rbakx/MyExoMy/Pictures/MyExoMy2.jpg

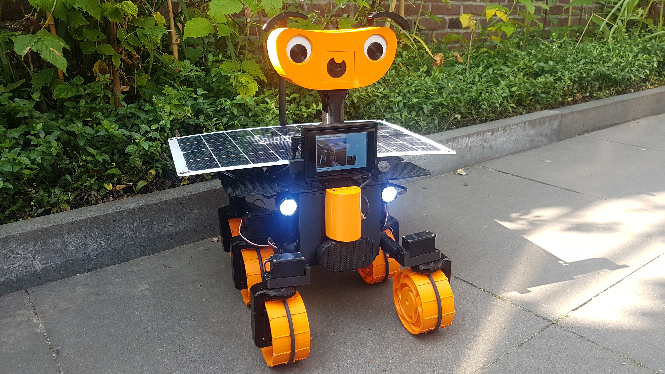
Pictures/MyExoMy2.jpg
