rbakx/MyExoMy/Pictures/MyExoMy3.jpg

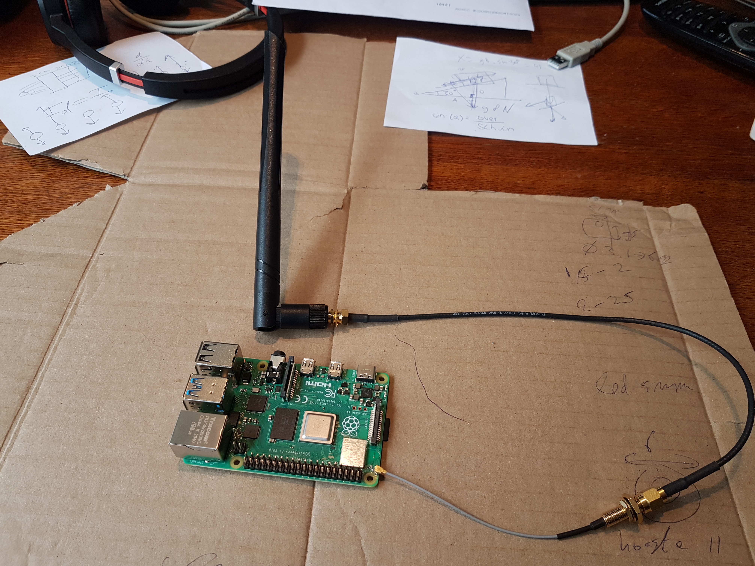
Pictures/MyExoMy3.jpg
