rbakx/MyExoMy/Original_ExoMy Release v1.0.2/README.md

# Release Description

## Bill of Material (BoM)
Contains the purchasing list and a list with recommended print settings of all printed parts.

## Electrical_Drawings
Contains PDF, SVG and JPG of the breadboard as well as the electrical schematic.

## Parts
Contains STL-files for 3D printing, step files for modifications and pictures of all parts and assemblies for visualization.

The naming convention is:

`FILENAME+CONFIGURATION`

and for multi color prints:

`FILENAME+CONFIGURATION+COLOR_NR`

## Technical_Drawings
Contains the technical drawings as PDF and JPEG. And a CSV-file of the bill of material, that is present on the drawing.

## Optional Parts
Contains serval addons that can be used to pimp ExoMy
