rbakx/MyExoMy/Original_ExoMy Release v1.0.2/Parts/PNG/A01_ExoMy_AI_Chassis.png

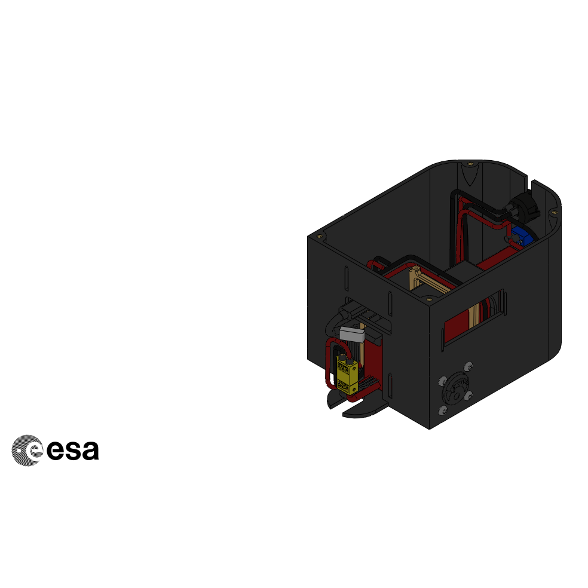
Original_ExoMy Release v1.0.2/Parts/PNG/A01_ExoMy_AI_Chassis.png
