rbakx/MyExoMy/Original_ExoMy Release v1.0.2/Parts/PNG/P01_Chassis_Default.png

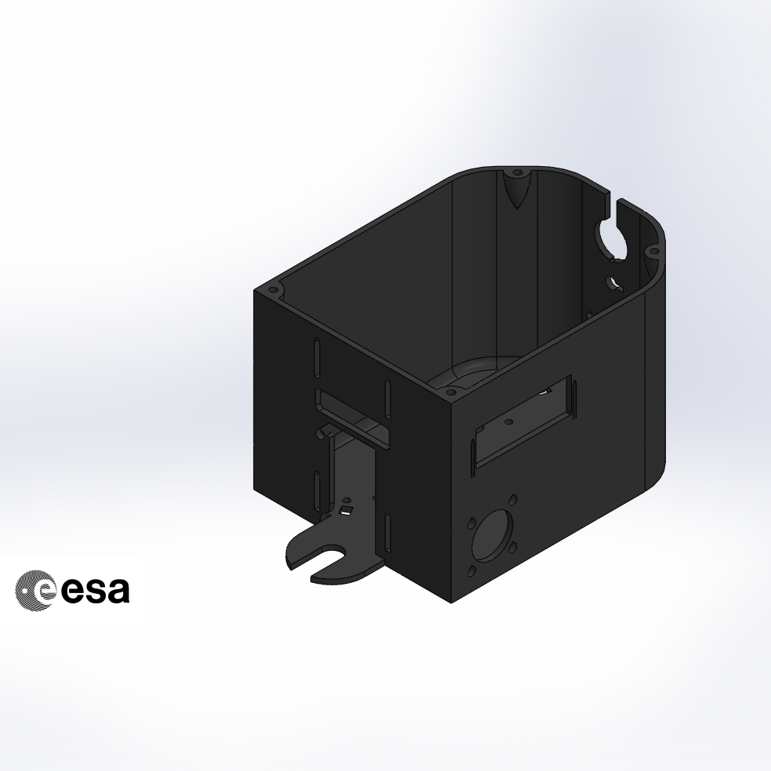
Original_ExoMy Release v1.0.2/Parts/PNG/P01_Chassis_Default.png
