rbakx/MyExoMy/Original_ExoMy Release v1.0.2/Parts/PNG/P06_Spacing_Concept_Default.png

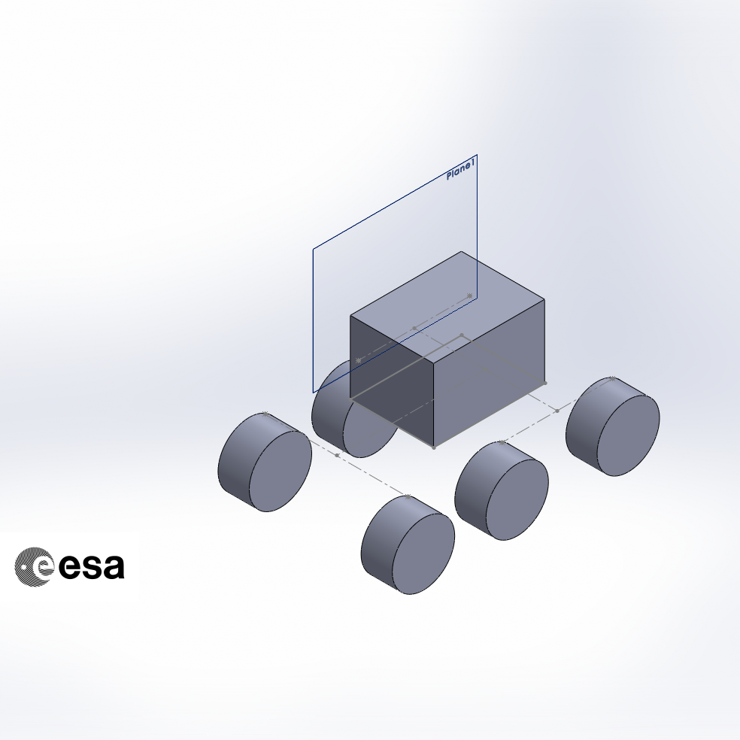
Original_ExoMy Release v1.0.2/Parts/PNG/P06_Spacing_Concept_Default.png
