rbakx/MyExoMy/Original_ExoMy Release v1.0.2/Technical_Drawings/JPEG/AI_Chassis_BoM.jpg

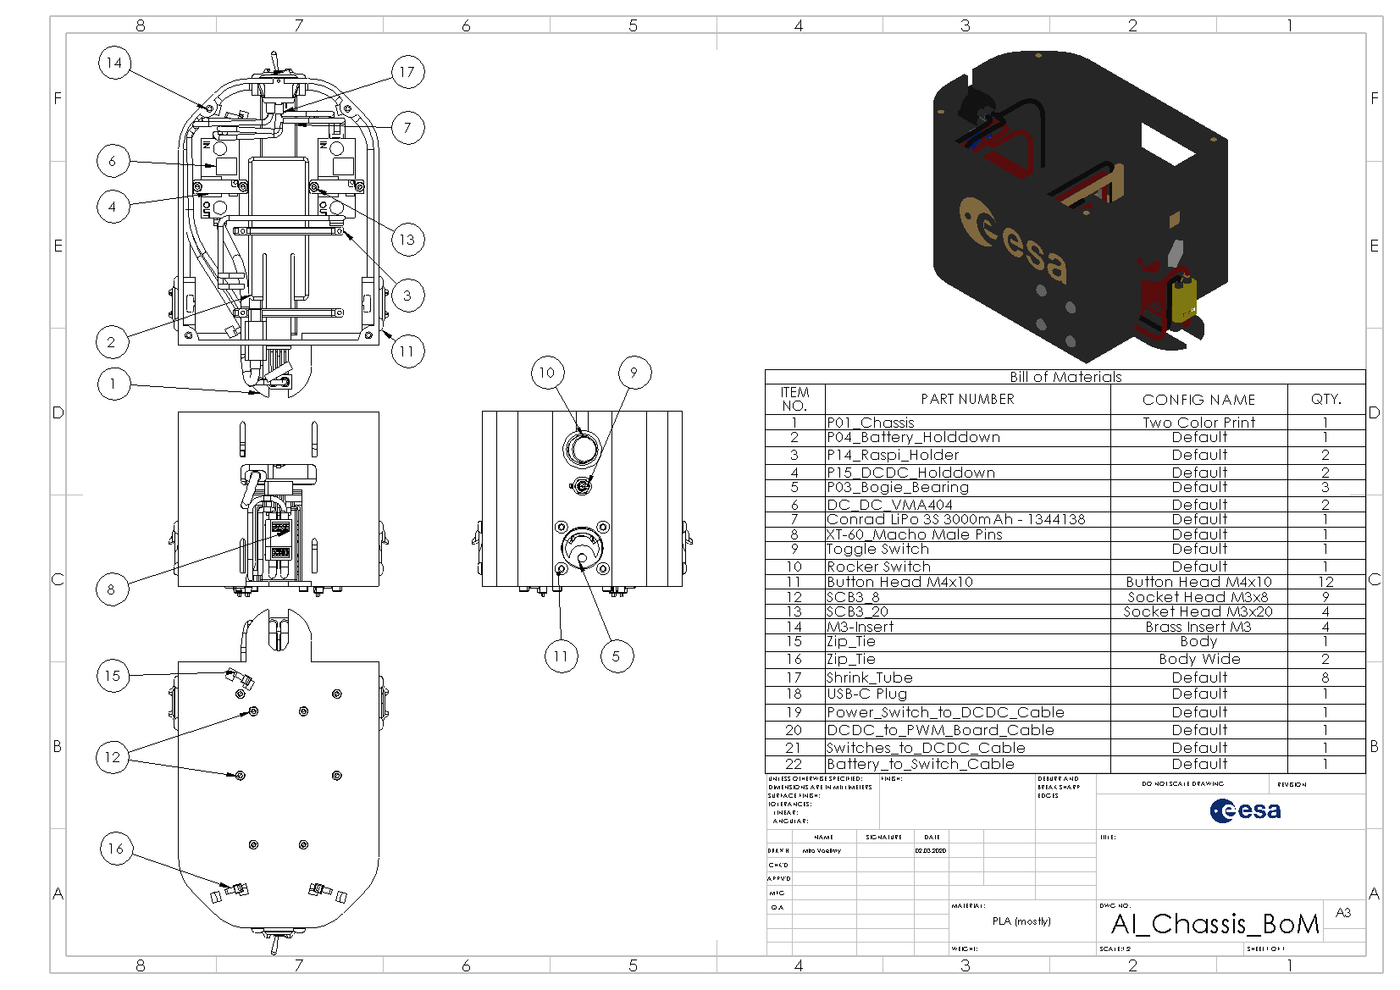
Original_ExoMy Release v1.0.2/Technical_Drawings/JPEG/AI_Chassis_BoM.jpg
