rbakx/MyExoMy/Original_ExoMy Release v1.0.2/Technical_Drawings/JPEG/MI_Wire_Harness_BoM.jpg

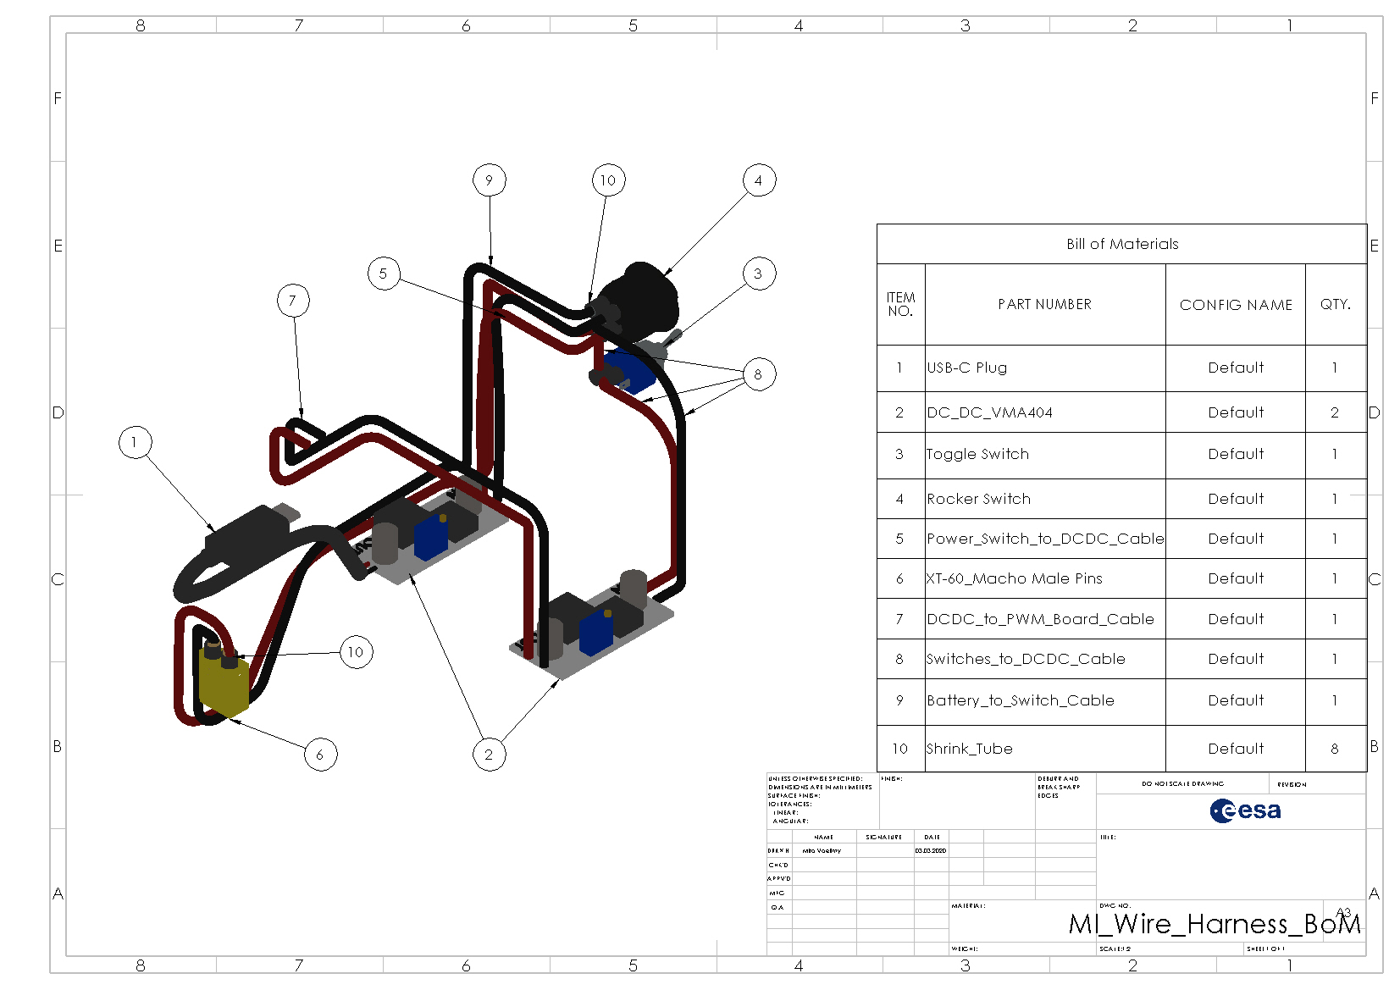
Original_ExoMy Release v1.0.2/Technical_Drawings/JPEG/MI_Wire_Harness_BoM.jpg
