rbakx/MyExoMy/Pictures/MyExoMy4.jpg

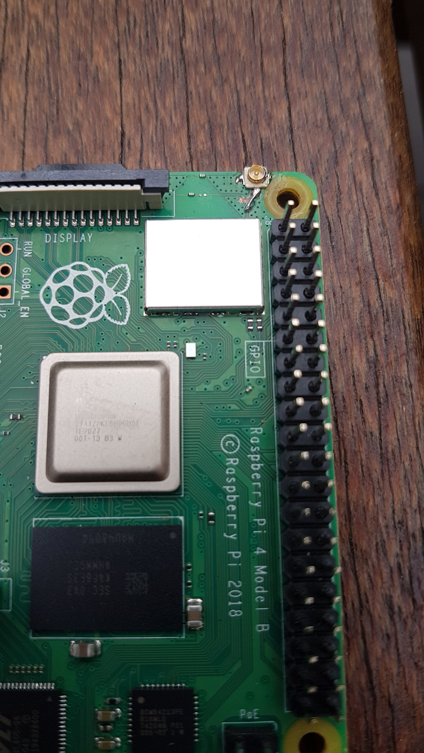
Pictures/MyExoMy4.jpg
