rbakx/MyExoMy/Original_ExoMy Release v1.0.2/Optional_Parts/PNG/A07_Neck_Decoration_Default.png

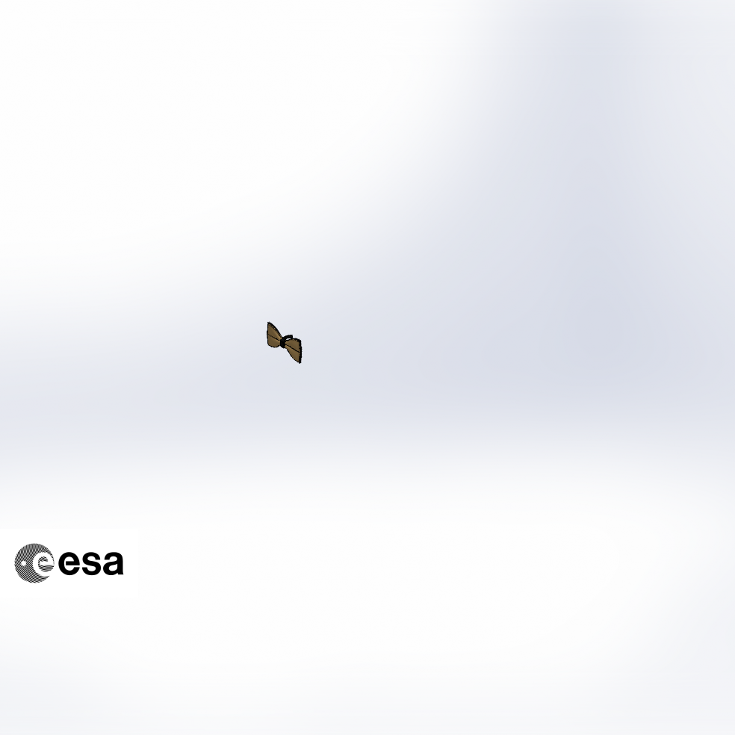
Original_ExoMy Release v1.0.2/Optional_Parts/PNG/A07_Neck_Decoration_Default.png
