rbakx/MyExoMy/Original_ExoMy Release v1.0.2/Optional_Parts/PNG/P34_Hat_Rack_Default.png

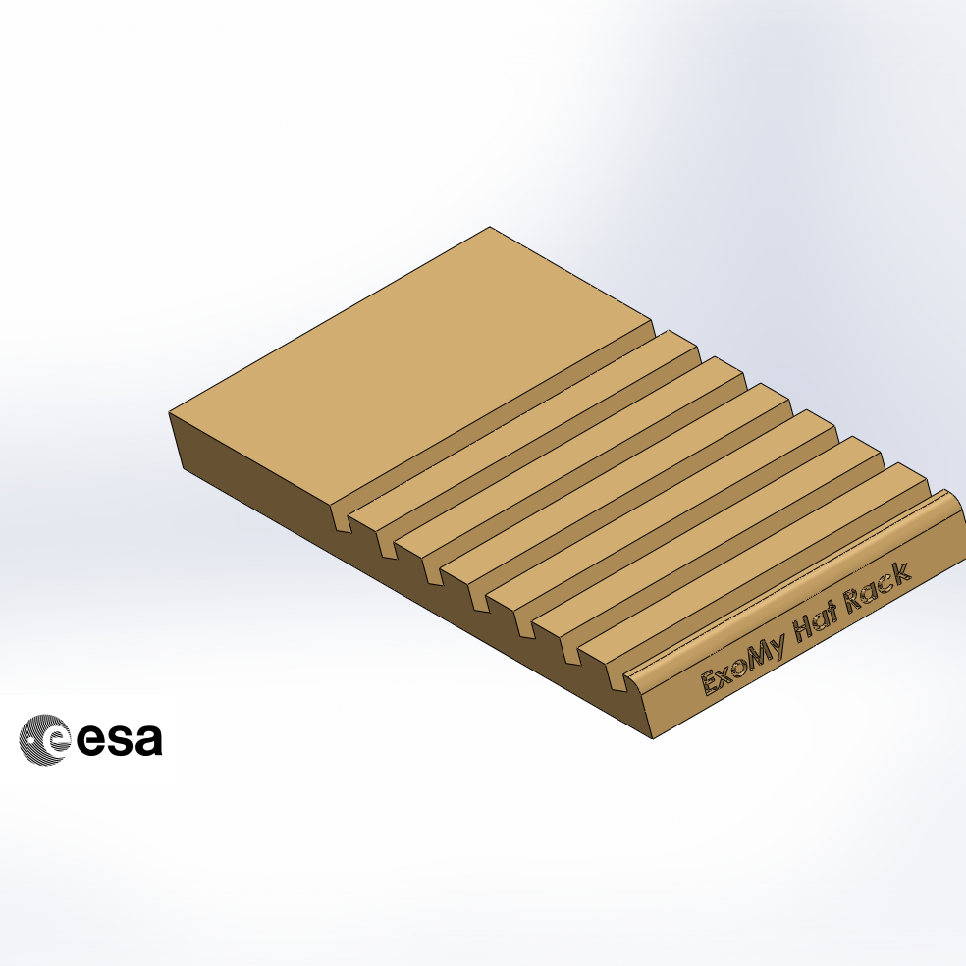
Original_ExoMy Release v1.0.2/Optional_Parts/PNG/P34_Hat_Rack_Default.png
