rbakx/MyExoMy/Original_ExoMy Release v1.0.2/Optional_Parts/PNG/P35_Neck_Clip_Default.png

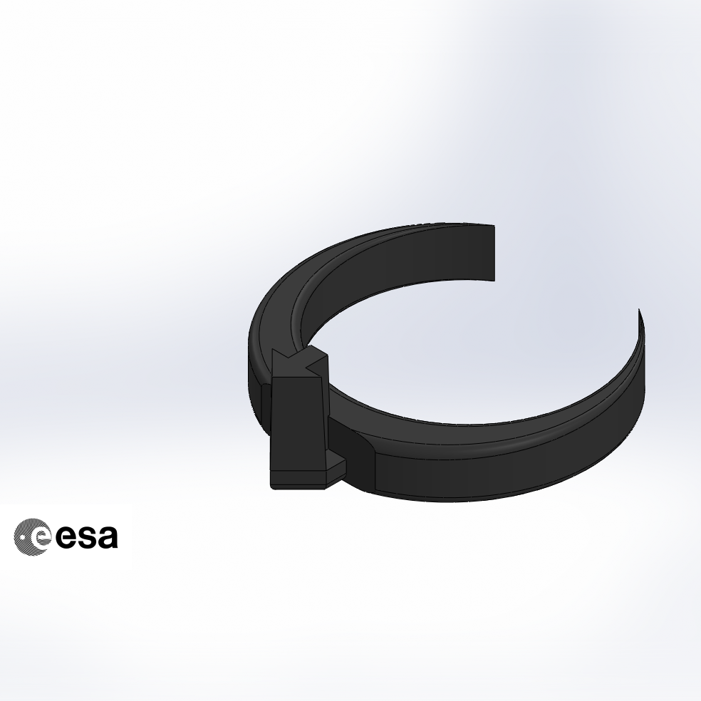
Original_ExoMy Release v1.0.2/Optional_Parts/PNG/P35_Neck_Clip_Default.png
