rbakx/MyExoMy/Original_ExoMy Release v1.0.2/Optional_Parts/PNG/P37_Wheel_Sleeve_Full_Sleeve_Left.PNG

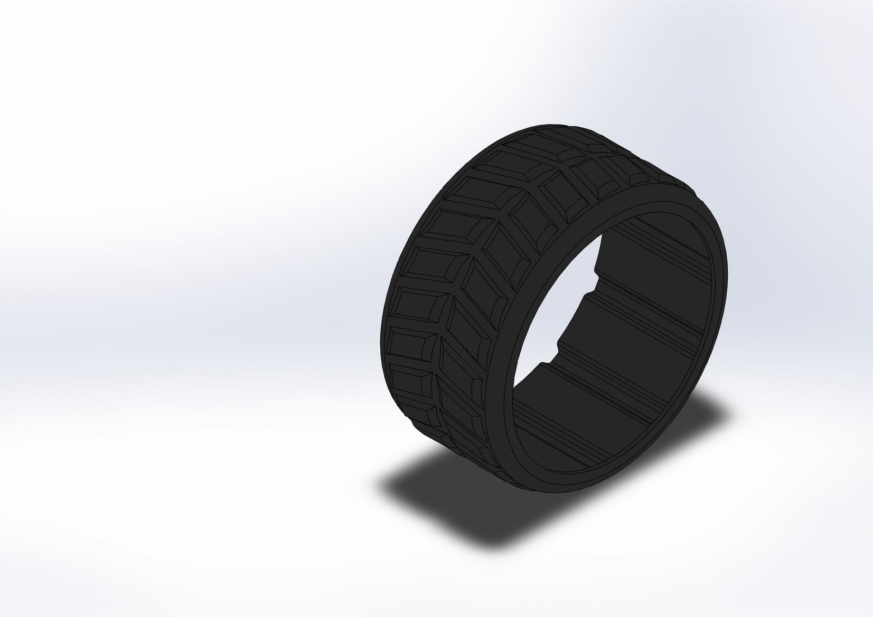
Original_ExoMy Release v1.0.2/Optional_Parts/PNG/P37_Wheel_Sleeve_Full_Sleeve_Left.PNG
