rbakx/MyExoMy/Original_ExoMy Release v1.0.2/Parts/PNG/A05_Bogie_AI_Rear_Bogie.png

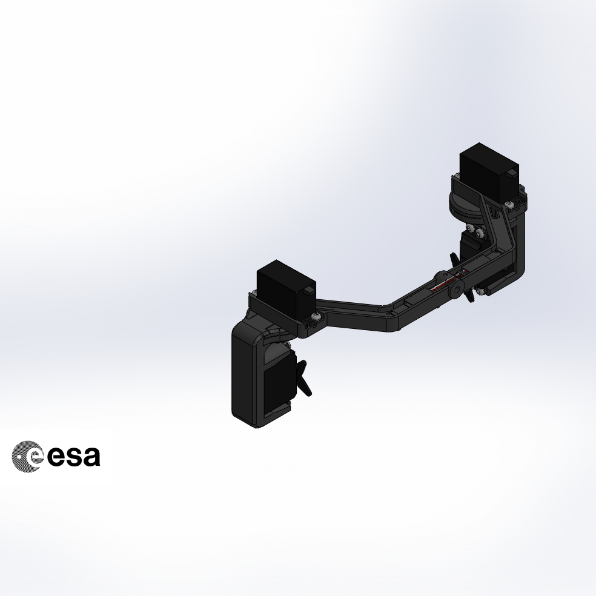
Original_ExoMy Release v1.0.2/Parts/PNG/A05_Bogie_AI_Rear_Bogie.png
