rbakx/MyExoMy/Original_ExoMy Release v1.0.2/Parts/PNG/A06_Head_Default.png

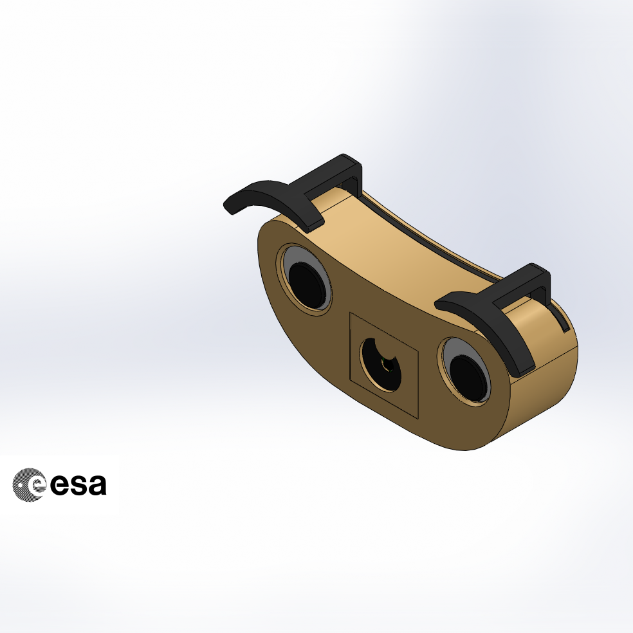
Original_ExoMy Release v1.0.2/Parts/PNG/A06_Head_Default.png
