rbakx/MyExoMy/Original_ExoMy Release v1.0.2/Parts/PNG/A08_Top_Assembly_MI_Printed_Parts.png

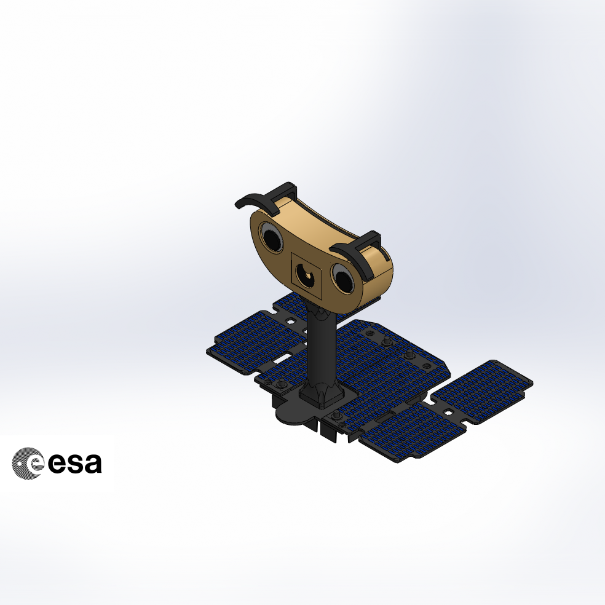
Original_ExoMy Release v1.0.2/Parts/PNG/A08_Top_Assembly_MI_Printed_Parts.png
