rbakx/MyExoMy/Original_ExoMy Release v1.0.2/Parts/PNG/Adafruit PWM Servo HAT_Default.png

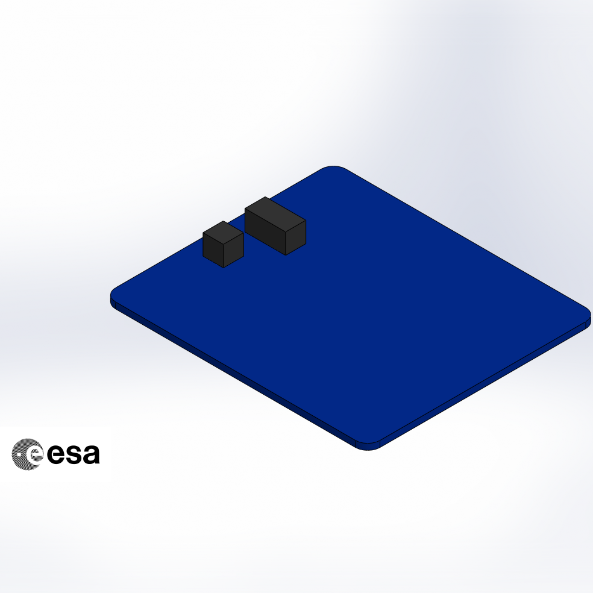
Original_ExoMy Release v1.0.2/Parts/PNG/Adafruit PWM Servo HAT_Default.png
