rbakx/MyExoMy/Original_ExoMy Release v1.0.2/Parts/PNG/Battery Alarm_Default.png

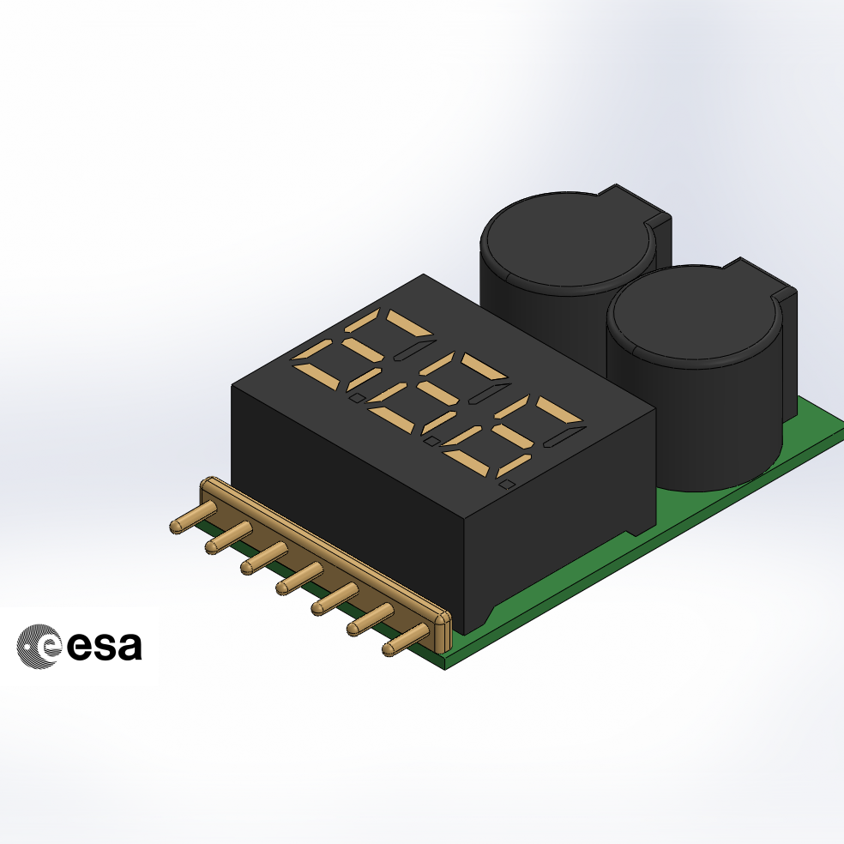
Original_ExoMy Release v1.0.2/Parts/PNG/Battery Alarm_Default.png
