rbakx/MyExoMy/Original_ExoMy Release v1.0.2/Parts/PNG/Battery_to_Switch_Cable_Default.png

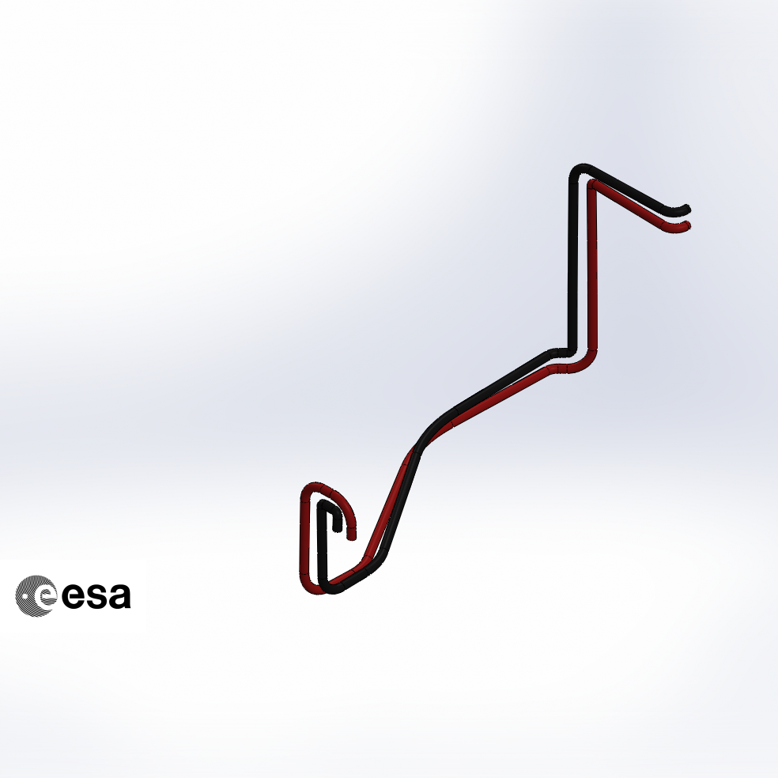
Original_ExoMy Release v1.0.2/Parts/PNG/Battery_to_Switch_Cable_Default.png
