rbakx/MyExoMy/Original_ExoMy Release v1.0.2/Parts/PNG/Conrad LiPo 3S 3000mAh - 1344138_Default.png

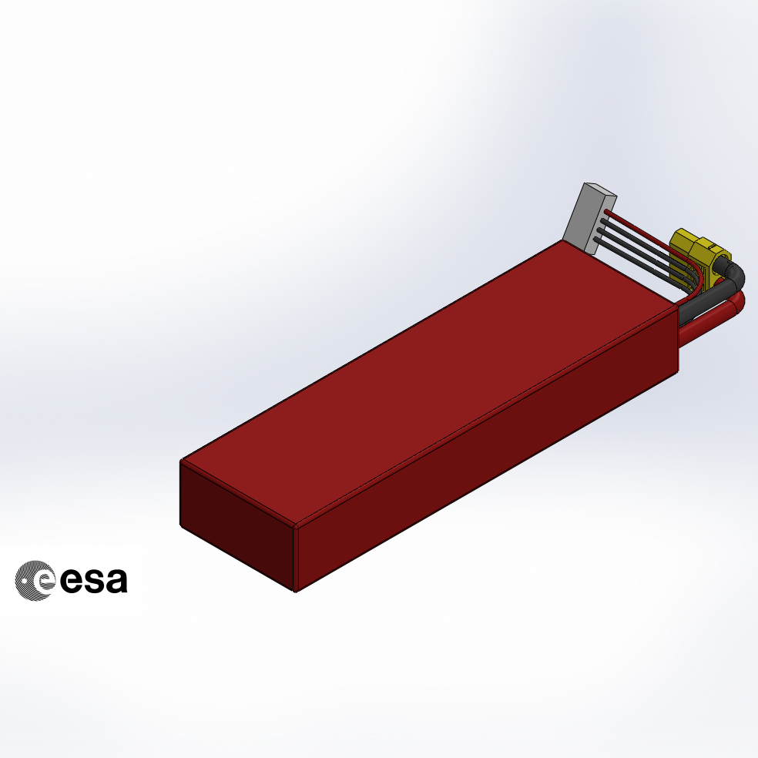
Original_ExoMy Release v1.0.2/Parts/PNG/Conrad LiPo 3S 3000mAh - 1344138_Default.png
