rbakx/MyExoMy/Original_ExoMy Release v1.0.2/Parts/PNG/CSHBTS-SUS-M3-10_CSHBTS-SUS-M3-10.png

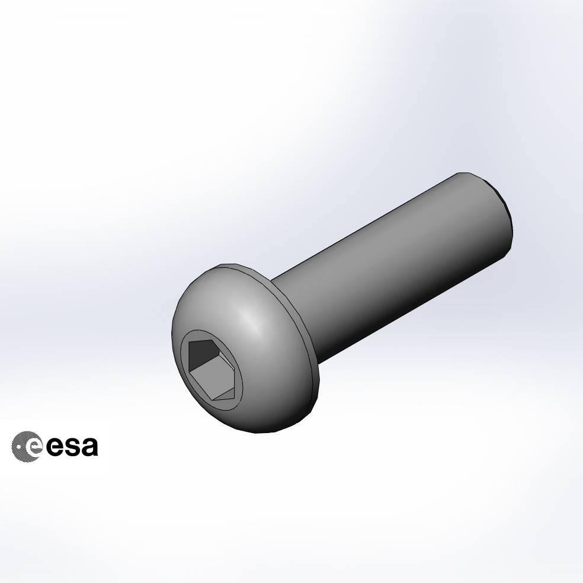
Original_ExoMy Release v1.0.2/Parts/PNG/CSHBTS-SUS-M3-10_CSHBTS-SUS-M3-10.png
