rbakx/MyExoMy/Original_ExoMy Release v1.0.2/Parts/PNG/CSHBTS-SUS-M4-10_Button Head M4x10.png

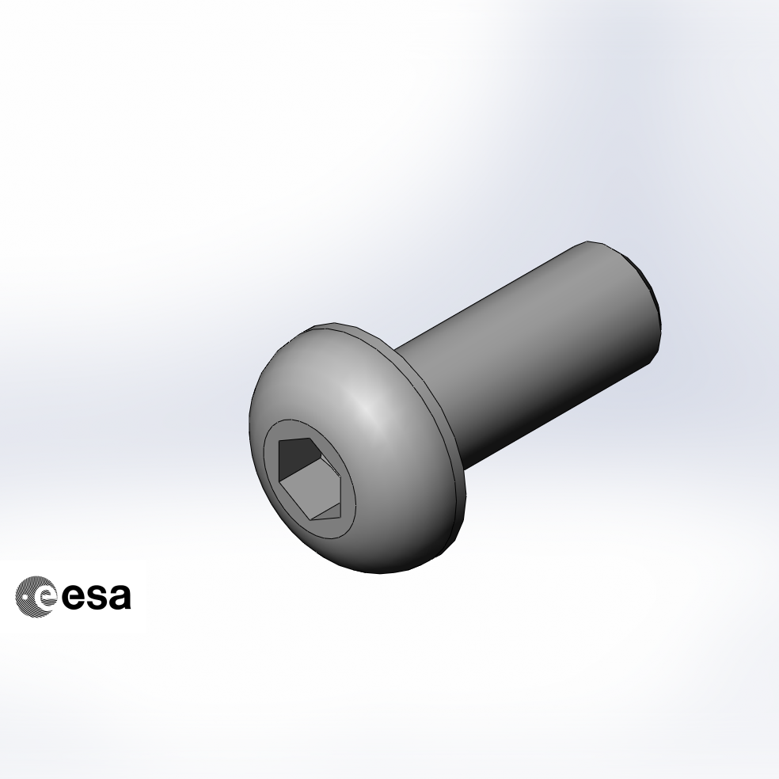
Original_ExoMy Release v1.0.2/Parts/PNG/CSHBTS-SUS-M4-10_Button Head M4x10.png
