rbakx/MyExoMy/Original_ExoMy Release v1.0.2/Parts/PNG/DC_DC_VMA404_Default.png

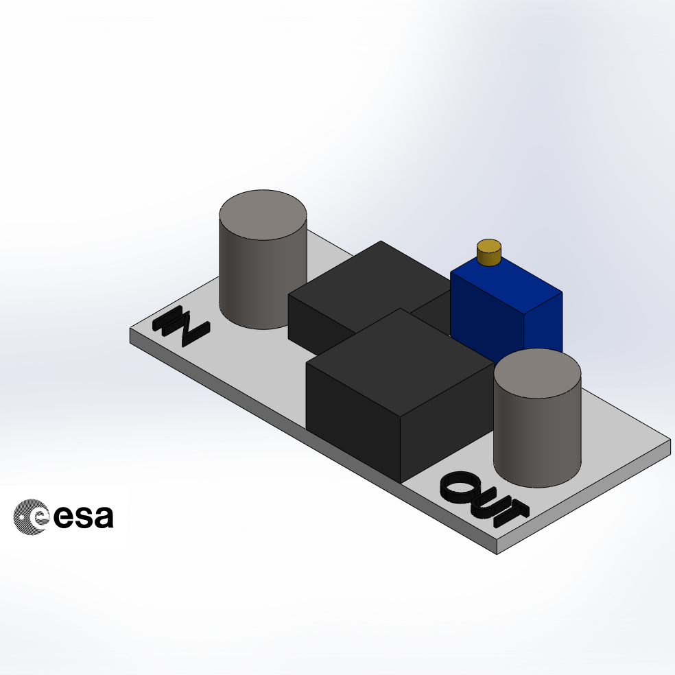
Original_ExoMy Release v1.0.2/Parts/PNG/DC_DC_VMA404_Default.png
