rbakx/MyExoMy/Original_ExoMy Release v1.0.2/Parts/PNG/DCDC_to_PWM_Board_Cable_Default.png

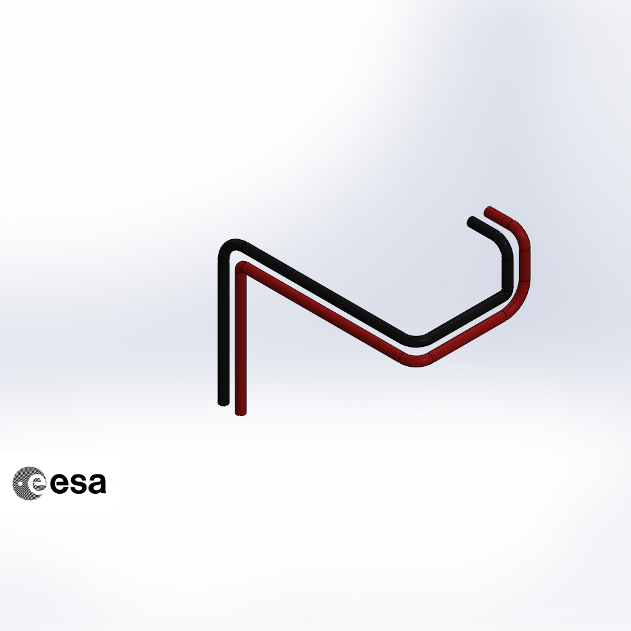
Original_ExoMy Release v1.0.2/Parts/PNG/DCDC_to_PWM_Board_Cable_Default.png
