rbakx/MyExoMy/Original_ExoMy Release v1.0.2/Parts/PNG/Long_Camera_Cabel_Default.png

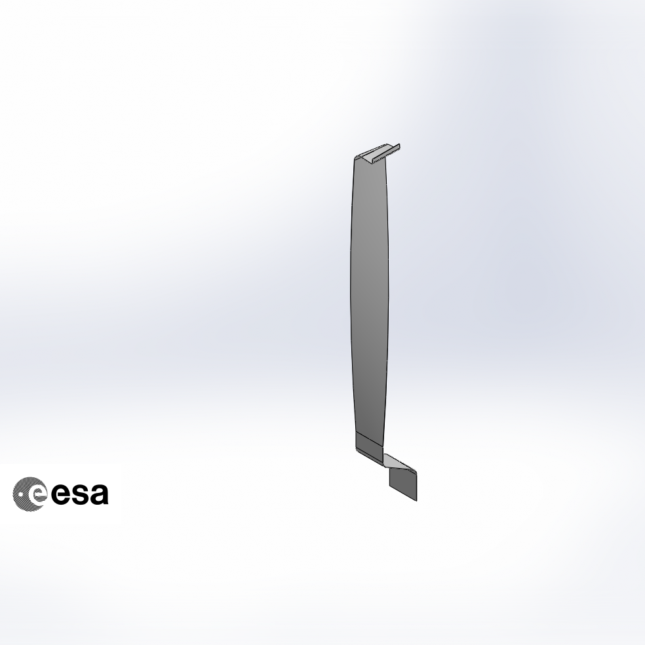
Original_ExoMy Release v1.0.2/Parts/PNG/Long_Camera_Cabel_Default.png
