rbakx/MyExoMy/Original_ExoMy Release v1.0.2/Parts/PNG/M2_5x11_Standoff M2.5x11.png

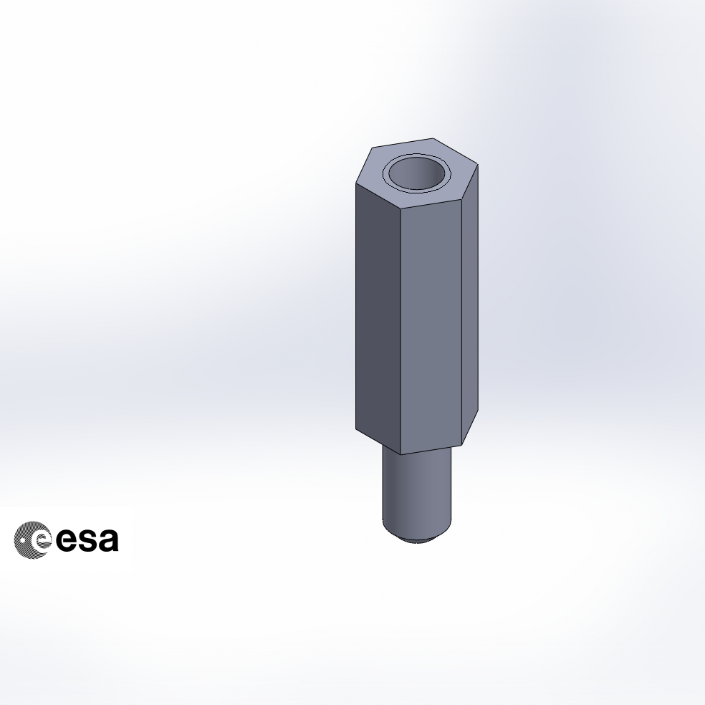
Original_ExoMy Release v1.0.2/Parts/PNG/M2_5x11_Standoff M2.5x11.png
