rbakx/MyExoMy/Original_ExoMy Release v1.0.2/Parts/PNG/M3-Insert_Brass Insert M3.png

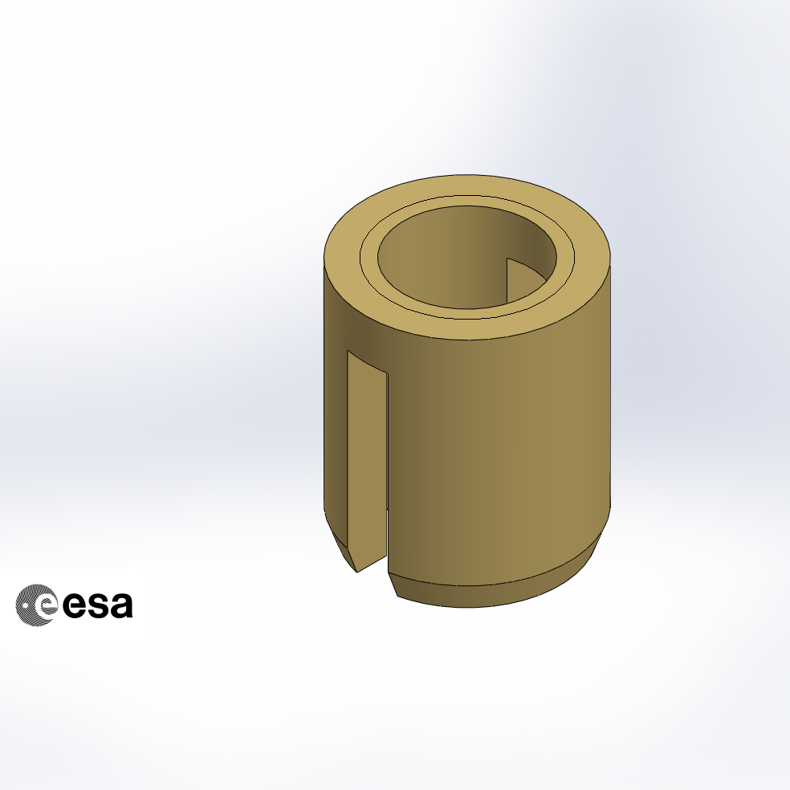
Original_ExoMy Release v1.0.2/Parts/PNG/M3-Insert_Brass Insert M3.png
