rbakx/MyExoMy/Original_ExoMy Release v1.0.2/Parts/PNG/Mini-HDMI Plug_Default.png

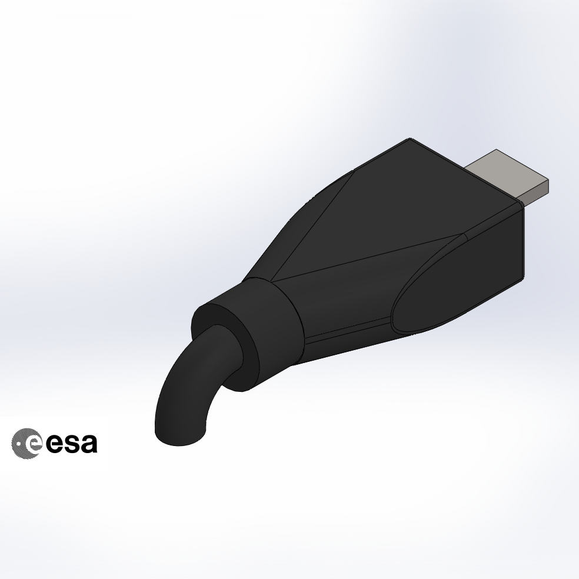
Original_ExoMy Release v1.0.2/Parts/PNG/Mini-HDMI Plug_Default.png
