rbakx/MyExoMy/Original_ExoMy Release v1.0.2/Parts/PNG/P03_Bogie_Bearing_Default.png

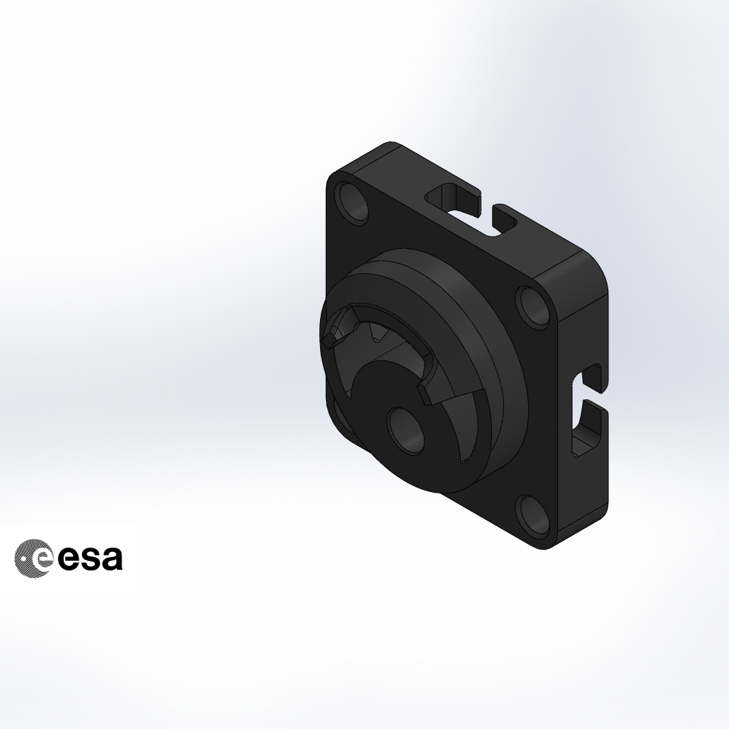
Original_ExoMy Release v1.0.2/Parts/PNG/P03_Bogie_Bearing_Default.png
