rbakx/MyExoMy/Original_ExoMy Release v1.0.2/Parts/PNG/P04_Battery_Holddown_Default.png

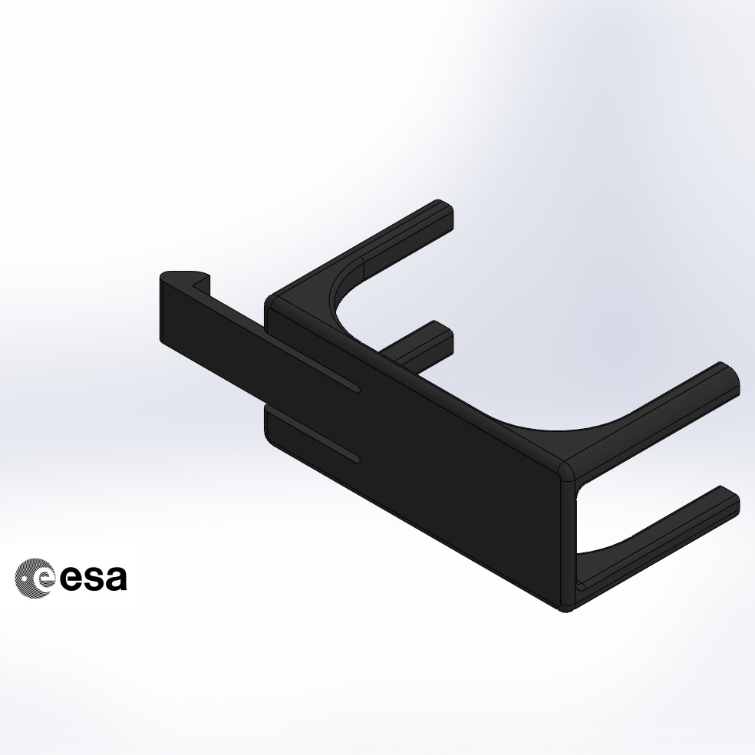
Original_ExoMy Release v1.0.2/Parts/PNG/P04_Battery_Holddown_Default.png
