rbakx/MyExoMy/Original_ExoMy Release v1.0.2/Parts/PNG/P11_Top_Default.png

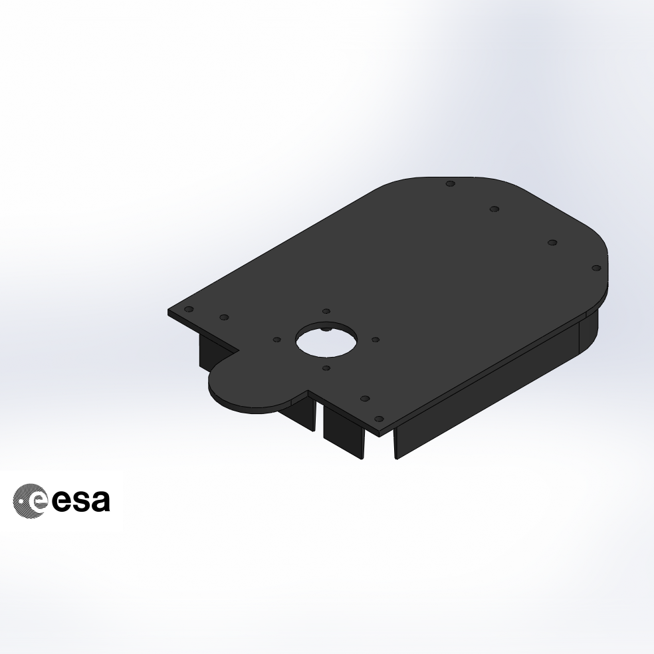
Original_ExoMy Release v1.0.2/Parts/PNG/P11_Top_Default.png
