rbakx/MyExoMy/Original_ExoMy Release v1.0.2/Parts/PNG/P12_Solar_Panel_Left.png

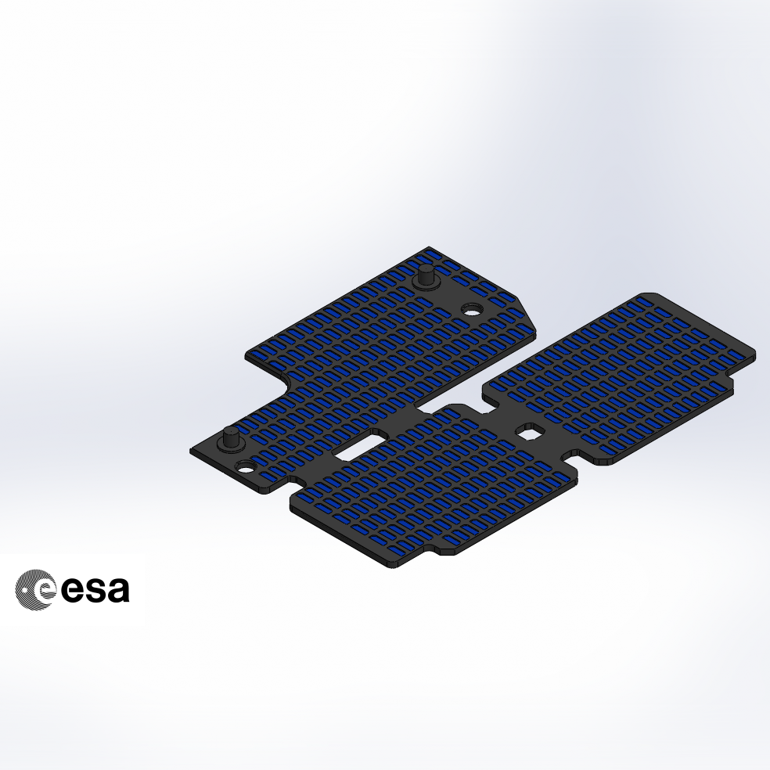
Original_ExoMy Release v1.0.2/Parts/PNG/P12_Solar_Panel_Left.png
