rbakx/MyExoMy/Original_ExoMy Release v1.0.2/Parts/PNG/P13_Port_Cover_Default.png

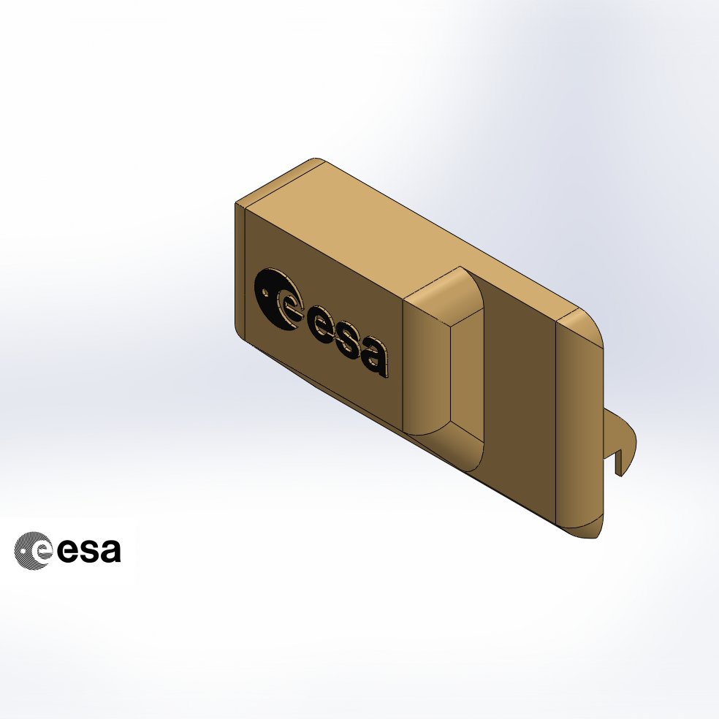
Original_ExoMy Release v1.0.2/Parts/PNG/P13_Port_Cover_Default.png
