rbakx/MyExoMy/Original_ExoMy Release v1.0.2/Parts/PNG/P14_Raspi_Holder_Default.png

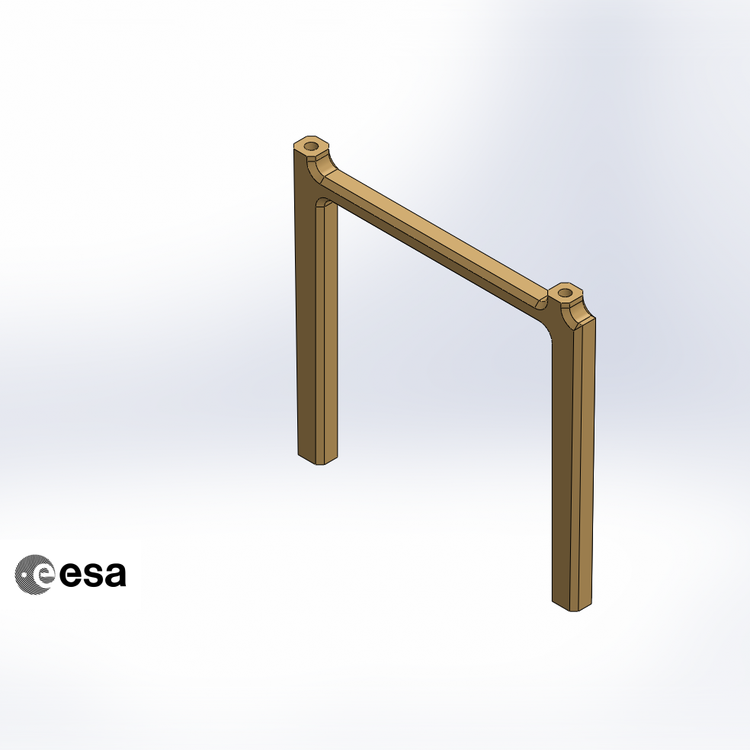
Original_ExoMy Release v1.0.2/Parts/PNG/P14_Raspi_Holder_Default.png
