rbakx/MyExoMy/Original_ExoMy Release v1.0.2/Parts/PNG/P15_DCDC_Holddown_Default.png

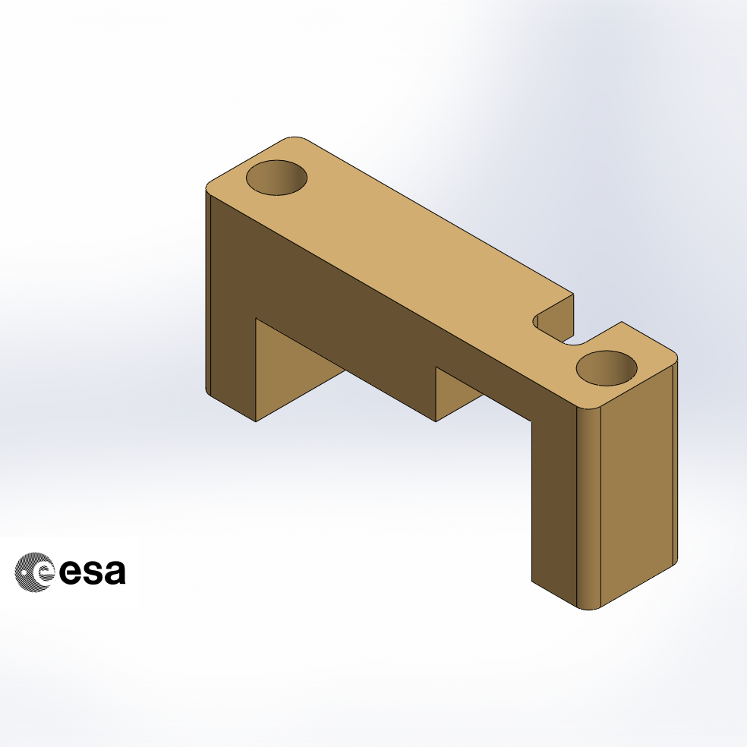
Original_ExoMy Release v1.0.2/Parts/PNG/P15_DCDC_Holddown_Default.png
