rbakx/MyExoMy/Original_ExoMy Release v1.0.2/Parts/PNG/P17_Bogie_Cable_Cover_Rear Cover.png

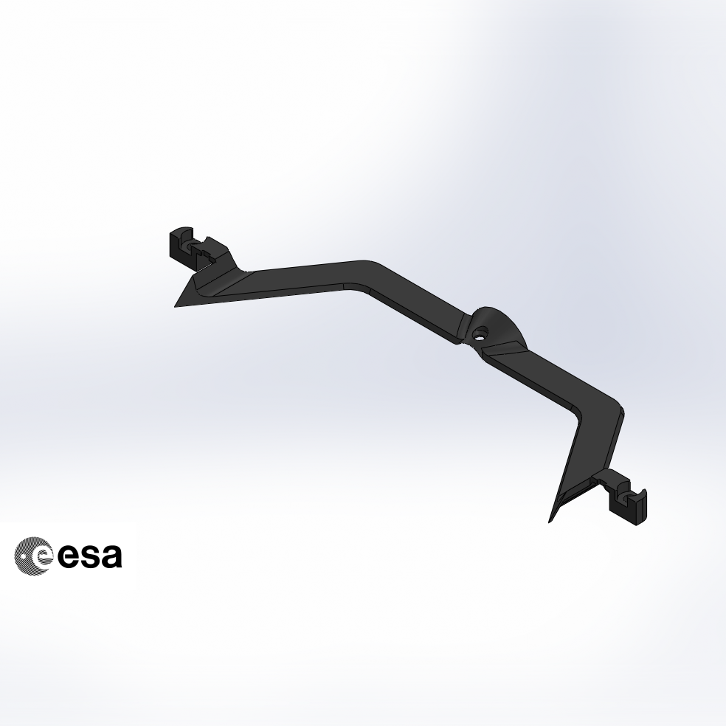
Original_ExoMy Release v1.0.2/Parts/PNG/P17_Bogie_Cable_Cover_Rear Cover.png
