rbakx/MyExoMy/Original_ExoMy Release v1.0.2/Parts/PNG/P19_Bogie_Rear Bogie.png

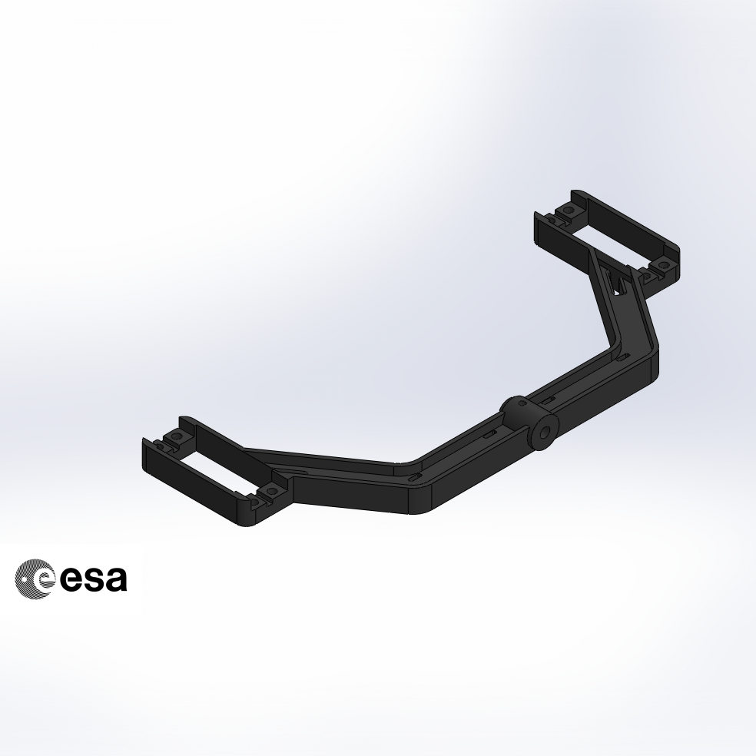
Original_ExoMy Release v1.0.2/Parts/PNG/P19_Bogie_Rear Bogie.png
