rbakx/MyExoMy/Original_ExoMy Release v1.0.2/Parts/PNG/P24_Mouth_Latch_Default.png

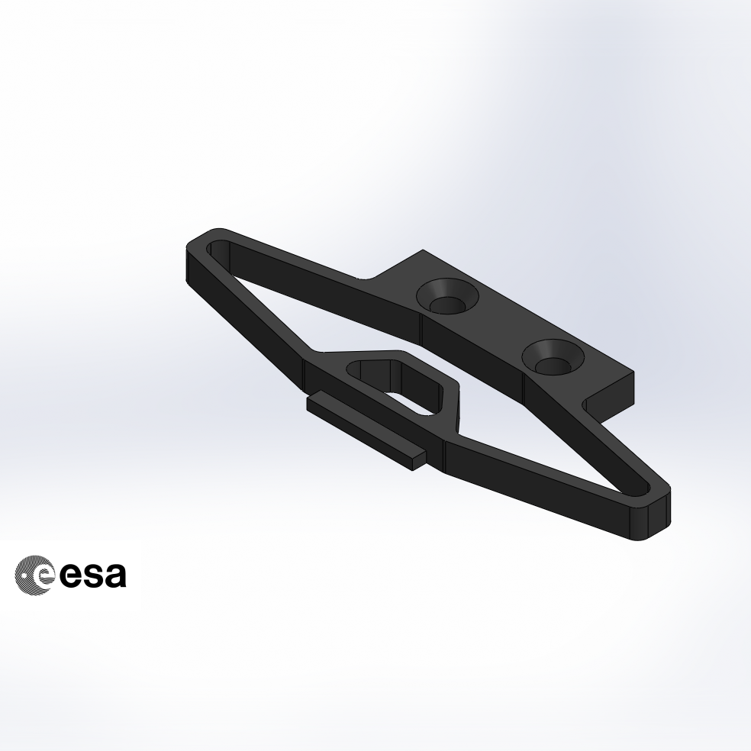
Original_ExoMy Release v1.0.2/Parts/PNG/P24_Mouth_Latch_Default.png
