rbakx/MyExoMy/Original_ExoMy Release v1.0.2/Parts/PNG/P25_Mouth_Moustache.png

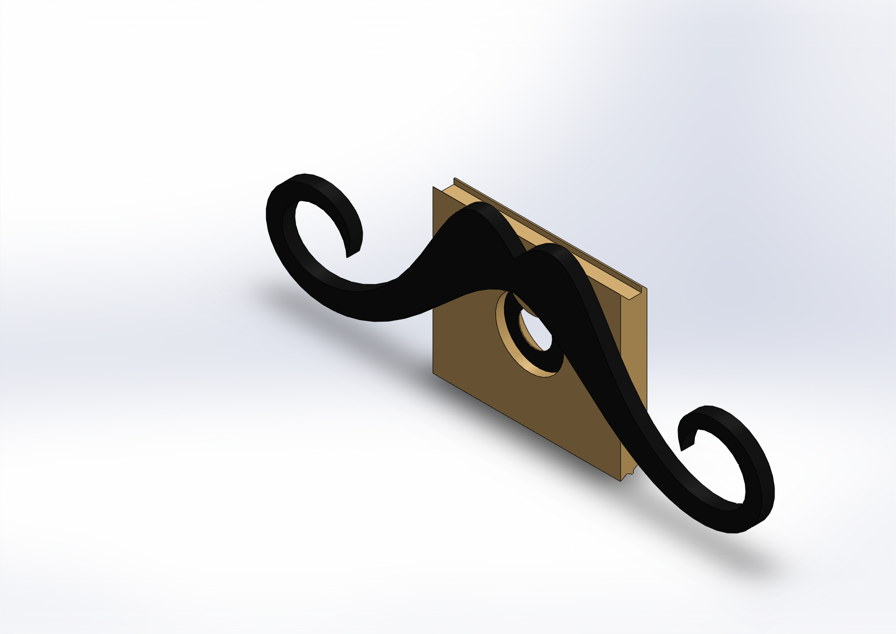
Original_ExoMy Release v1.0.2/Parts/PNG/P25_Mouth_Moustache.png
