rbakx/MyExoMy/Original_ExoMy Release v1.0.2/Parts/PNG/P26_Hat_Eyebrows.png

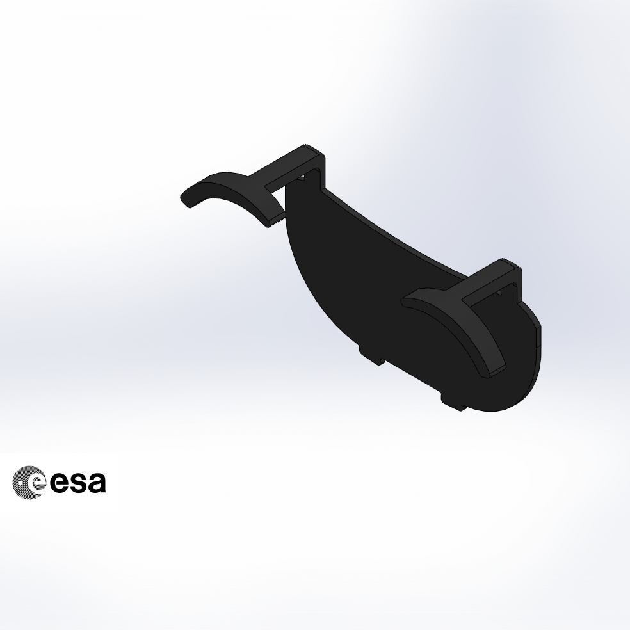
Original_ExoMy Release v1.0.2/Parts/PNG/P26_Hat_Eyebrows.png
