rbakx/MyExoMy/Original_ExoMy Release v1.0.2/Parts/PNG/P26_Hat_Wizard.png

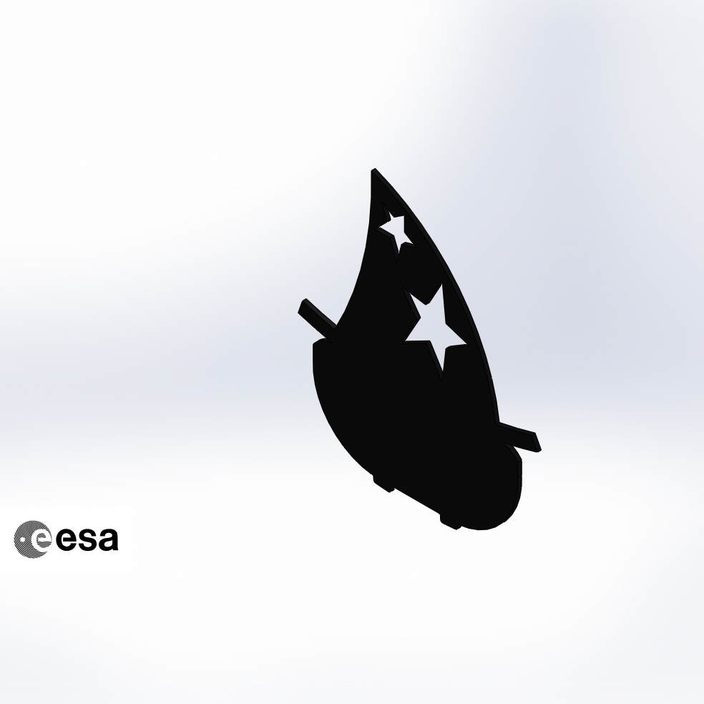
Original_ExoMy Release v1.0.2/Parts/PNG/P26_Hat_Wizard.png
