rbakx/MyExoMy/Original_ExoMy Release v1.0.2/Parts/PNG/P29_Wheel_Bracket_Fixing_Plate_Default.png

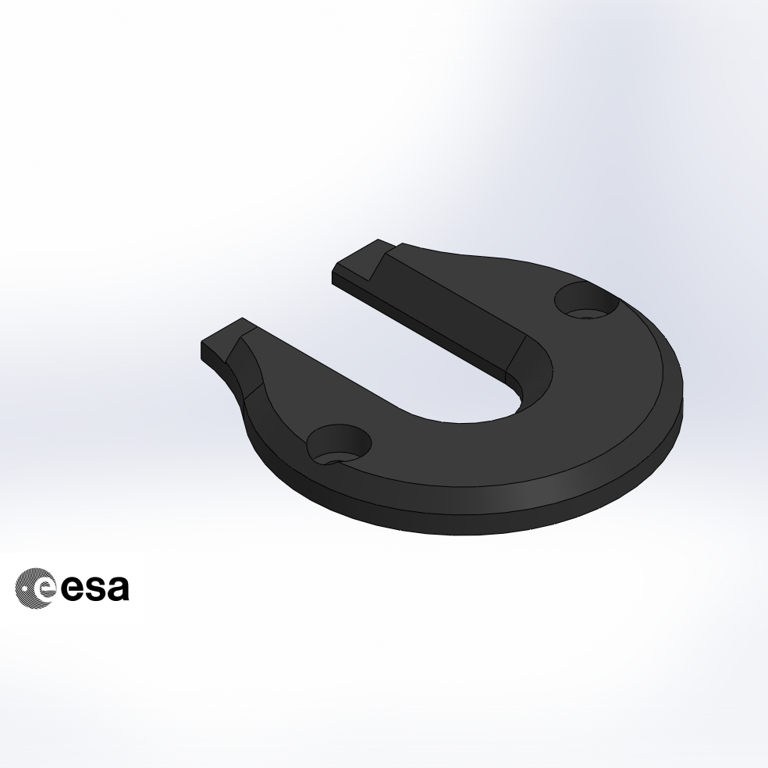
Original_ExoMy Release v1.0.2/Parts/PNG/P29_Wheel_Bracket_Fixing_Plate_Default.png
