rbakx/MyExoMy/Original_ExoMy Release v1.0.2/Parts/PNG/P30_Wheel_Default.png

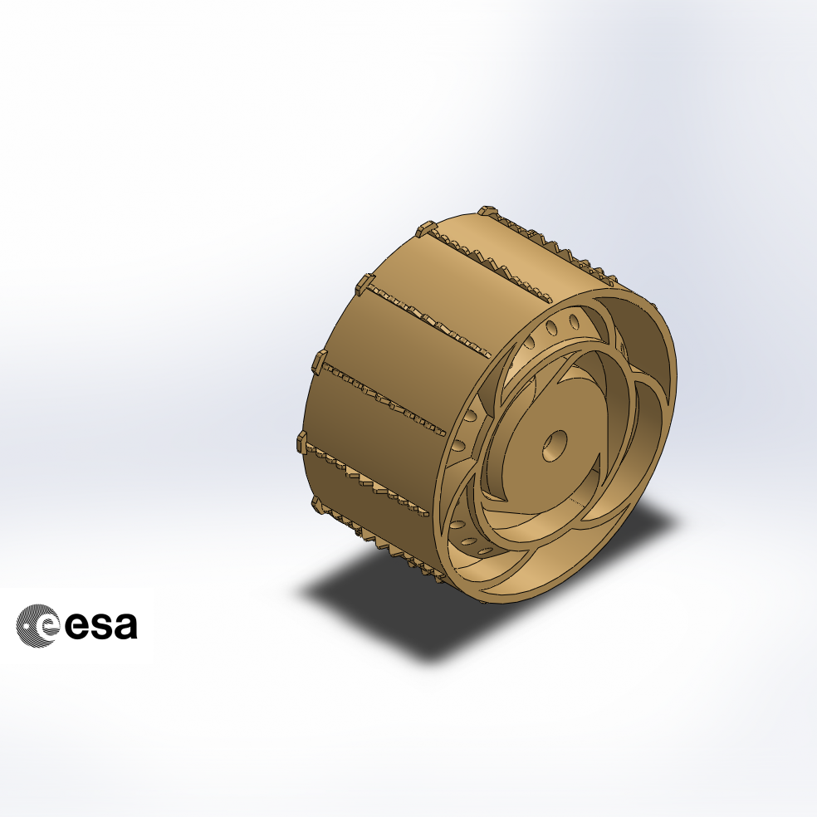
Original_ExoMy Release v1.0.2/Parts/PNG/P30_Wheel_Default.png
