rbakx/MyExoMy/Original_ExoMy Release v1.0.2/Parts/PNG/P32_Wheel_Fixing_Plate_U_Shape_Default.png

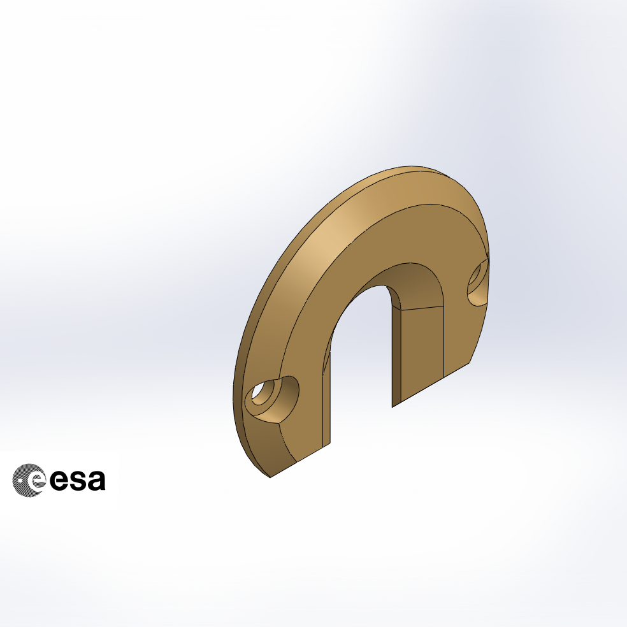
Original_ExoMy Release v1.0.2/Parts/PNG/P32_Wheel_Fixing_Plate_U_Shape_Default.png
