rbakx/MyExoMy/Original_ExoMy Release v1.0.2/Parts/PNG/P33_Cam_Holder_Flat_Default.png

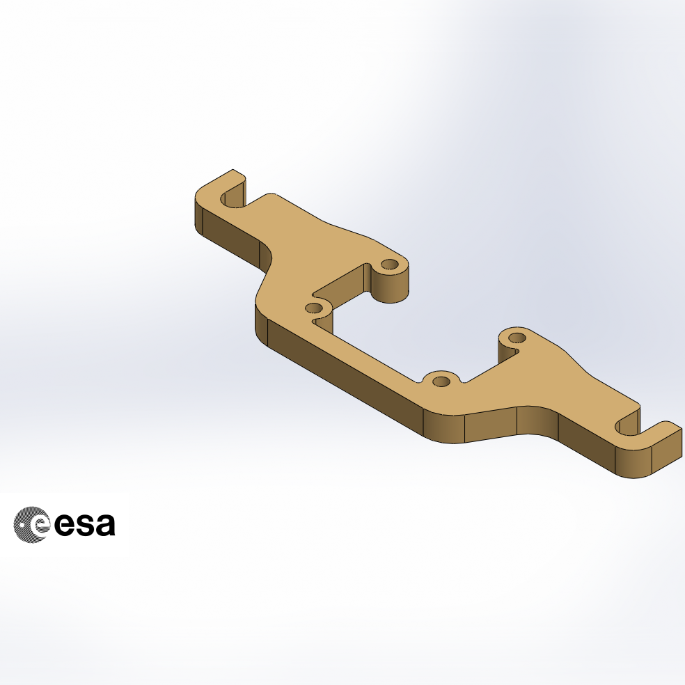
Original_ExoMy Release v1.0.2/Parts/PNG/P33_Cam_Holder_Flat_Default.png
