rbakx/MyExoMy/Original_ExoMy Release v1.0.2/Parts/PNG/Parallax-Servo-ASM_Continuous.png

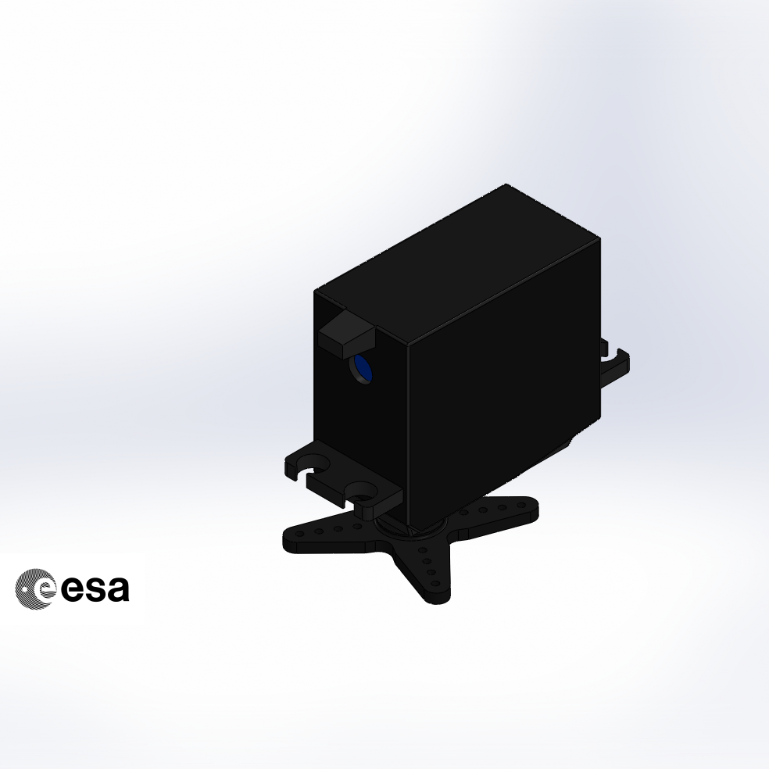
Original_ExoMy Release v1.0.2/Parts/PNG/Parallax-Servo-ASM_Continuous.png
