rbakx/MyExoMy/Original_ExoMy Release v1.0.2/Parts/PNG/Parallax-Servo-ASM_Steering Modded.png

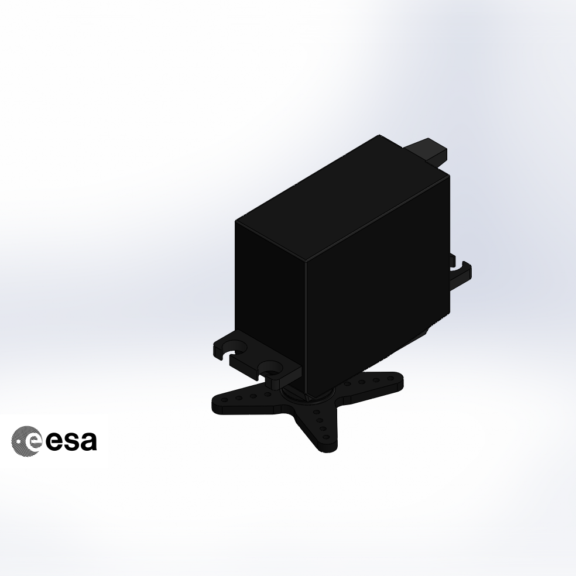
Original_ExoMy Release v1.0.2/Parts/PNG/Parallax-Servo-ASM_Steering Modded.png
