rbakx/MyExoMy/Original_ExoMy Release v1.0.2/Parts/PNG/PI_ExoMy_All_Parts_BoM_Sheet1.png

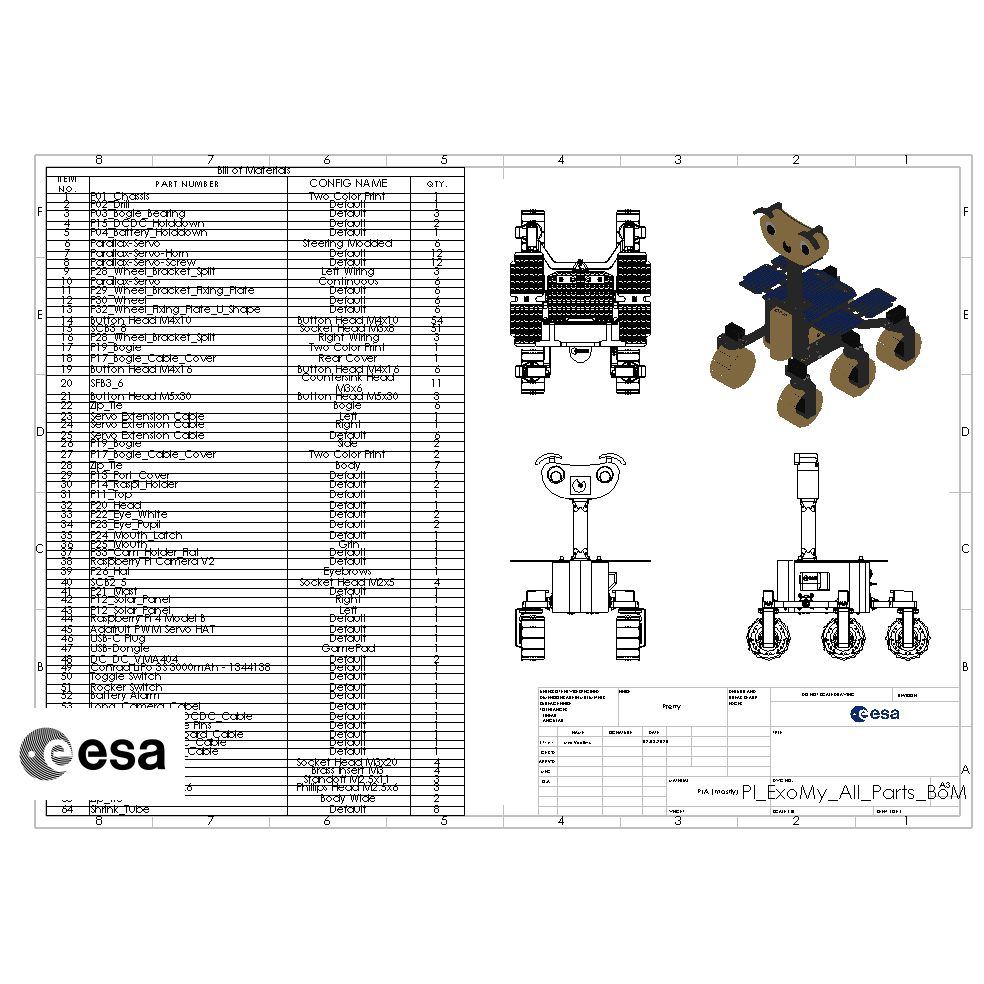
Original_ExoMy Release v1.0.2/Parts/PNG/PI_ExoMy_All_Parts_BoM_Sheet1.png
