rbakx/MyExoMy/Original_ExoMy Release v1.0.2/Parts/PNG/Power_Switch_to_DCDC_Cable_Default.png

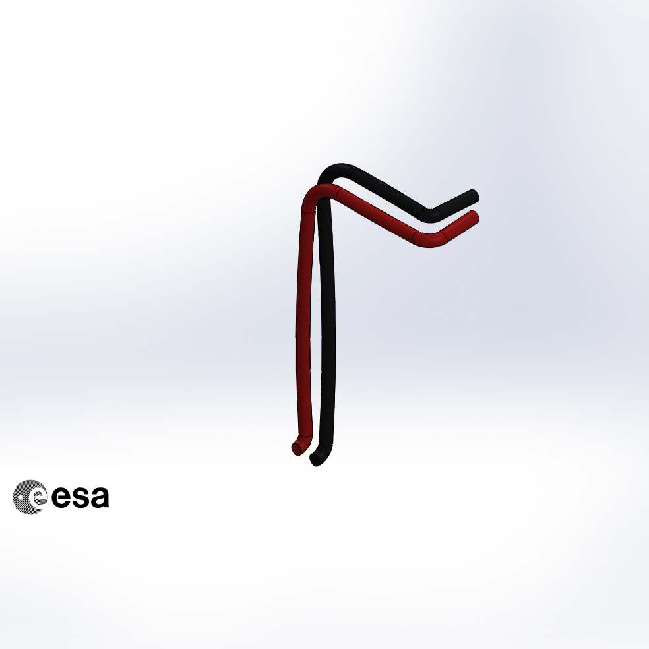
Original_ExoMy Release v1.0.2/Parts/PNG/Power_Switch_to_DCDC_Cable_Default.png
