rbakx/MyExoMy/Original_ExoMy Release v1.0.2/Parts/PNG/Raspberry Pi 3 Model B+_Default.png

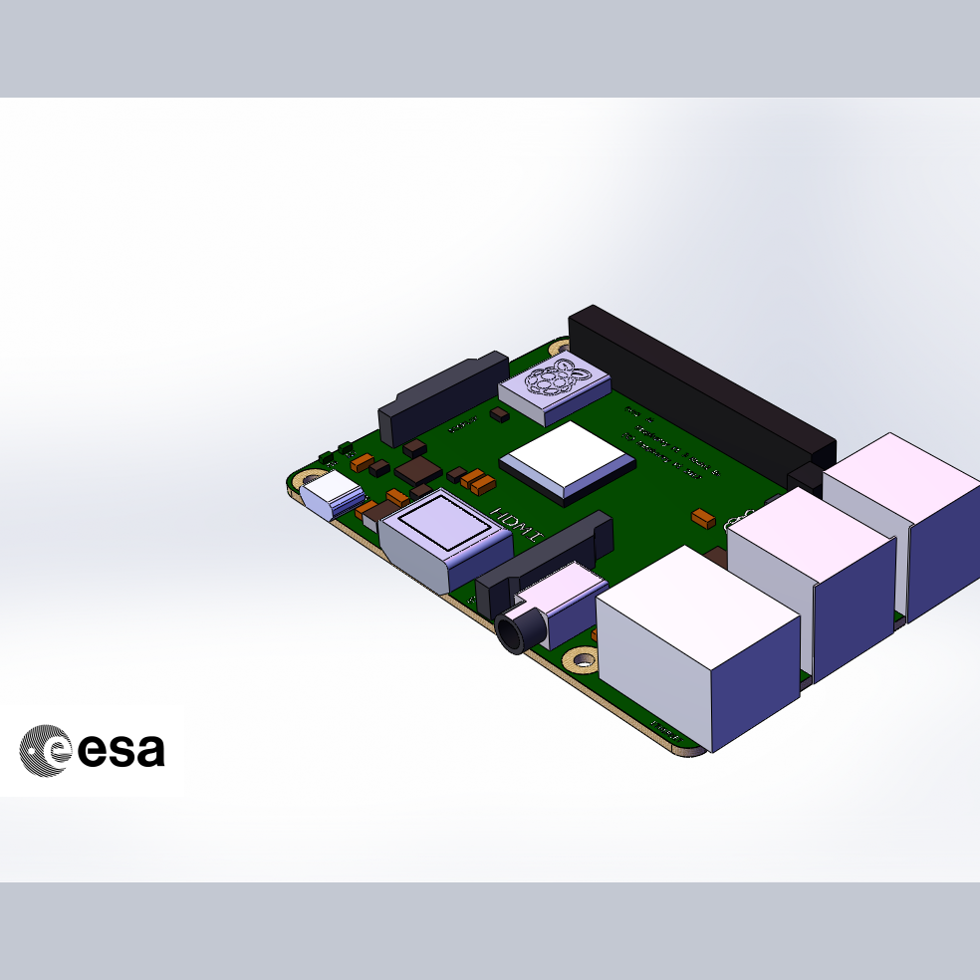
Original_ExoMy Release v1.0.2/Parts/PNG/Raspberry Pi 3 Model B+_Default.png
