rbakx/MyExoMy/Original_ExoMy Release v1.0.2/Parts/PNG/Raspberry Pi 4 Model B_Default.png

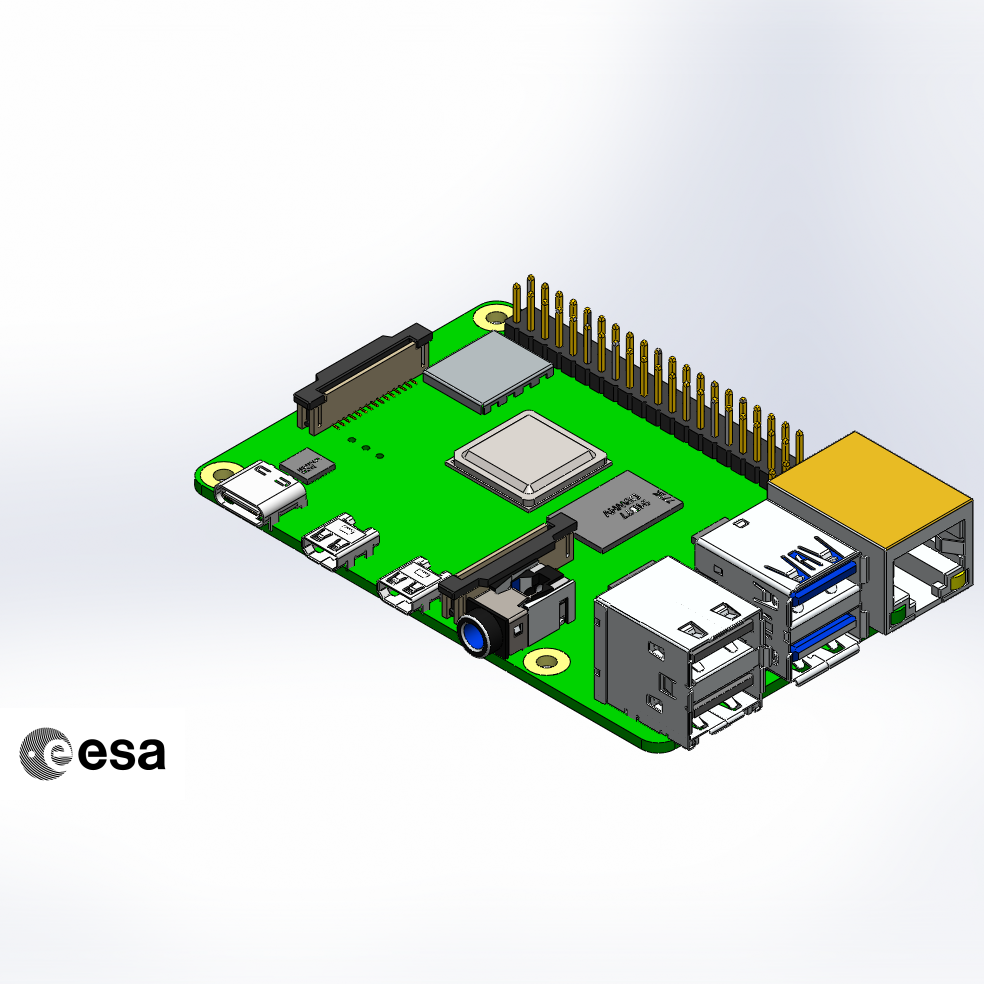
Original_ExoMy Release v1.0.2/Parts/PNG/Raspberry Pi 4 Model B_Default.png
