rbakx/MyExoMy/Original_ExoMy Release v1.0.2/Parts/PNG/Raspberry Pi Camera V2_Default.png

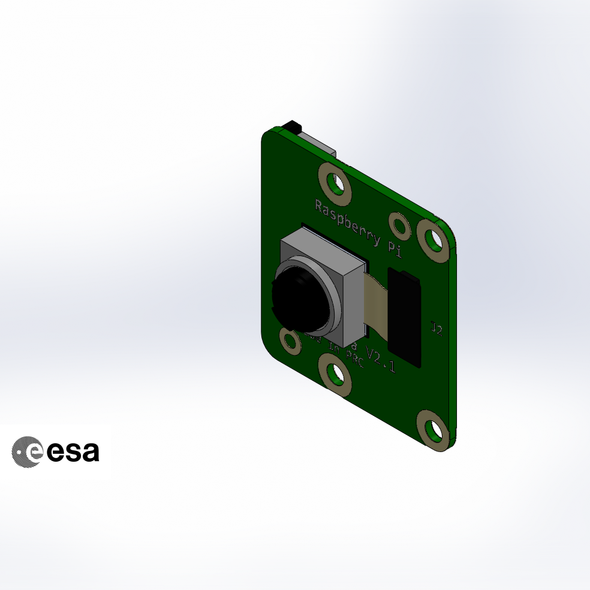
Original_ExoMy Release v1.0.2/Parts/PNG/Raspberry Pi Camera V2_Default.png
