rbakx/MyExoMy/Original_ExoMy Release v1.0.2/Parts/PNG/Servo Extension Cable_Right.png

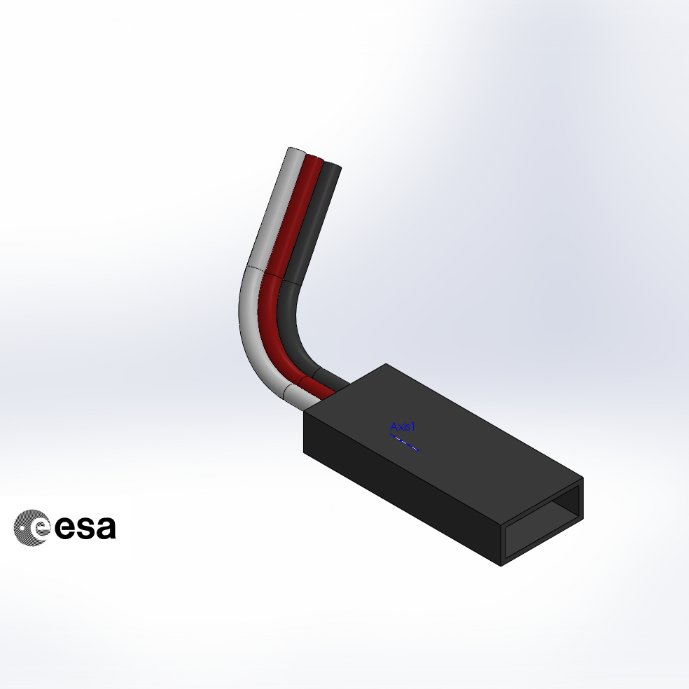
Original_ExoMy Release v1.0.2/Parts/PNG/Servo Extension Cable_Right.png
