rbakx/MyExoMy/Original_ExoMy Release v1.0.2/Parts/PNG/SFB3_6_Countersink Head M3x6.png

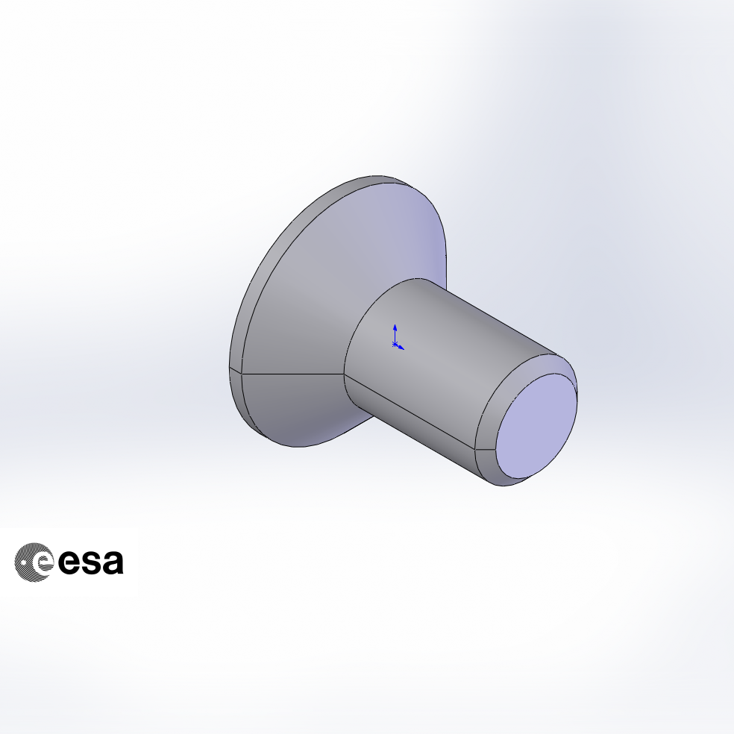
Original_ExoMy Release v1.0.2/Parts/PNG/SFB3_6_Countersink Head M3x6.png
