rbakx/MyExoMy/Original_ExoMy Release v1.0.2/Parts/PNG/Shrink_Tube_Default.png

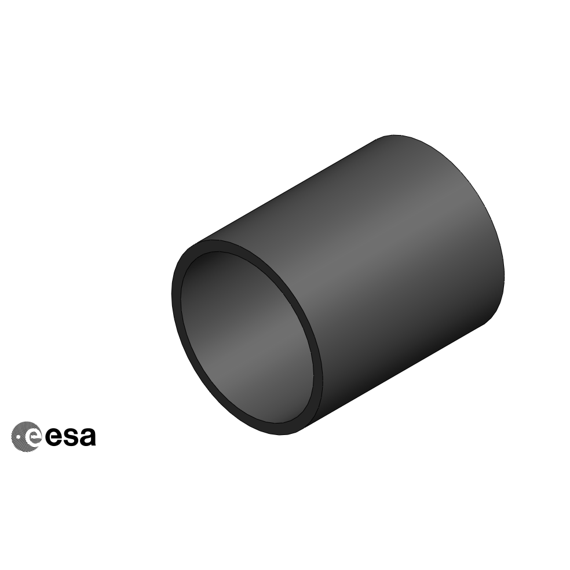
Original_ExoMy Release v1.0.2/Parts/PNG/Shrink_Tube_Default.png
