rbakx/MyExoMy/Original_ExoMy Release v1.0.2/Parts/PNG/USB-C Plug_Default.png

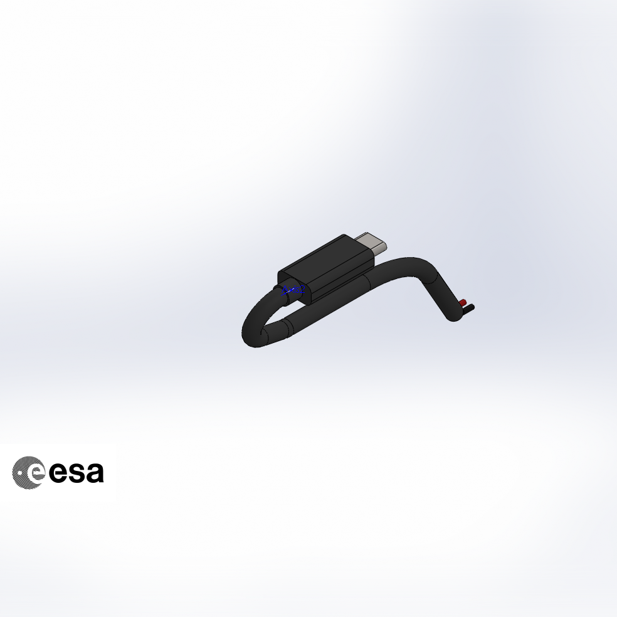
Original_ExoMy Release v1.0.2/Parts/PNG/USB-C Plug_Default.png
