rbakx/MyExoMy/Original_ExoMy Release v1.0.2/Parts/PNG/XT-60_Macho Male Pins_Default.png

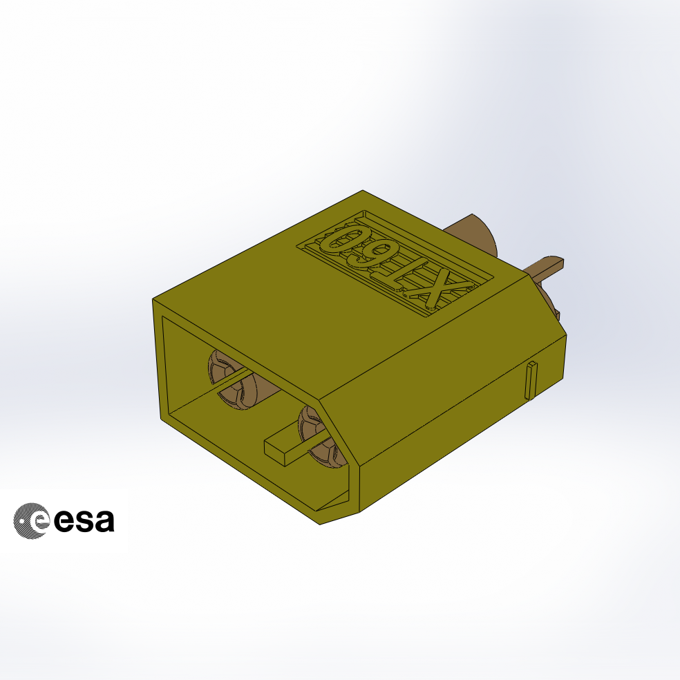
Original_ExoMy Release v1.0.2/Parts/PNG/XT-60_Macho Male Pins_Default.png
