rbakx/MyExoMy/Original_ExoMy Release v1.0.2/Parts/PNG/Zip_Tie_Bogie.png

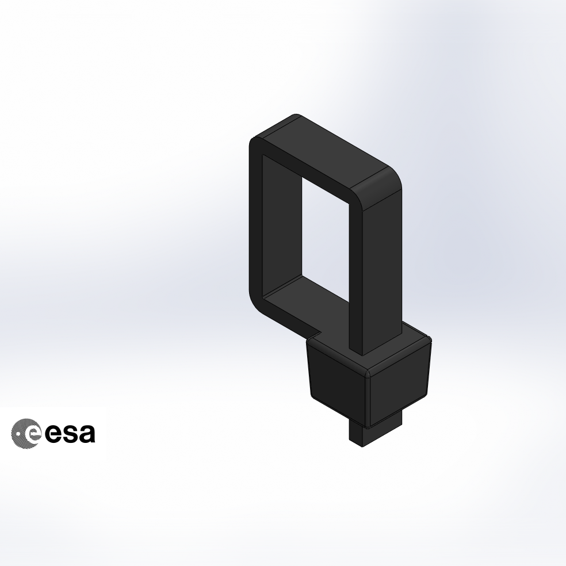
Original_ExoMy Release v1.0.2/Parts/PNG/Zip_Tie_Bogie.png
