rbakx/MyExoMy/Original_ExoMy Release v1.0.2/Technical_Drawings/JPEG/MI_Printed_Parts_BoM.jpg

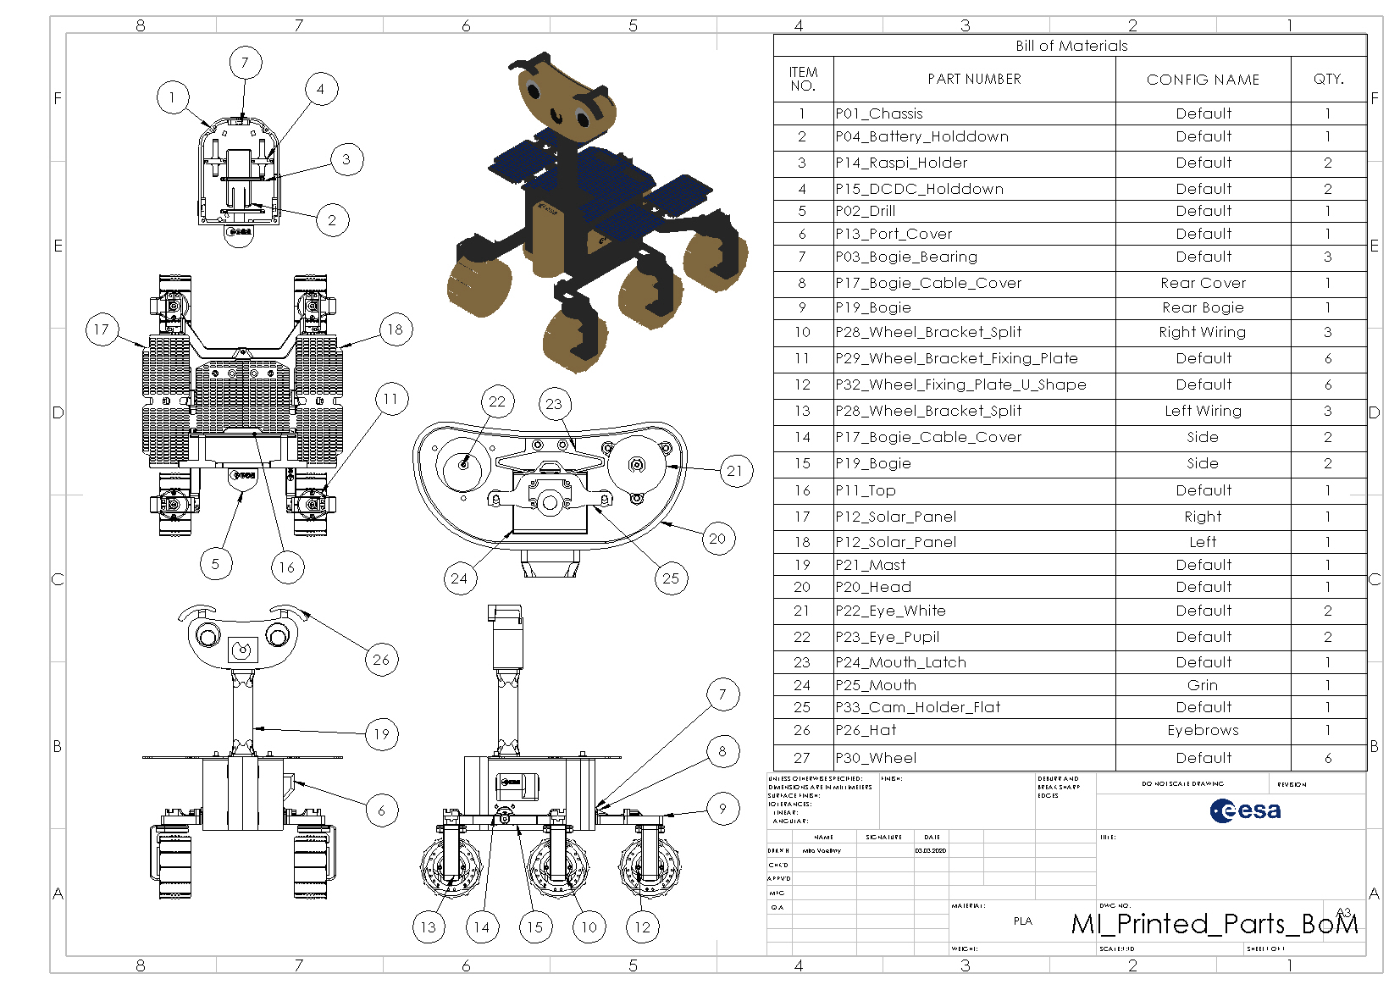
Original_ExoMy Release v1.0.2/Technical_Drawings/JPEG/MI_Printed_Parts_BoM.jpg
