rbakx/MyExoMy/Original_ExoMy Release v1.0.2/Optional_Parts/STEP/P37_Wheel_Sleeve_Full Sleeve Right.STEP

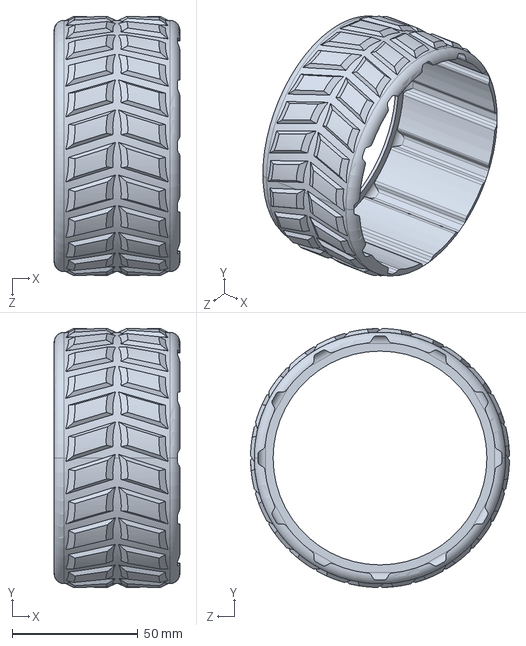
[picture p103: CAD file, 2021-07-20]
Original_ExoMy Release v1.0.2/Optional_Parts/STEP/P37_Wheel_Sleeve_Full Sleeve Right.STEP
50.0 x 103.0 x 103.0 mm
