rbakx/MyExoMy/Exomy_3D/FreeCAD/P37_Wheel_Sleeve_Full Sleeve Left.FCStd

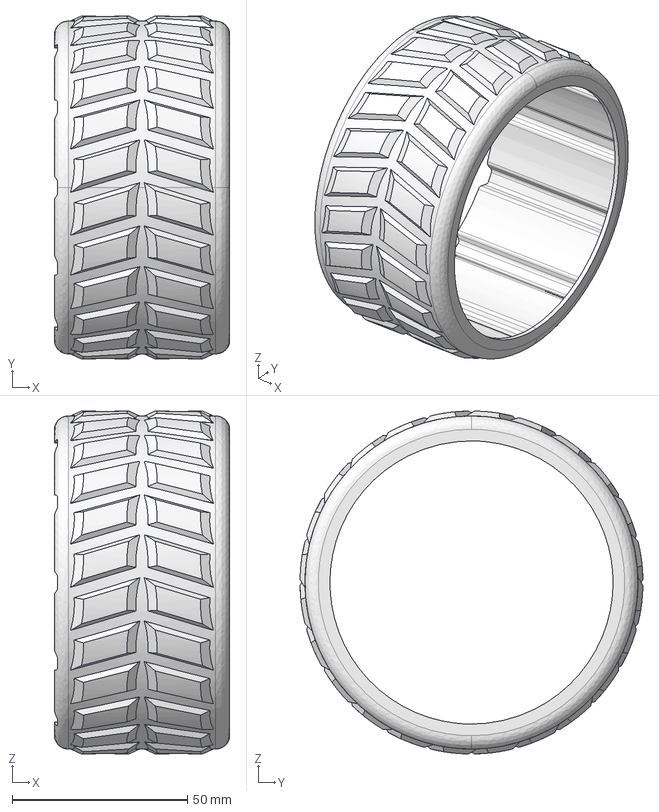
[picture p104: CAD file, 2021-07-20]
Exomy_3D/FreeCAD/P37_Wheel_Sleeve_Full Sleeve Left.FCStd
50.0 x 97.8 x 97.8 mm
