rbakx/MyExoMy/Exomy_3D/FreeCAD/Wakeup_Transmitter_Lid.FCStd

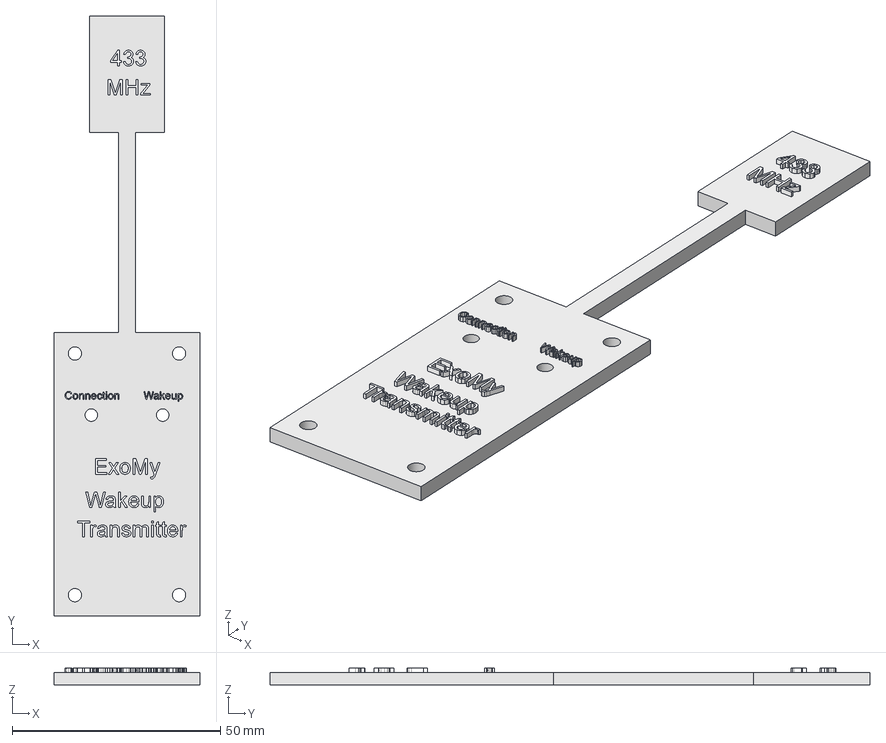
[picture p105: CAD file, 2021-10-10]
Exomy_3D/FreeCAD/Wakeup_Transmitter_Lid.FCStd
35.0 x 144.0 x 4.00 mm
