rbakx/MyExoMy/FreeCAD/P01_Chassis_ReneB.FCStd

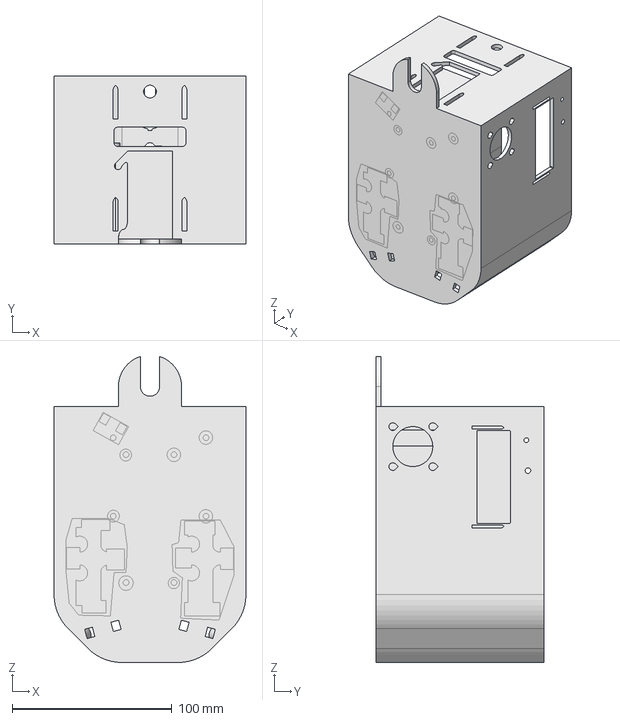
[picture p106: CAD file, 2021-04-25]
FreeCAD/P01_Chassis_ReneB.FCStd
120.0 x 105.0 x 191.3 mm
