rbakx/MyExoMy/Original_ExoMy Release v1.0.2/Optional_Parts/STEP/P35_Neck_Clip_Default.STEP

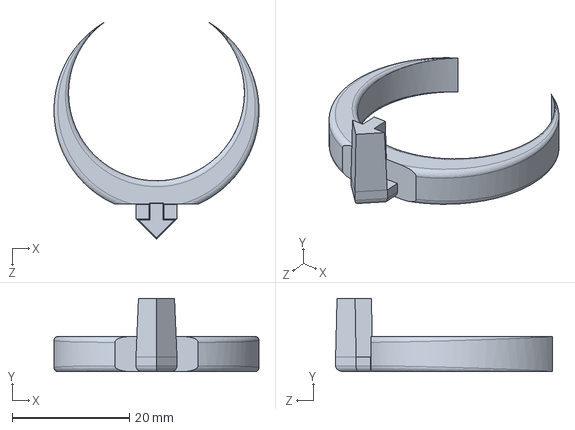
[picture p107: CAD file, 2021-07-20]
Original_ExoMy Release v1.0.2/Optional_Parts/STEP/P35_Neck_Clip_Default.STEP
35.0 x 12.5 x 37.0 mm
