rbakx/MyExoMy/Original_ExoMy Release v1.0.2/Optional_Parts/STL/P36_Bow_Tie_Default_1.STL

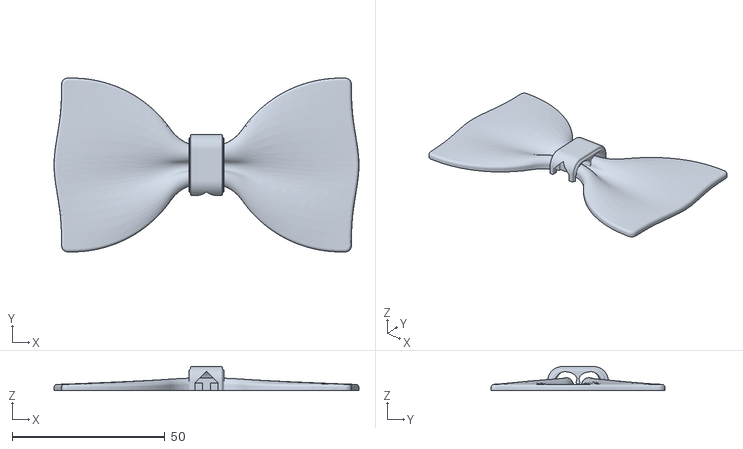
[picture p108: CAD file, 2021-07-20]
Original_ExoMy Release v1.0.2/Optional_Parts/STL/P36_Bow_Tie_Default_1.STL
100.0 x 57.0 x 7.87
