rbakx/MyExoMy/Original_ExoMy Release v1.0.2/Parts/STEP/P04_Battery_Holddown_Default.step

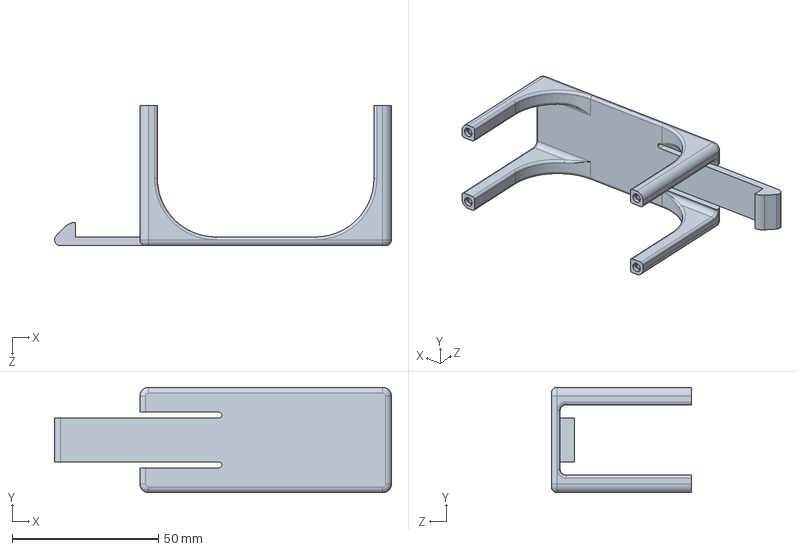
[picture p109: CAD file, 2021-07-20]
Original_ExoMy Release v1.0.2/Parts/STEP/P04_Battery_Holddown_Default.step
115.2 x 36.0 x 48.0 mm
