rbakx/MyExoMy/Original_ExoMy Release v1.0.2/Parts/STL/P12_Solar_Panel_Left_1.STL

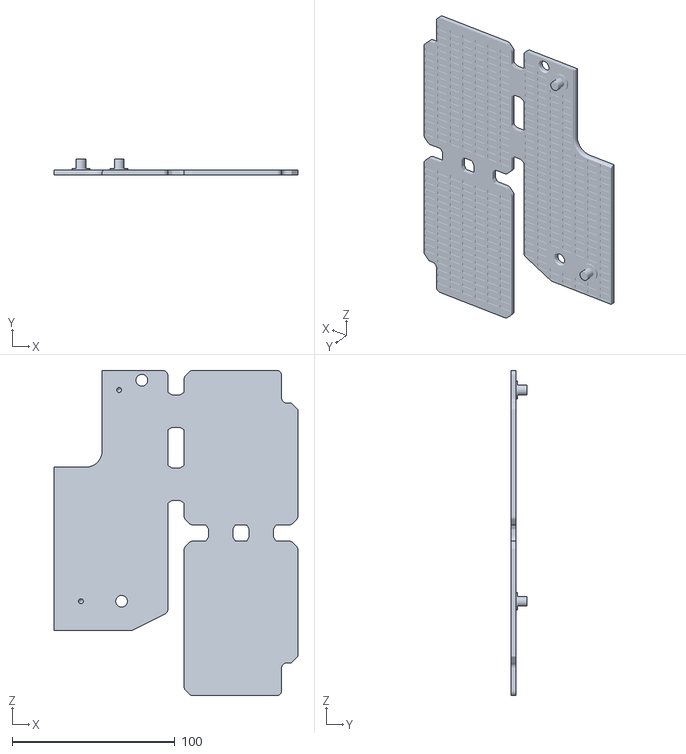
[picture p110: CAD file, 2021-07-20]
Original_ExoMy Release v1.0.2/Parts/STL/P12_Solar_Panel_Left_1.STL
150.0 x 10.0 x 200.0
