rbakx/MyExoMy/Exomy_3D/FreeCAD/Wakeup_Transmitter_Box.FCStd

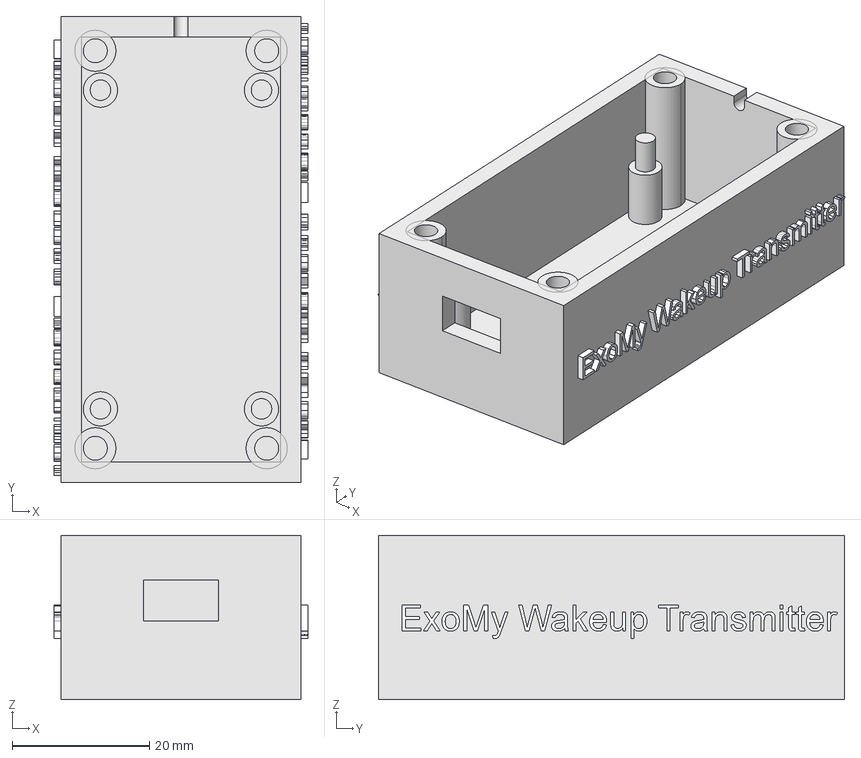
[picture p111: CAD file, 2021-10-05]
Exomy_3D/FreeCAD/Wakeup_Transmitter_Box.FCStd
37.0 x 68.0 x 24.0 mm
