rbakx/MyExoMy/Original_ExoMy Release v1.0.2/Optional_Parts/STL/P36_Bow_Tie_Default_2.STL

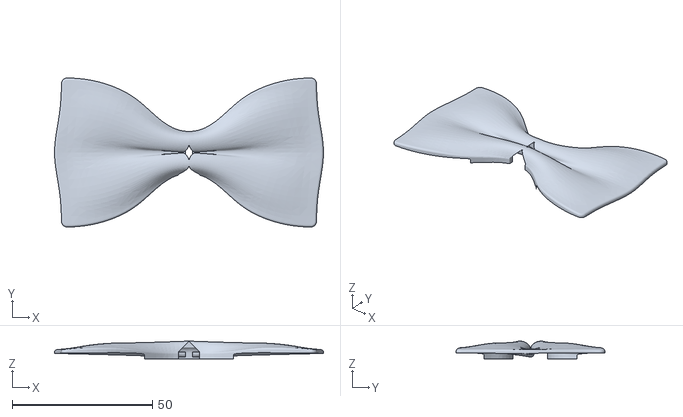
[picture p112: CAD file, 2021-07-20]
Original_ExoMy Release v1.0.2/Optional_Parts/STL/P36_Bow_Tie_Default_2.STL
96.0 x 53.1 x 6.37
