rbakx/MyExoMy/Original_ExoMy Release v1.0.2/Parts/STL/P12_Solar_Panel_Left_2.STL

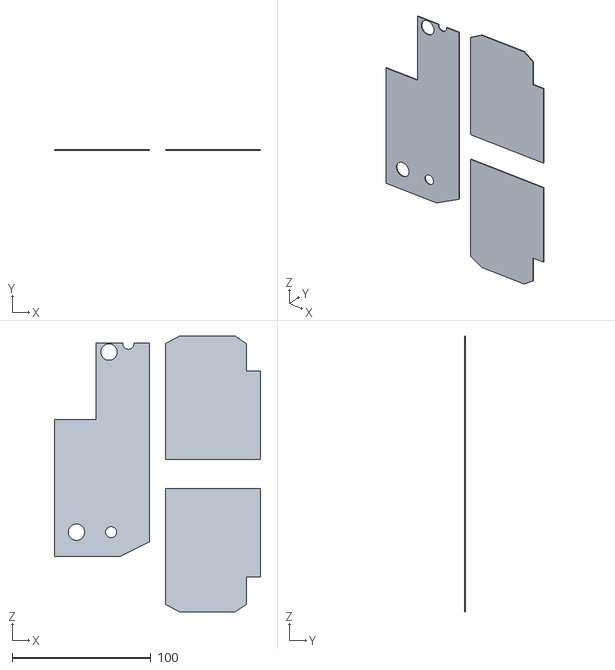
[picture p114: CAD file, 2021-07-20]
Original_ExoMy Release v1.0.2/Parts/STL/P12_Solar_Panel_Left_2.STL
148.8 x 0.6 x 199.2
