rbakx/MyExoMy/Exomy_3D/FreeCAD/LCD_Display_Support_ReneB.FCStd

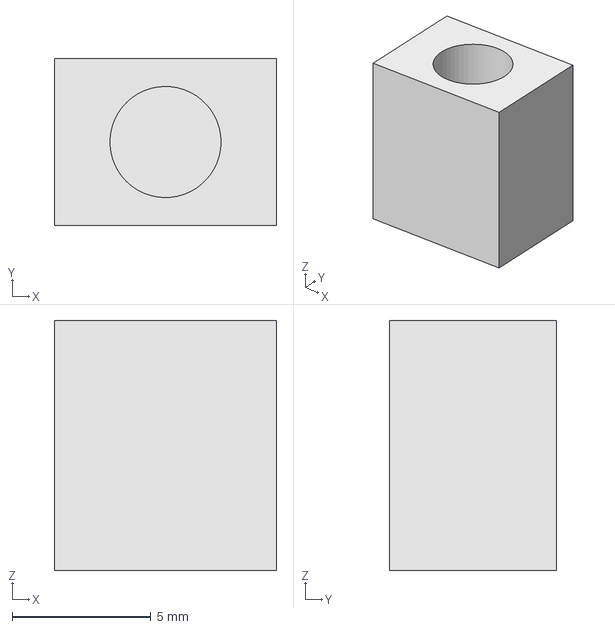
[picture p115: CAD file, 2021-07-20]
Exomy_3D/FreeCAD/LCD_Display_Support_ReneB.FCStd
8.00 x 6.00 x 9.00 mm
