rbakx/MyExoMy/Original_ExoMy Release v1.0.2/Parts/STEP/P15_DCDC_Holddown_Default.step

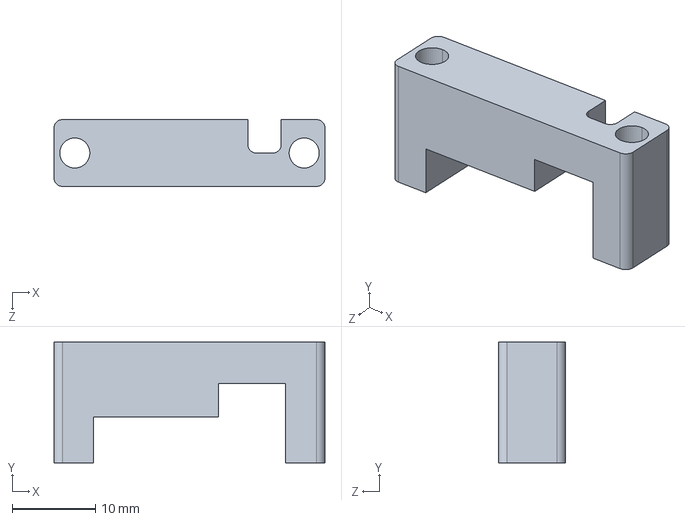
[picture p116: CAD file, 2021-07-20]
Original_ExoMy Release v1.0.2/Parts/STEP/P15_DCDC_Holddown_Default.step
32.5 x 14.5 x 8.00 mm
