rbakx/MyExoMy/Original_ExoMy Release v1.0.2/Parts/STL/P26_Hat_3D-Paxi_1.STL

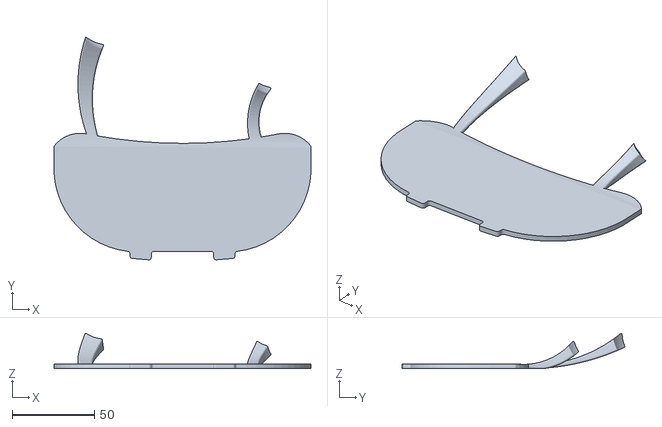
[picture p117: CAD file, 2021-07-20]
Original_ExoMy Release v1.0.2/Parts/STL/P26_Hat_3D-Paxi_1.STL
156.4 x 135.5 x 21.6
