rbakx/MyExoMy/Exomy_3D/FreeCAD/Wifi_Holder_SMA.FCStd

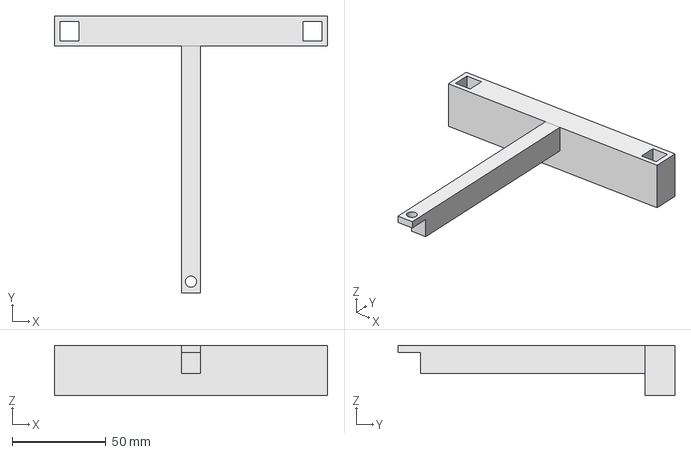
[picture p118: CAD file, 2021-07-20]
Exomy_3D/FreeCAD/Wifi_Holder_SMA.FCStd
146.0 x 148.0 x 27.0 mm
