rbakx/MyExoMy/Original_ExoMy Release v1.0.2/Optional_Parts/STEP/P36_Bow_Tie_Default.STEP

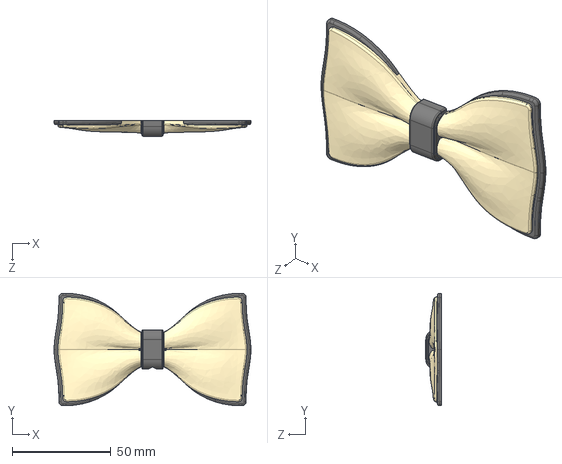
[picture p119: CAD file, 2021-07-20]
Original_ExoMy Release v1.0.2/Optional_Parts/STEP/P36_Bow_Tie_Default.STEP
100.0 x 57.0 x 7.87 mm
