rbakx/MyExoMy/Original_ExoMy Release v1.0.2/Parts/STL/P19_Bogie_Two Color Print_2.STL

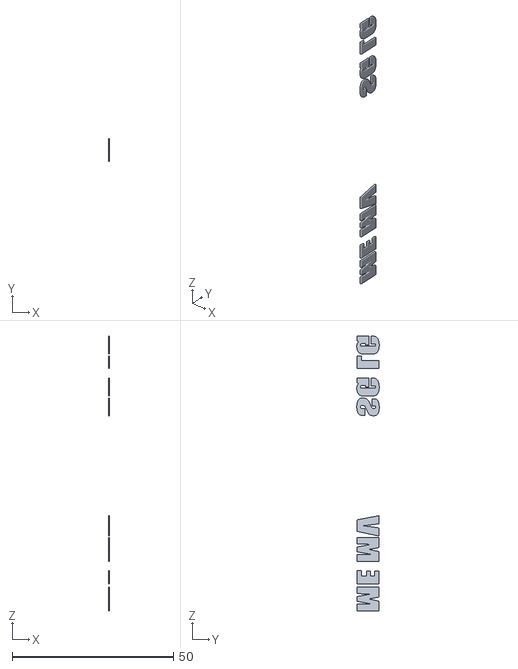
[picture p120: CAD file, 2021-07-20]
Original_ExoMy Release v1.0.2/Parts/STL/P19_Bogie_Two Color Print_2.STL
0.4 x 7.01 x 85.2
