rbakx/MyExoMy/Exomy_3D/FreeCAD/LCD_Display_Mount_ReneB.FCStd

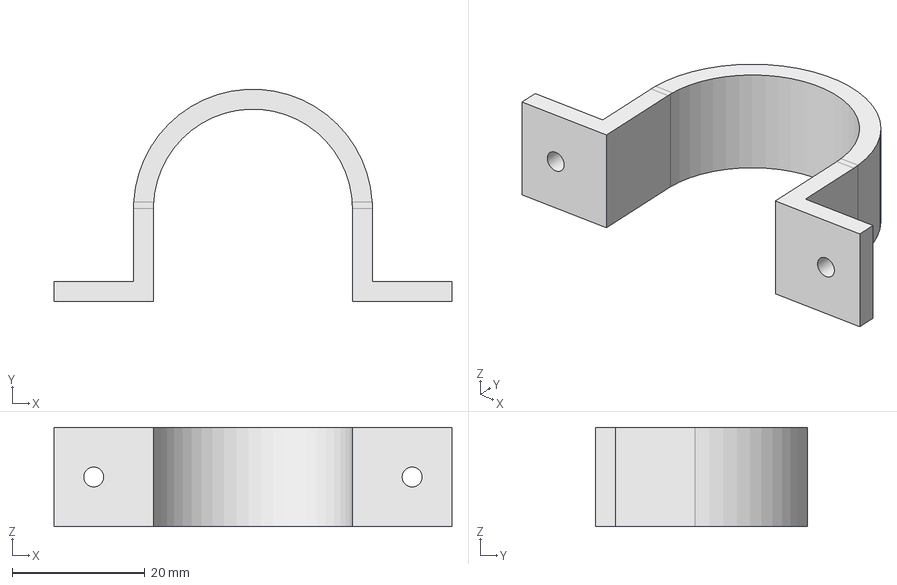
[picture p121: CAD file, 2021-07-20]
Exomy_3D/FreeCAD/LCD_Display_Mount_ReneB.FCStd
60.0 x 32.0 x 15.0 mm
