rbakx/MyExoMy/Original_ExoMy Release v1.0.2/Optional_Parts/STEP/P34_Hat_Rack_Default.step

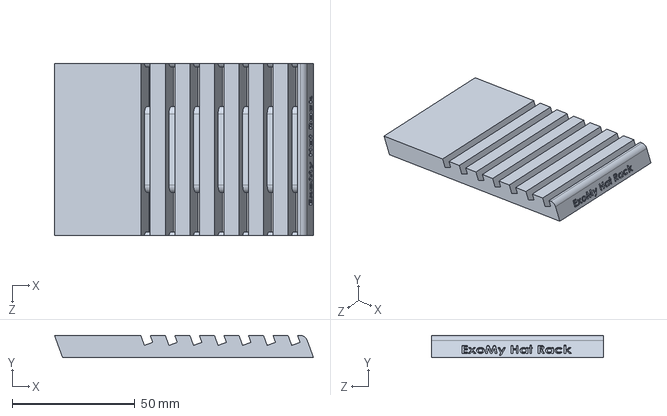
[picture p122: CAD file, 2021-07-20]
Original_ExoMy Release v1.0.2/Optional_Parts/STEP/P34_Hat_Rack_Default.step
105.5 x 9.00 x 70.0 mm
