rbakx/MyExoMy/Original_ExoMy Release v1.0.2/Parts/STEP/P11_Top_Default.step

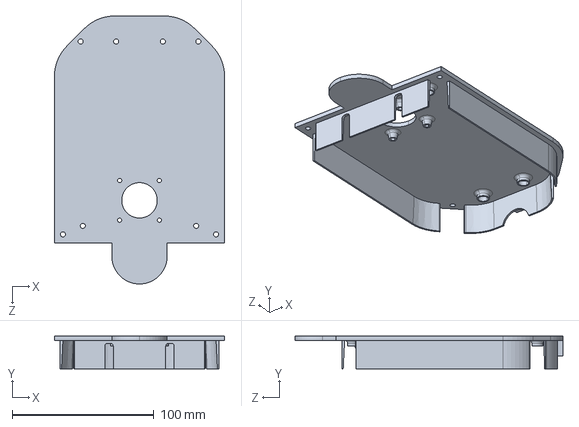
[picture p123: CAD file, 2021-07-20]
Original_ExoMy Release v1.0.2/Parts/STEP/P11_Top_Default.step
120.0 x 23.0 x 189.0 mm
