rbakx/MyExoMy/Original_ExoMy Release v1.0.2/Parts/STL/P01_Chassis_Two Color Print_1.STL

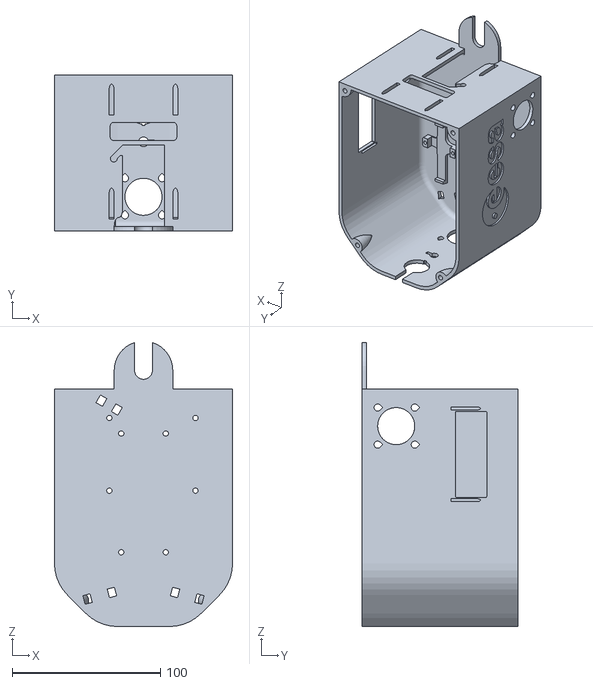
[picture p124: CAD file, 2021-07-20]
Original_ExoMy Release v1.0.2/Parts/STL/P01_Chassis_Two Color Print_1.STL
120.0 x 105.0 x 191.3
