rbakx/MyExoMy/Original_ExoMy Release v1.0.2/Optional_Parts/STEP/A07_Neck_Decoration_Default.STEP

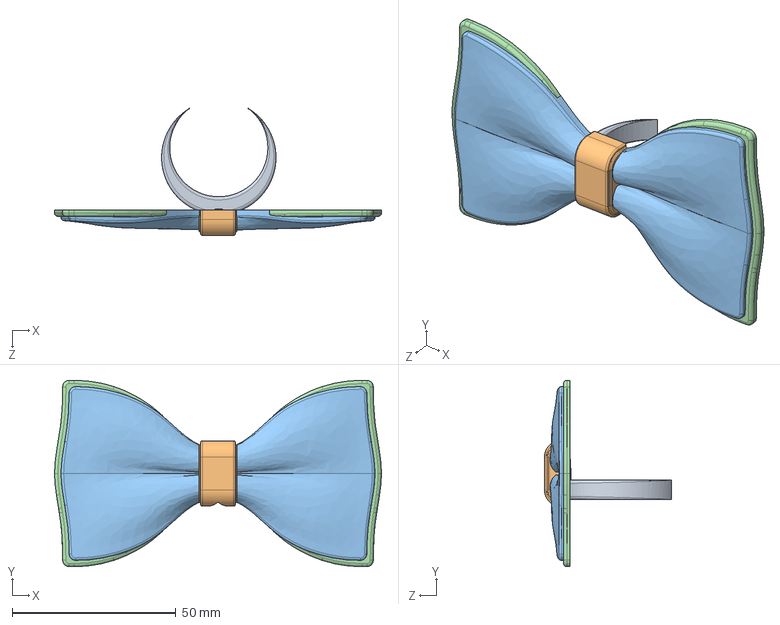
[picture p125: CAD file, 2021-07-20]
Original_ExoMy Release v1.0.2/Optional_Parts/STEP/A07_Neck_Decoration_Default.STEP
100.0 x 57.0 x 38.9 mm
P35_Neck_Clip
P36_Bow_Tie
