rbakx/MyExoMy/Original_ExoMy Release v1.0.2/Parts/STEP/P26_Hat_Pumpkin.step

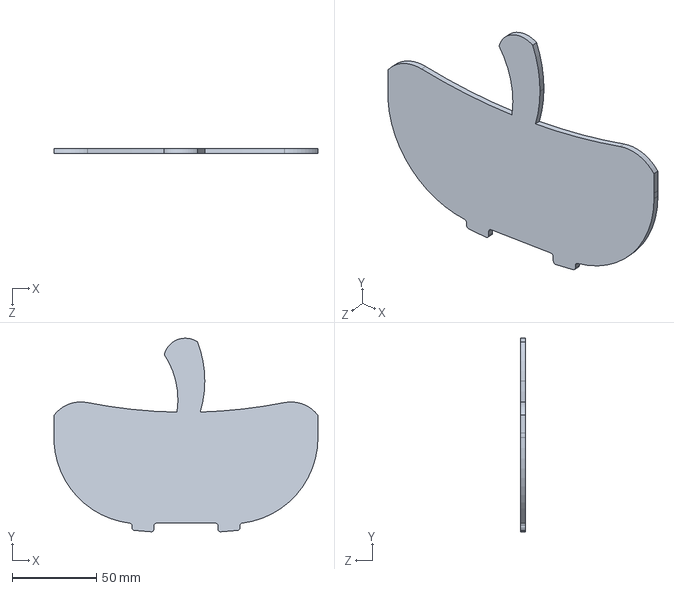
[picture p126: CAD file, 2021-07-20]
Original_ExoMy Release v1.0.2/Parts/STEP/P26_Hat_Pumpkin.step
156.5 x 114.8 x 3.00 mm
