rbakx/MyExoMy/Original_ExoMy Release v1.0.2/Parts/STEP/P19_Bogie_Two Color Print.step

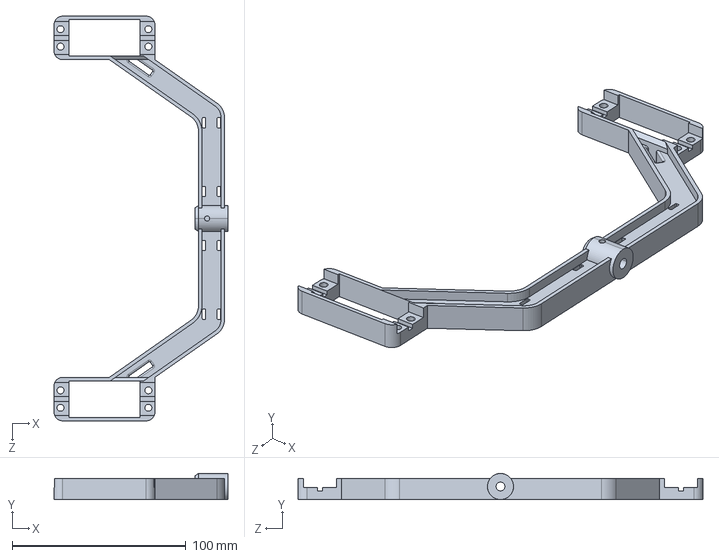
[picture p127: CAD file, 2021-07-20]
Original_ExoMy Release v1.0.2/Parts/STEP/P19_Bogie_Two Color Print.step
100.0 x 15.0 x 232.6 mm
