rbakx/MyExoMy/Original_ExoMy Release v1.0.2/Parts/STL/P17_Bogie_Cable_Cover_Two Color Print_1.STL

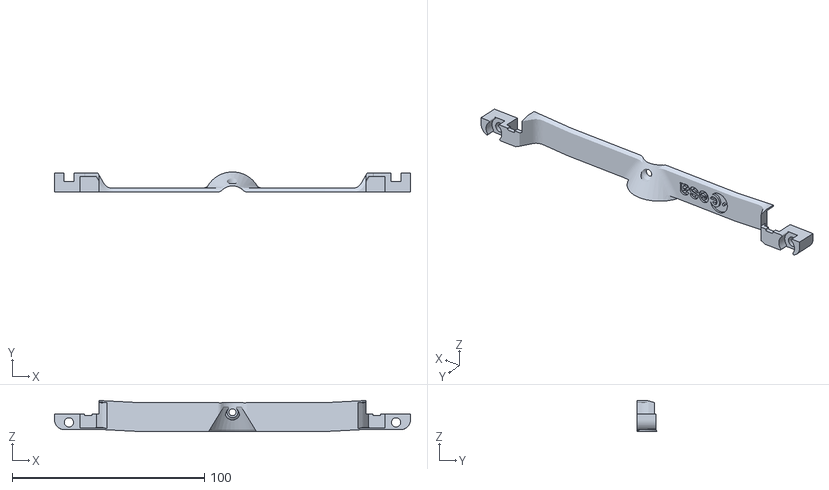
[picture p128: CAD file, 2021-07-20]
Original_ExoMy Release v1.0.2/Parts/STL/P17_Bogie_Cable_Cover_Two Color Print_1.STL
185.0 x 10.4 x 16.1
