rbakx/MyExoMy/Exomy_3D/FreeCAD/LCD_Display_Box_ReneB.FCStd

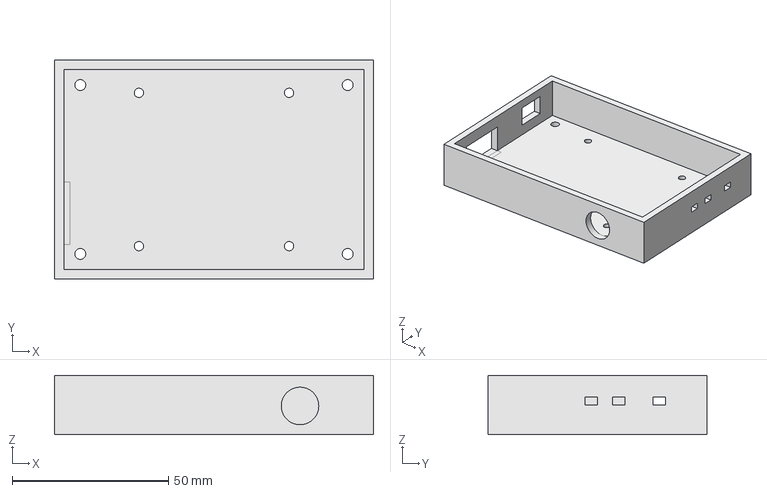
[picture p129: CAD file, 2021-07-20]
Exomy_3D/FreeCAD/LCD_Display_Box_ReneB.FCStd
102.0 x 70.0 x 19.0 mm
