rbakx/MyExoMy/Original_ExoMy Release v1.0.2/Parts/STEP/P25_Mouth_Monocle.step

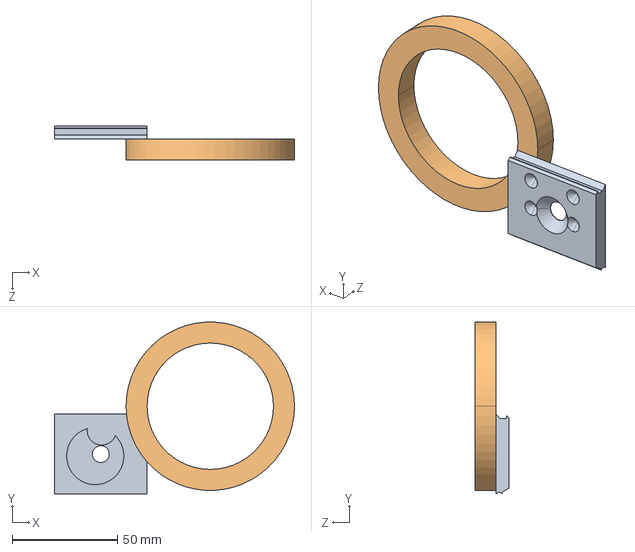
[picture p130: CAD file, 2021-07-20]
Original_ExoMy Release v1.0.2/Parts/STEP/P25_Mouth_Monocle.step
114.0 x 81.5 x 16.2 mm
