rbakx/MyExoMy/Original_ExoMy Release v1.0.2/Parts/STL/P26_Hat_3D-Paxi_2.STL

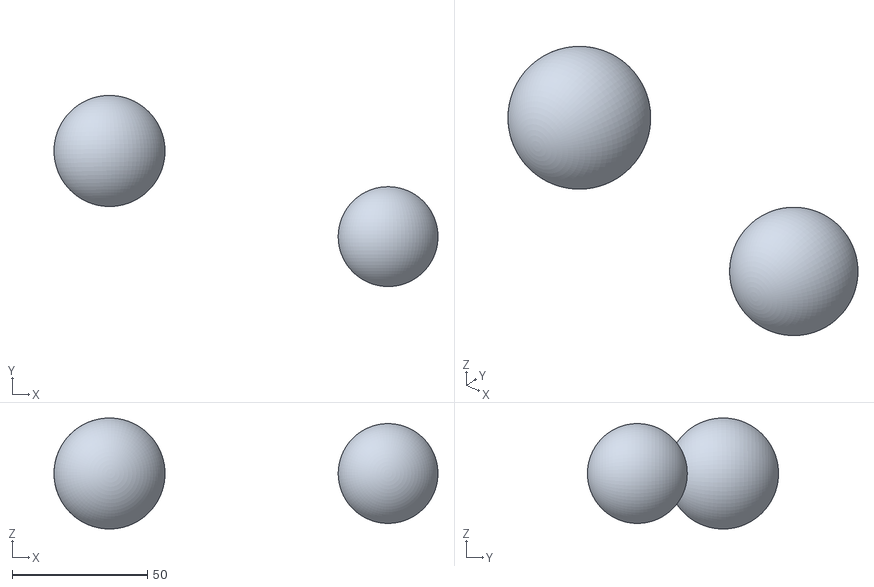
[picture p131: CAD file, 2021-07-20]
Original_ExoMy Release v1.0.2/Parts/STL/P26_Hat_3D-Paxi_2.STL
142.1 x 70.7 x 41.1
