rbakx/MyExoMy/Exomy_3D/FreeCAD/Drill_Short_ReneB.FCStd

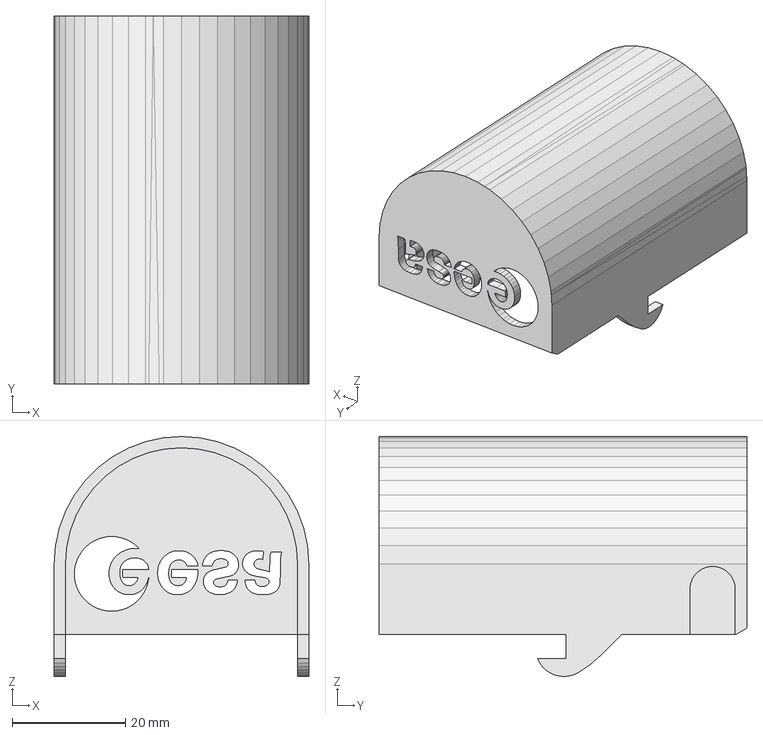
[picture p132: CAD file, 2021-07-20]
Exomy_3D/FreeCAD/Drill_Short_ReneB.FCStd
45.0 x 65.0 x 42.4 mm
