rbakx/MyExoMy/Original_ExoMy Release v1.0.2/Parts/STEP/P28_Wheel_Bracket_Split_Left Wiring.step

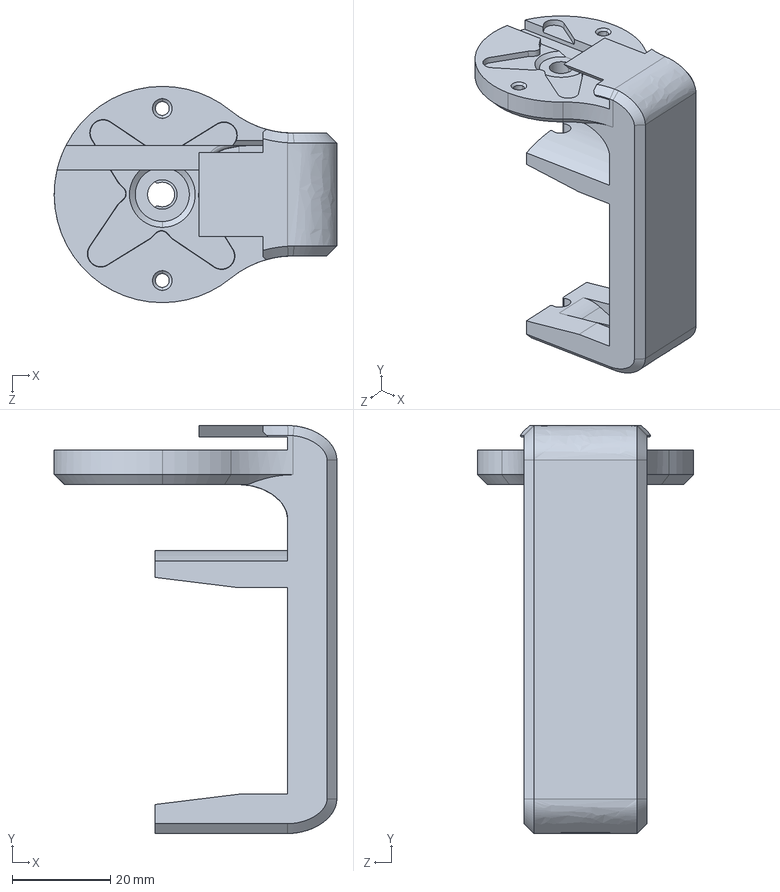
[picture p133: CAD file, 2021-07-20]
Original_ExoMy Release v1.0.2/Parts/STEP/P28_Wheel_Bracket_Split_Left Wiring.step
57.5 x 83.0 x 44.0 mm
