rbakx/MyExoMy/Original_ExoMy Release v1.0.2/Parts/STL/P17_Bogie_Cable_Cover_Two Color Print_2.STL

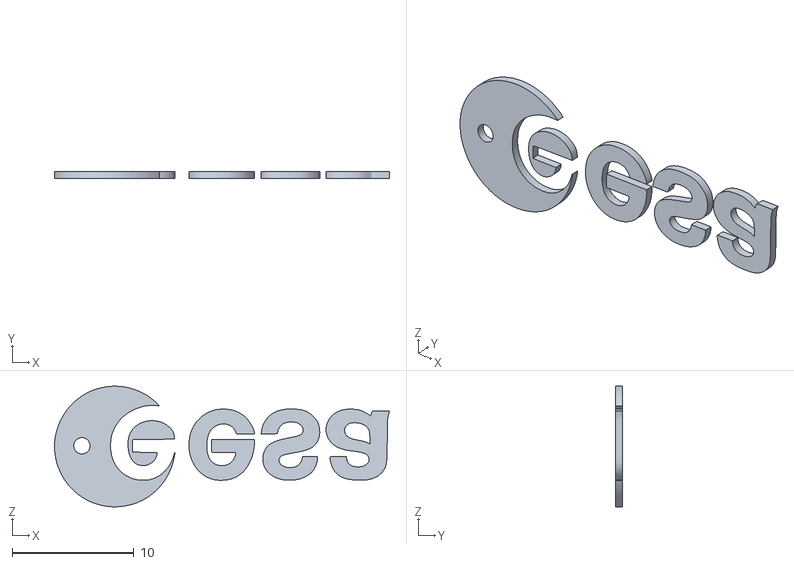
[picture p134: CAD file, 2021-07-20]
Original_ExoMy Release v1.0.2/Parts/STL/P17_Bogie_Cable_Cover_Two Color Print_2.STL
27.5 x 0.6 x 9.90
