rbakx/MyExoMy/Exomy_3D/FreeCAD/Wifi_Holder_USB.FCStd

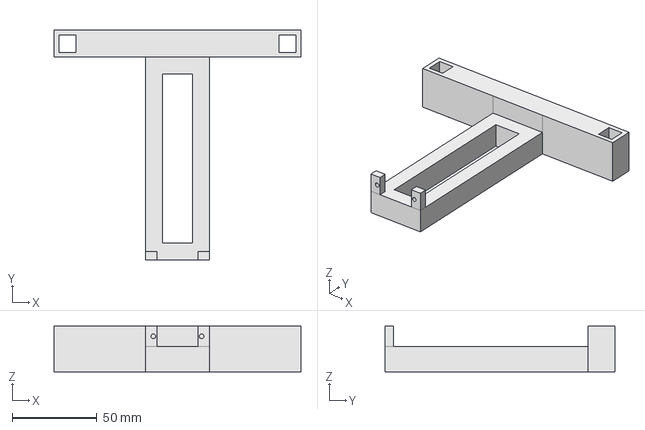
[picture p135: CAD file, 2021-05-16]
Exomy_3D/FreeCAD/Wifi_Holder_USB.FCStd
146.0 x 136.0 x 27.0 mm
