rbakx/MyExoMy/Original_ExoMy Release v1.0.2/Parts/STEP/P24_Mouth_Latch_Default.step

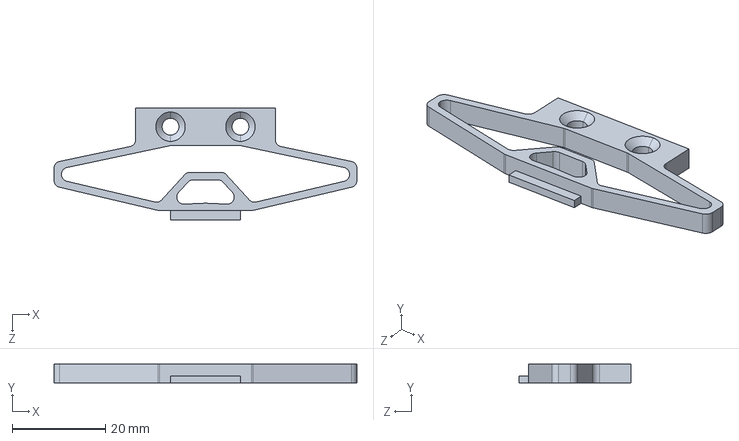
[picture p136: CAD file, 2021-07-20]
Original_ExoMy Release v1.0.2/Parts/STEP/P24_Mouth_Latch_Default.step
65.0 x 4.00 x 24.0 mm
