rbakx/MyExoMy/Original_ExoMy Release v1.0.2/Parts/STL/P01_Chassis_Two Color Print_2.STL

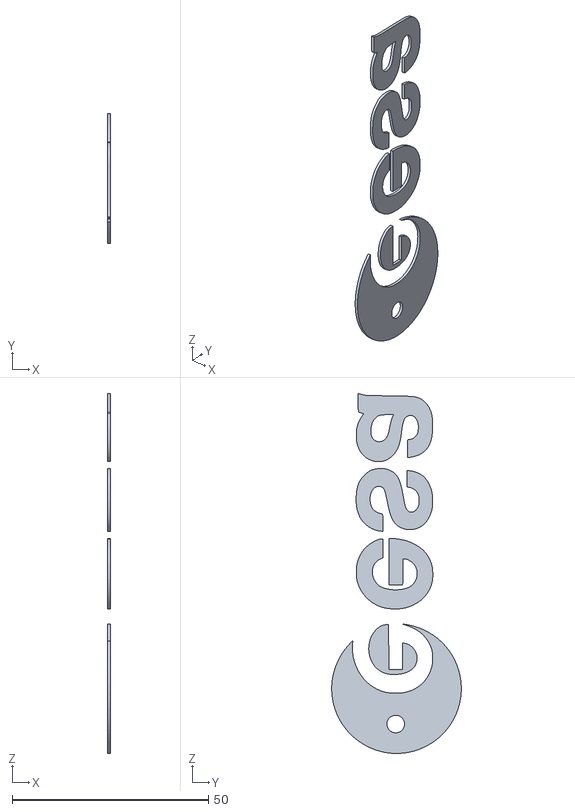
[picture p137: CAD file, 2021-07-20]
Original_ExoMy Release v1.0.2/Parts/STL/P01_Chassis_Two Color Print_2.STL
0.75 x 33.0 x 91.6
