rbakx/MyExoMy/Exomy_3D/FreeCAD/P21_Mast_Flat_ReneB.FCStd

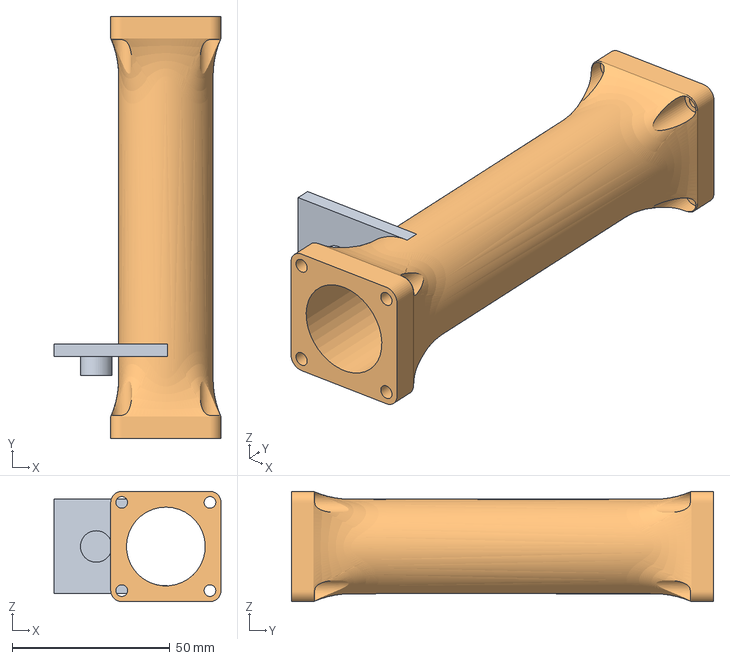
[picture p138: CAD file, 2021-05-05]
Exomy_3D/FreeCAD/P21_Mast_Flat_ReneB.FCStd
53.0 x 134.0 x 35.0 mm
P21_Mast_Default
