rbakx/MyExoMy/Original_ExoMy Release v1.0.2/Parts/STEP/P13_Port_Cover_Default.step

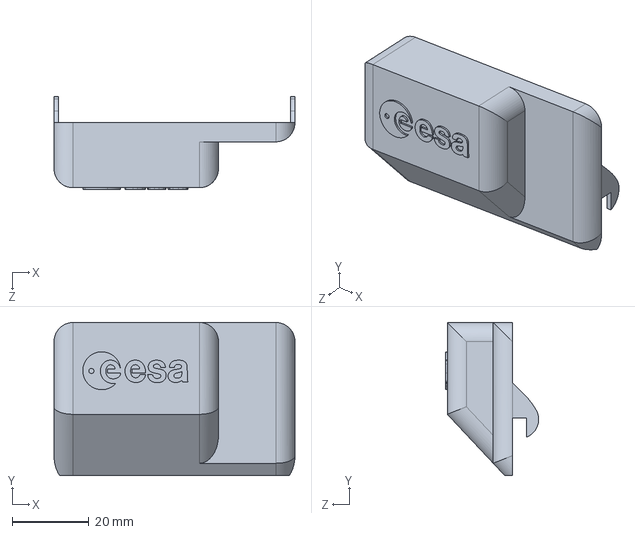
[picture p139: CAD file, 2021-07-20]
Original_ExoMy Release v1.0.2/Parts/STEP/P13_Port_Cover_Default.step
63.0 x 40.0 x 24.4 mm
