rbakx/MyExoMy/Exomy_3D/FreeCAD/P12_Solar_Panel_Right_Flat_ReneB.FCStd

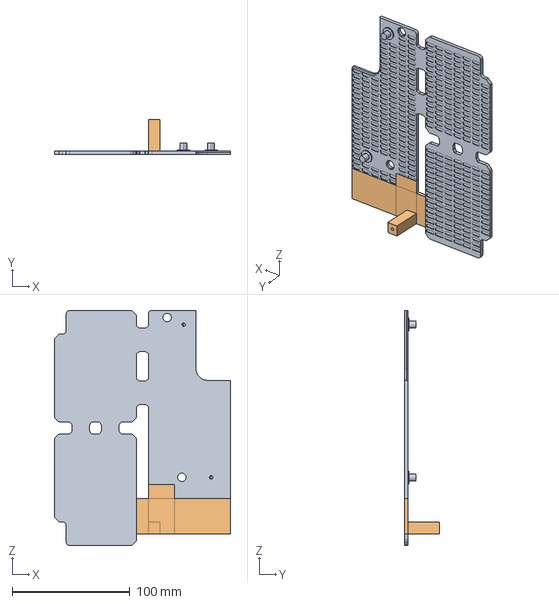
[picture p141: CAD file, 2021-05-05]
Exomy_3D/FreeCAD/P12_Solar_Panel_Right_Flat_ReneB.FCStd
150.0 x 30.0 x 200.0 mm
P12_Solar_Panel_Right
