rbakx/MyExoMy/Original_ExoMy Release v1.0.2/Parts/STEP/P25_Mouth_Default.step

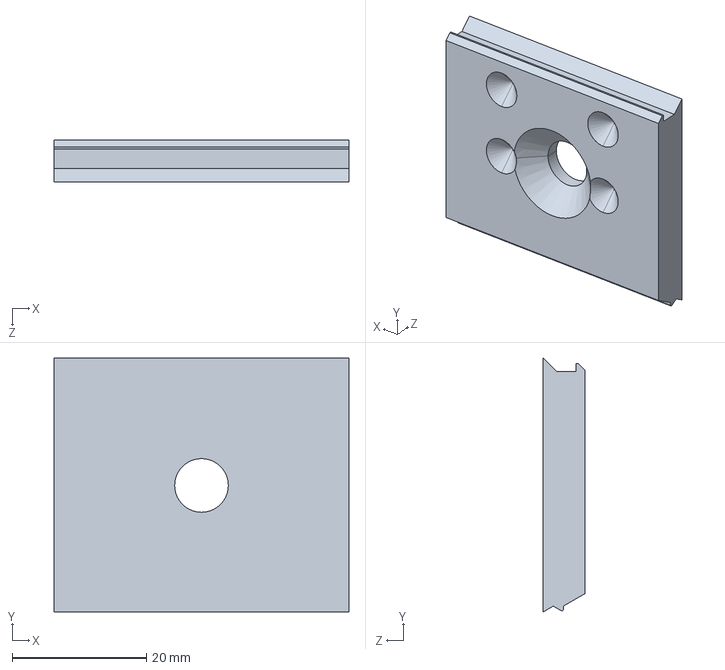
[picture p142: CAD file, 2021-07-20]
Original_ExoMy Release v1.0.2/Parts/STEP/P25_Mouth_Default.step
44.0 x 37.9 x 6.20 mm
