rbakx/MyExoMy/Original_ExoMy Release v1.0.2/Parts/STEP/P17_Bogie_Cable_Cover_Two Color Print.step

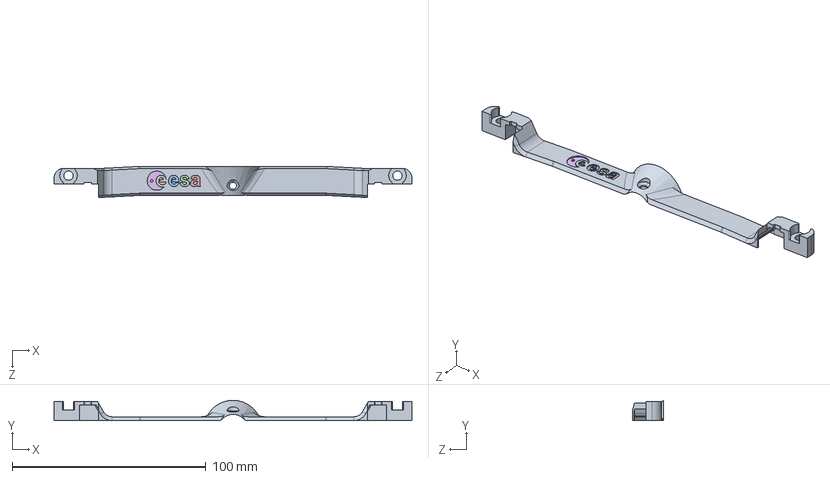
[picture p143: CAD file, 2021-07-20]
Original_ExoMy Release v1.0.2/Parts/STEP/P17_Bogie_Cable_Cover_Two Color Print.step
185.0 x 10.5 x 16.1 mm
