rbakx/MyExoMy/Original_ExoMy Release v1.0.2/Parts/STL/P19_Bogie_Two Color Print_1.STL

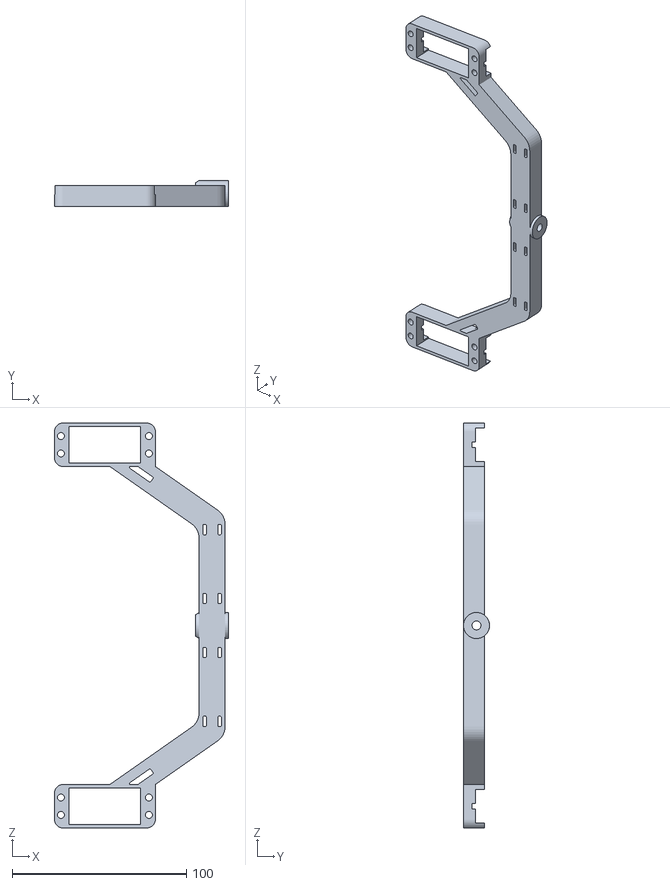
[picture p144: CAD file, 2021-07-20]
Original_ExoMy Release v1.0.2/Parts/STL/P19_Bogie_Two Color Print_1.STL
100.0 x 15.0 x 232.6
