rbakx/MyExoMy/Exomy_3D/FreeCAD/P30_Wheel_Right_Reneb.FCStd

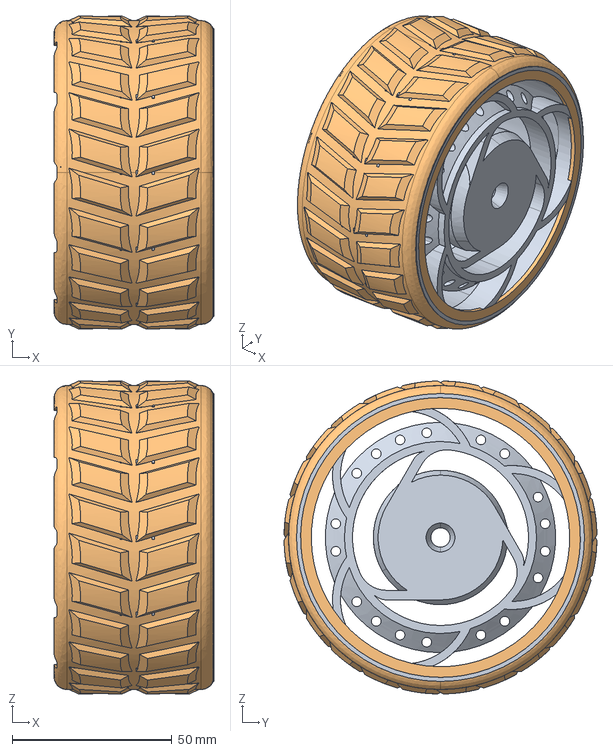
[picture p145: CAD file, 2021-05-04]
Exomy_3D/FreeCAD/P30_Wheel_Right_Reneb.FCStd
50.0 x 97.8 x 97.8 mm
P30_Wheel_Default
P37_Wheel_Sleeve_Full Sleeve Right001
