rbakx/MyExoMy/Original_ExoMy Release v1.0.2/Parts/STEP/P26_Hat_Alien.step

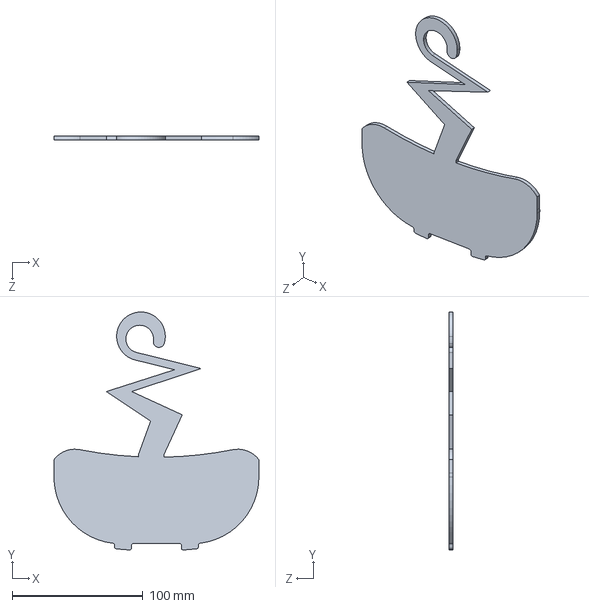
[picture p146: CAD file, 2021-07-20]
Original_ExoMy Release v1.0.2/Parts/STEP/P26_Hat_Alien.step
156.5 x 181.8 x 3.00 mm
