rbakx/MyExoMy/Exomy_3D/FreeCAD/P11_Top_ReneB.FCStd

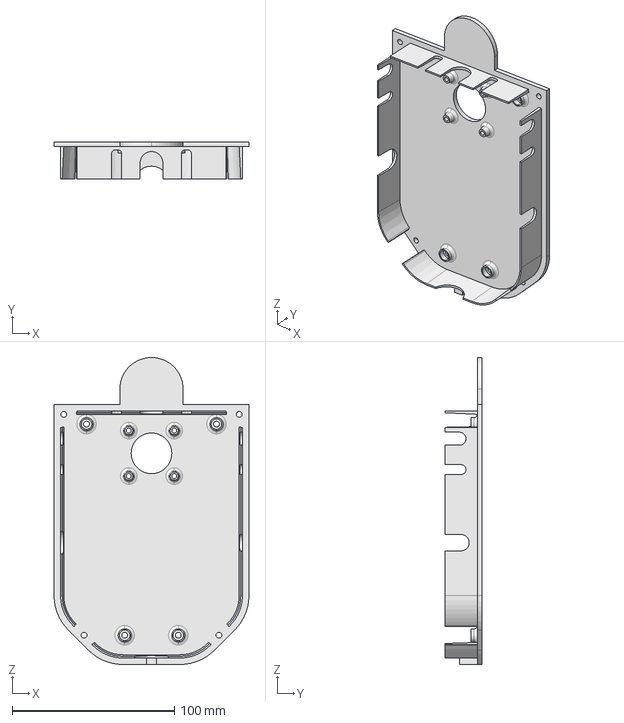
[picture p147: CAD file, 2021-05-04]
Exomy_3D/FreeCAD/P11_Top_ReneB.FCStd
120.0 x 23.0 x 189.0 mm
