rbakx/MyExoMy/Original_ExoMy Release v1.0.2/Parts/STEP/P19_Bogie_Side.step

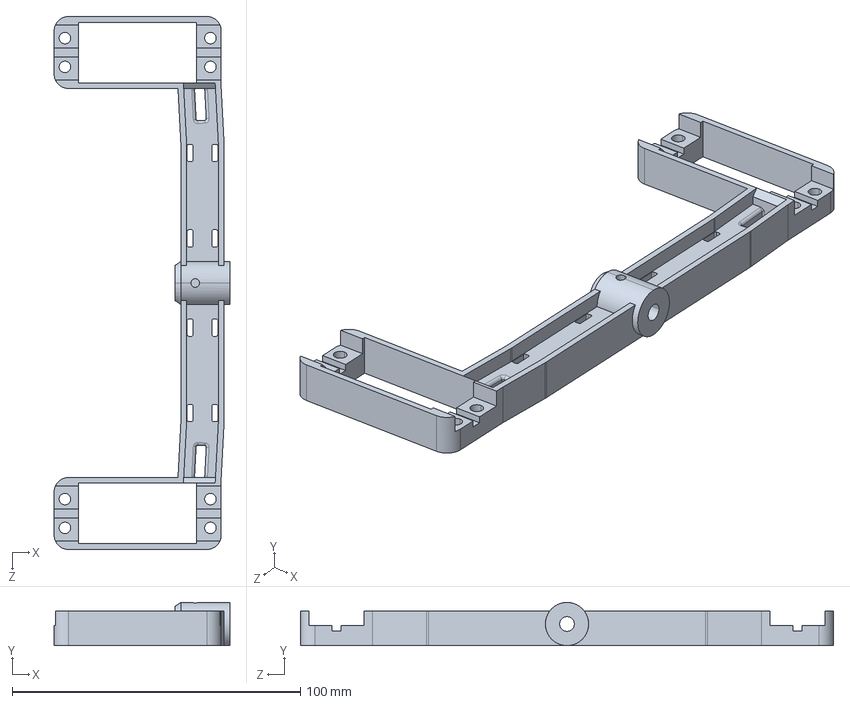
[picture p148: CAD file, 2021-07-20]
Original_ExoMy Release v1.0.2/Parts/STEP/P19_Bogie_Side.step
61.0 x 15.0 x 185.0 mm
