rbakx/MyExoMy/Exomy_3D/FreeCAD/RPI_Spacer.FCStd

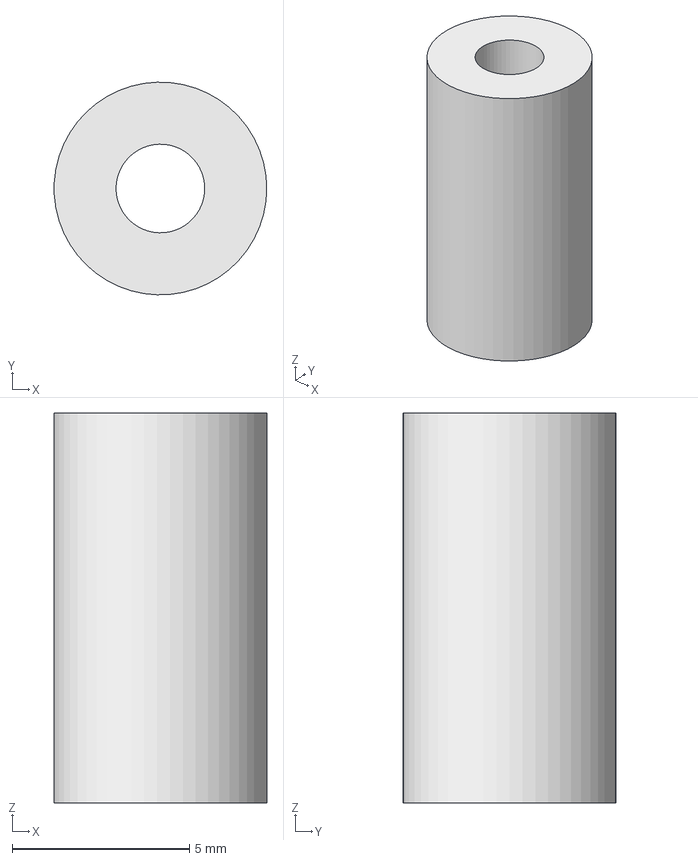
[picture p149: CAD file, 2021-05-04]
Exomy_3D/FreeCAD/RPI_Spacer.FCStd
5.99 x 6.00 x 11.0 mm
