rbakx/MyExoMy/Original_ExoMy Release v1.0.2/Parts/STEP/P26_Hat_Wizard.step

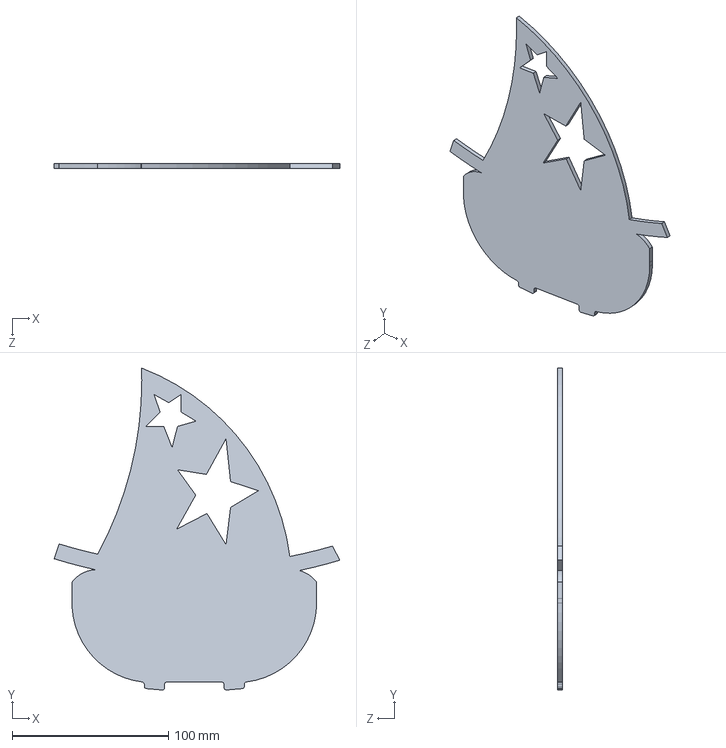
[picture p150: CAD file, 2021-07-20]
Original_ExoMy Release v1.0.2/Parts/STEP/P26_Hat_Wizard.step
182.8 x 206.0 x 3.00 mm
