rbakx/MyExoMy/Original_ExoMy Release v1.0.2/Parts/STL/P02_Drill_Default.STL

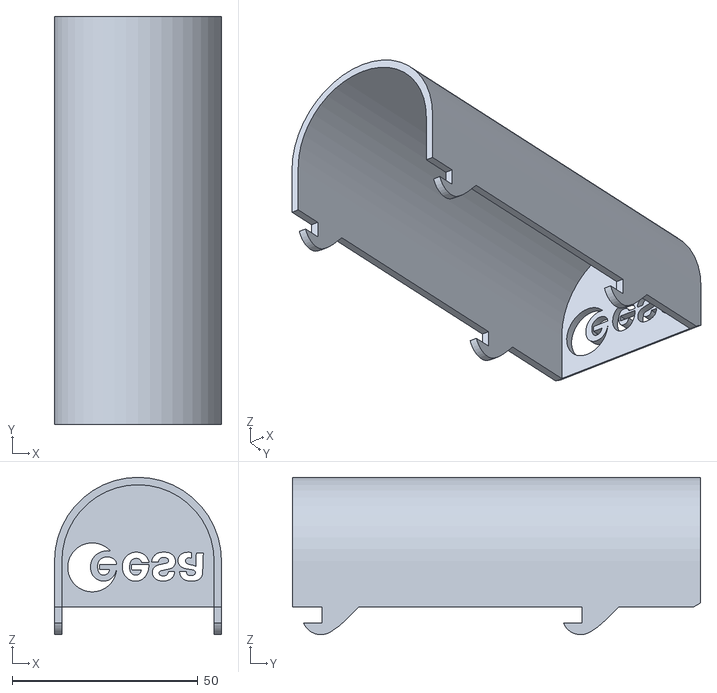
[picture p151: CAD file, 2021-07-20]
Original_ExoMy Release v1.0.2/Parts/STL/P02_Drill_Default.STL
45.0 x 110.0 x 42.4
