rbakx/MyExoMy/Original_ExoMy Release v1.0.2/Parts/STEP/P21_Mast_Default.step

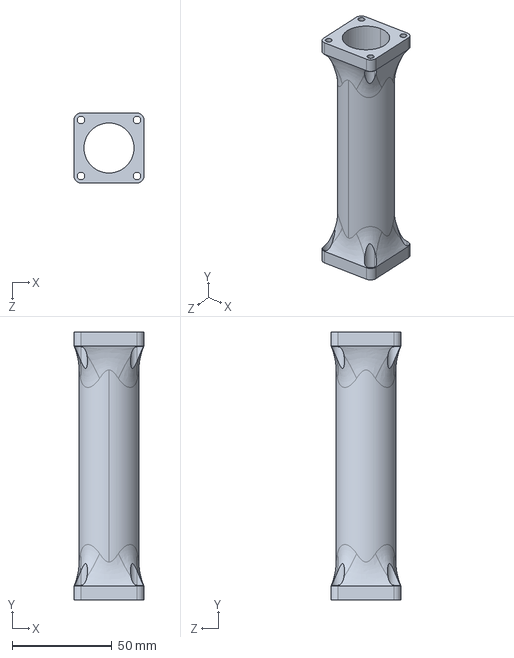
[picture p152: CAD file, 2021-07-20]
Original_ExoMy Release v1.0.2/Parts/STEP/P21_Mast_Default.step
35.0 x 134.0 x 35.0 mm
