rbakx/MyExoMy/Original_ExoMy Release v1.0.2/Parts/STL/P35_Neck_Clip_Default.STL

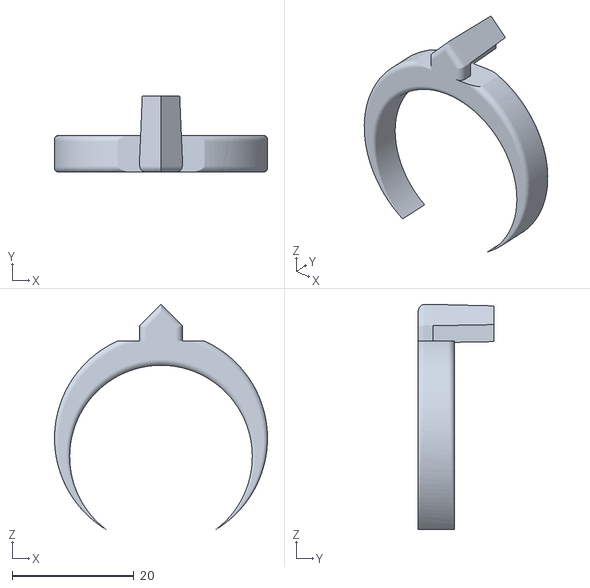
[picture p153: CAD file, 2021-07-20]
Original_ExoMy Release v1.0.2/Parts/STL/P35_Neck_Clip_Default.STL
35.0 x 12.5 x 37.0
