rbakx/MyExoMy/Exomy_3D/FreeCAD/Battery_Cover_ReneB.FCStd

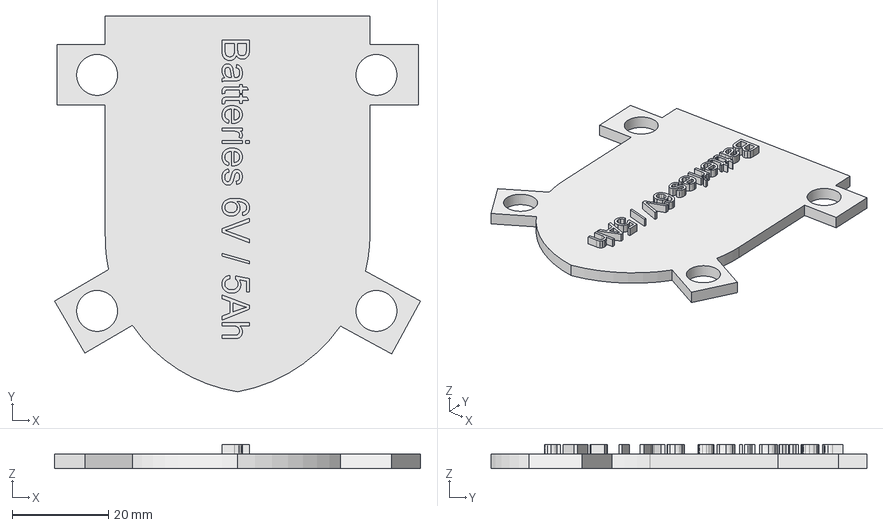
[picture p154: CAD file, 2021-04-27]
Exomy_3D/FreeCAD/Battery_Cover_ReneB.FCStd
76.0 x 78.0 x 5.00 mm
