rbakx/MyExoMy/Original_ExoMy Release v1.0.2/Parts/STEP/P26_Hat_Tophat.step

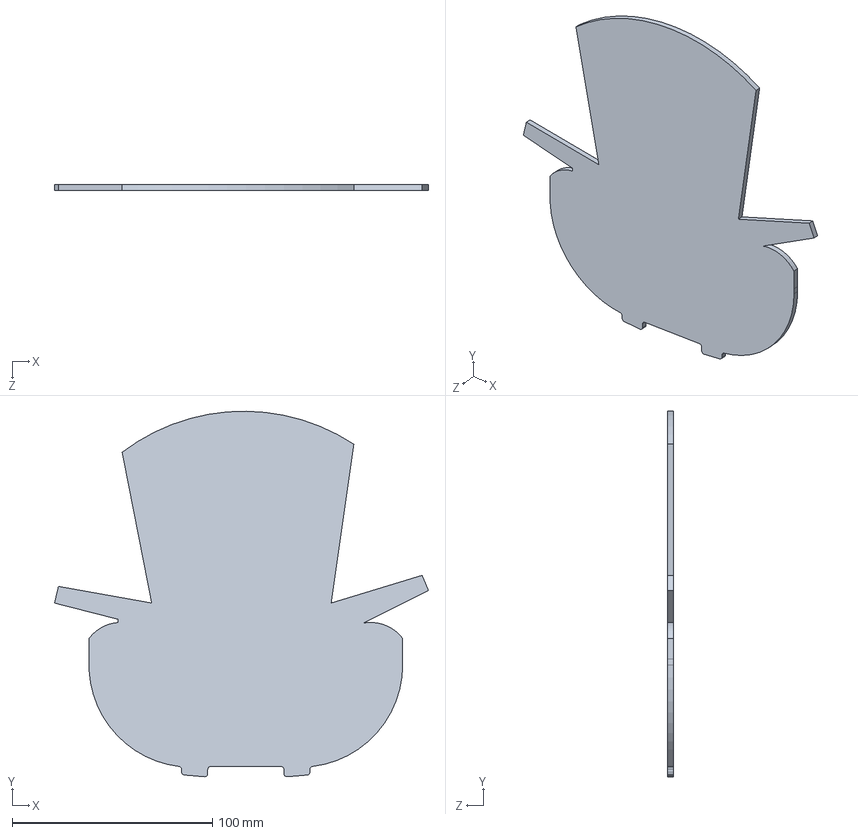
[picture p155: CAD file, 2021-07-20]
Original_ExoMy Release v1.0.2/Parts/STEP/P26_Hat_Tophat.step
186.6 x 182.4 x 3.00 mm
