rbakx/MyExoMy/Original_ExoMy Release v1.0.2/Parts/STL/P25_Mouth_Moustache_2.STL

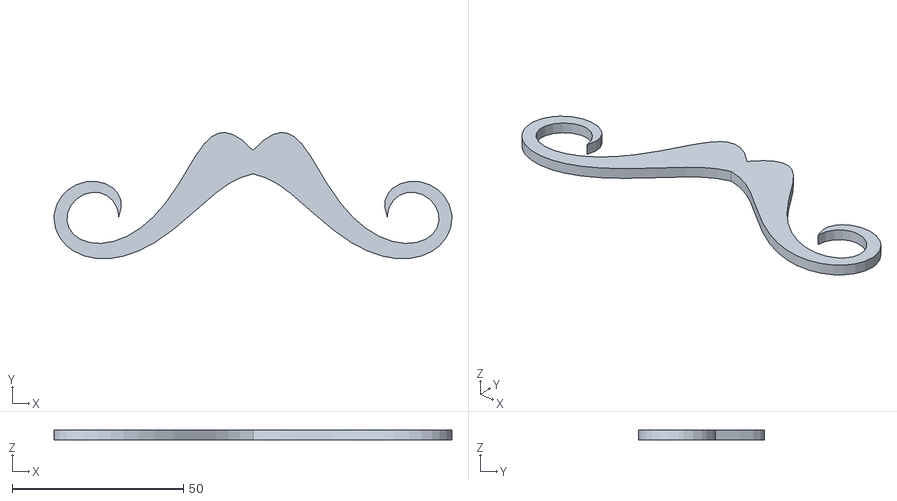
[picture p156: CAD file, 2021-07-20]
Original_ExoMy Release v1.0.2/Parts/STL/P25_Mouth_Moustache_2.STL
116.2 x 36.8 x 3.00
