rbakx/MyExoMy/Exomy_3D/FreeCAD/P03_Bogie_Bearing_ReneB.FCStd

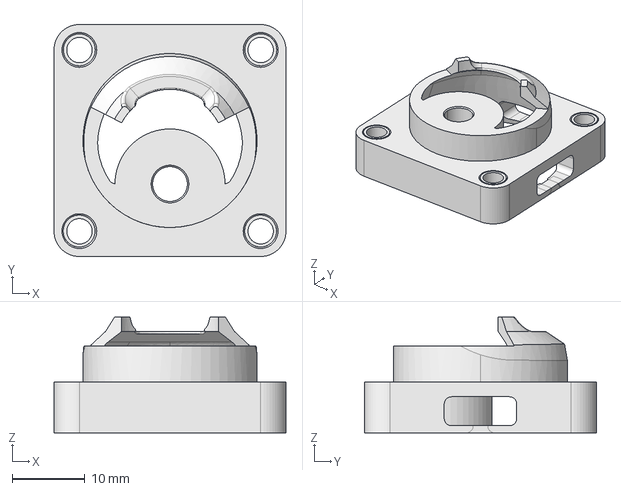
[picture p157: CAD file, 2021-04-27]
Exomy_3D/FreeCAD/P03_Bogie_Bearing_ReneB.FCStd
32.0 x 32.0 x 16.0 mm
