rbakx/MyExoMy/Exomy_3D/FreeCAD/P12_Solar_Panel_Left_Slope_ReneB.FCStd

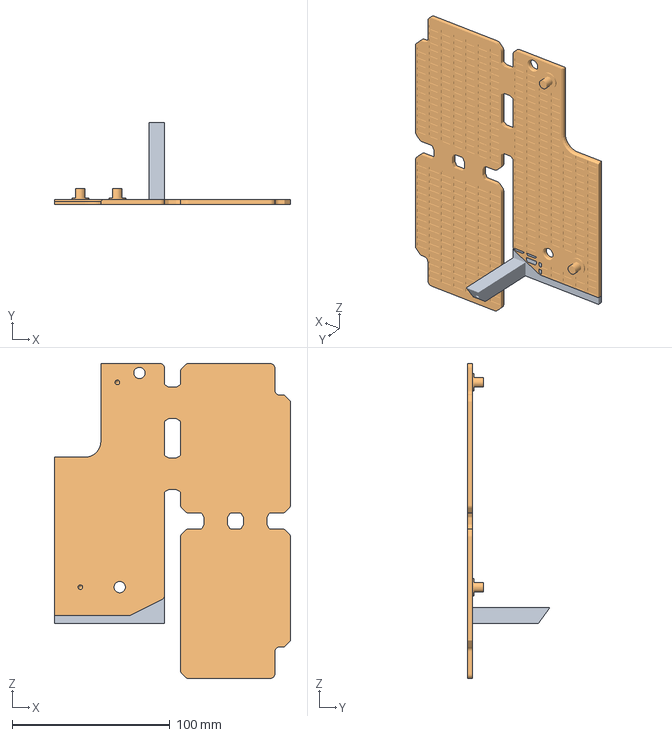
[picture p158: CAD file, 2021-04-20]
Exomy_3D/FreeCAD/P12_Solar_Panel_Left_Slope_ReneB.FCStd
150.0 x 52.0 x 200.0 mm
P12_Solar_Panel_Left
