rbakx/MyExoMy/Original_ExoMy Release v1.0.2/Parts/STEP/P26_Hat_Default.step

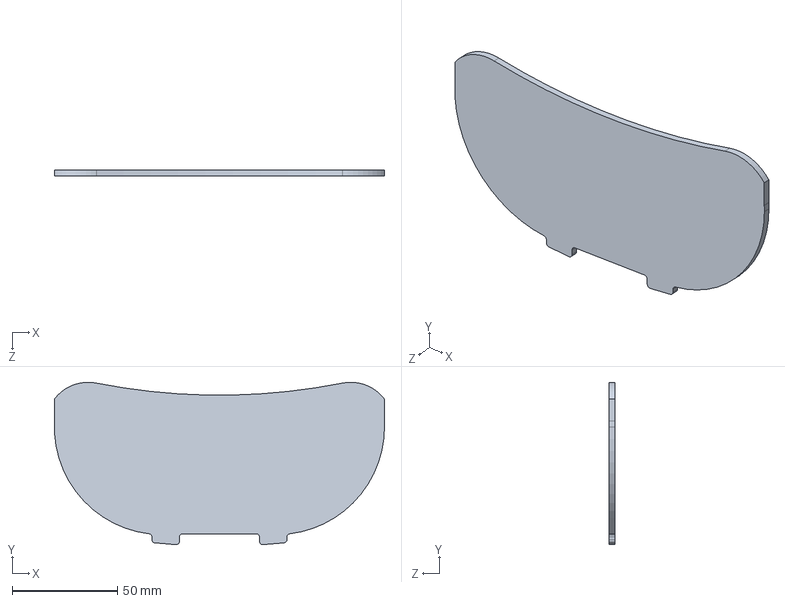
[picture p159: CAD file, 2021-07-20]
Original_ExoMy Release v1.0.2/Parts/STEP/P26_Hat_Default.step
156.5 x 77.0 x 3.00 mm
