rbakx/MyExoMy/Original_ExoMy Release v1.0.2/Parts/STEP/P32_Wheel_Fixing_Plate_U_Shape_Default.step

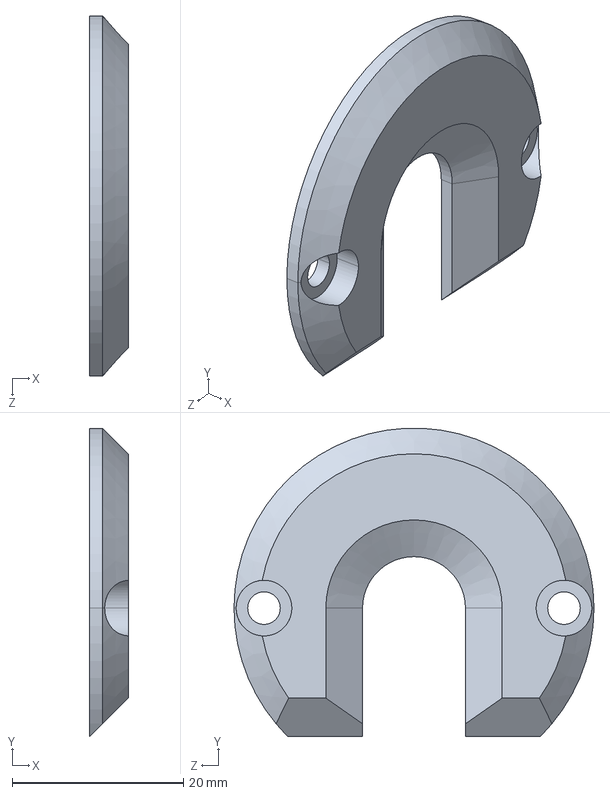
[picture p160: CAD file, 2021-07-20]
Original_ExoMy Release v1.0.2/Parts/STEP/P32_Wheel_Fixing_Plate_U_Shape_Default.step
4.50 x 36.0 x 42.0 mm
