rbakx/MyExoMy/Exomy_3D/FreeCAD/P13_Port_Cover_ReneB.FCStd

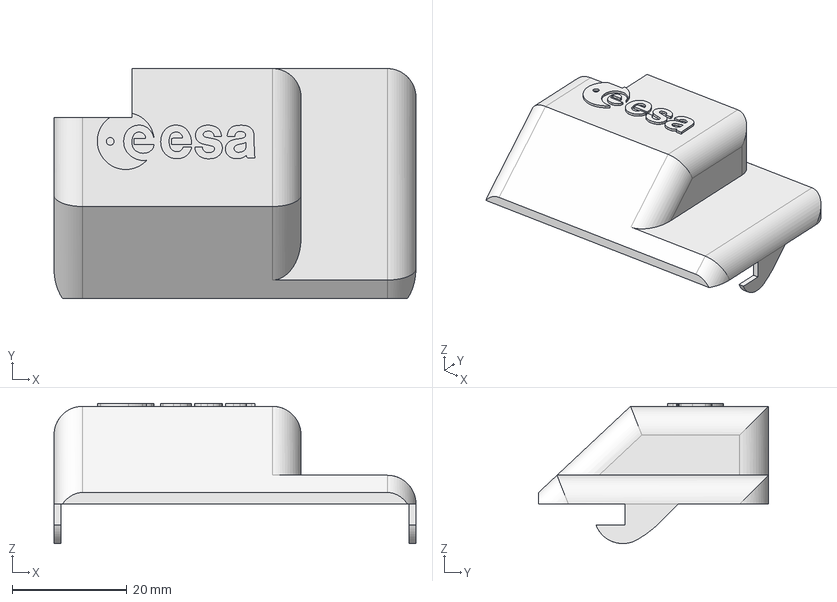
[picture p161: CAD file, 2021-04-18]
Exomy_3D/FreeCAD/P13_Port_Cover_ReneB.FCStd
63.0 x 40.0 x 24.4 mm
