rbakx/MyExoMy/Original_ExoMy Release v1.0.2/Parts/STEP/P23_Eye_Pupil_Default.step

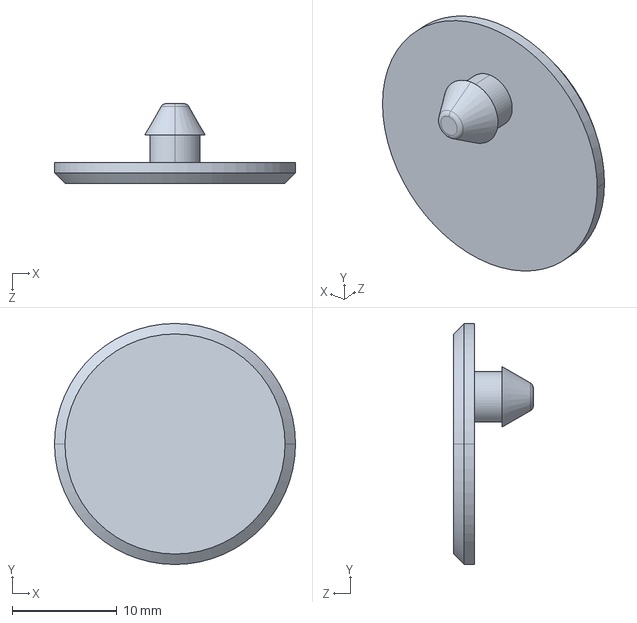
[picture p162: CAD file, 2021-07-20]
Original_ExoMy Release v1.0.2/Parts/STEP/P23_Eye_Pupil_Default.step
23.0 x 23.0 x 7.60 mm
