rbakx/MyExoMy/Exomy_3D/FreeCAD/P21_Mast_Slope_ReneB.FCStd

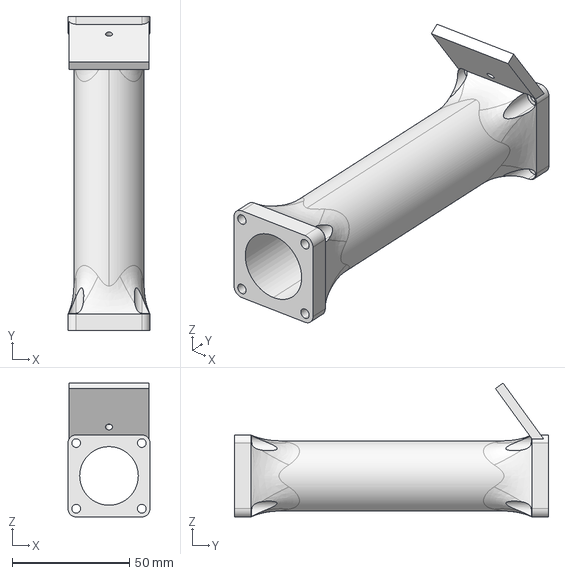
[picture p163: CAD file, 2021-04-17]
Exomy_3D/FreeCAD/P21_Mast_Slope_ReneB.FCStd
35.0 x 134.0 x 57.1 mm
