rbakx/MyExoMy/Original_ExoMy Release v1.0.2/Parts/STEP/P23_Eye_Pupil_Googly.step

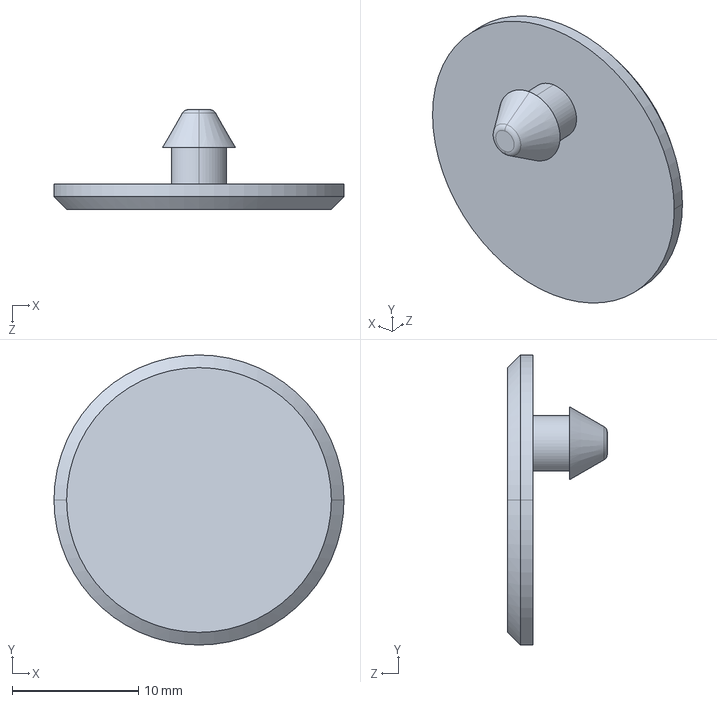
[picture p164: CAD file, 2021-07-20]
Original_ExoMy Release v1.0.2/Parts/STEP/P23_Eye_Pupil_Googly.step
23.0 x 23.0 x 7.90 mm
