rbakx/MyExoMy/Original_ExoMy Release v1.0.2/Parts/STEP/P29_Wheel_Bracket_Fixing_Plate_Default.step

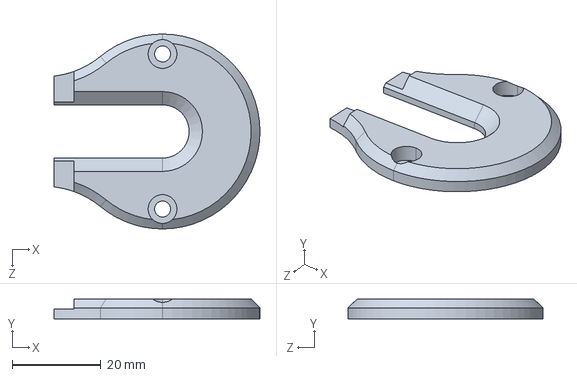
[picture p165: CAD file, 2021-07-20]
Original_ExoMy Release v1.0.2/Parts/STEP/P29_Wheel_Bracket_Fixing_Plate_Default.step
46.5 x 4.50 x 44.0 mm
