rbakx/MyExoMy/Original_ExoMy Release v1.0.2/Parts/STEP/P30_Wheel_Default.step

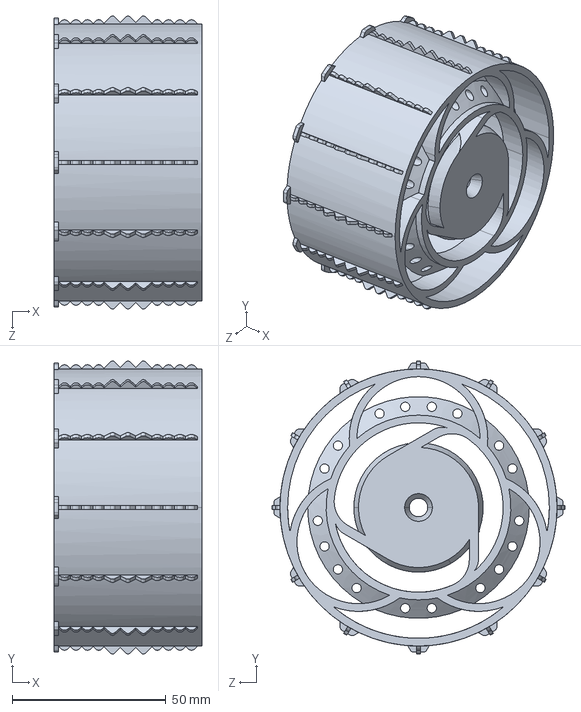
[picture p166: CAD file, 2021-07-20]
Original_ExoMy Release v1.0.2/Parts/STEP/P30_Wheel_Default.step
48.0 x 95.2 x 95.2 mm
