rbakx/MyExoMy/Original_ExoMy Release v1.0.2/Parts/STEP/P22_Eye_White_Default.step

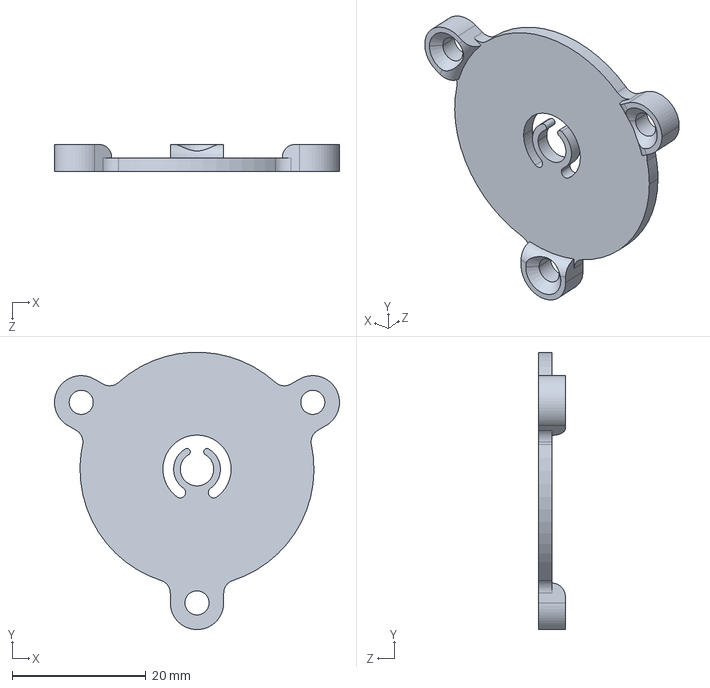
[picture p167: CAD file, 2021-07-20]
Original_ExoMy Release v1.0.2/Parts/STEP/P22_Eye_White_Default.step
42.6 x 41.5 x 4.00 mm
