rbakx/MyExoMy/Original_ExoMy Release v1.0.2/Parts/STEP/P25_Mouth_Moustache.STEP

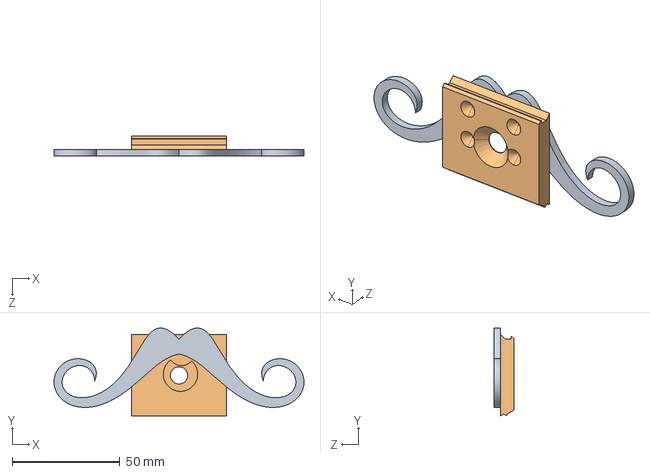
[picture p168: CAD file, 2021-07-20]
Original_ExoMy Release v1.0.2/Parts/STEP/P25_Mouth_Moustache.STEP
116.2 x 40.9 x 9.20 mm
