rbakx/MyExoMy/Original_ExoMy Release v1.0.2/Parts/STEP/P26_Hat_Eyebrows.step

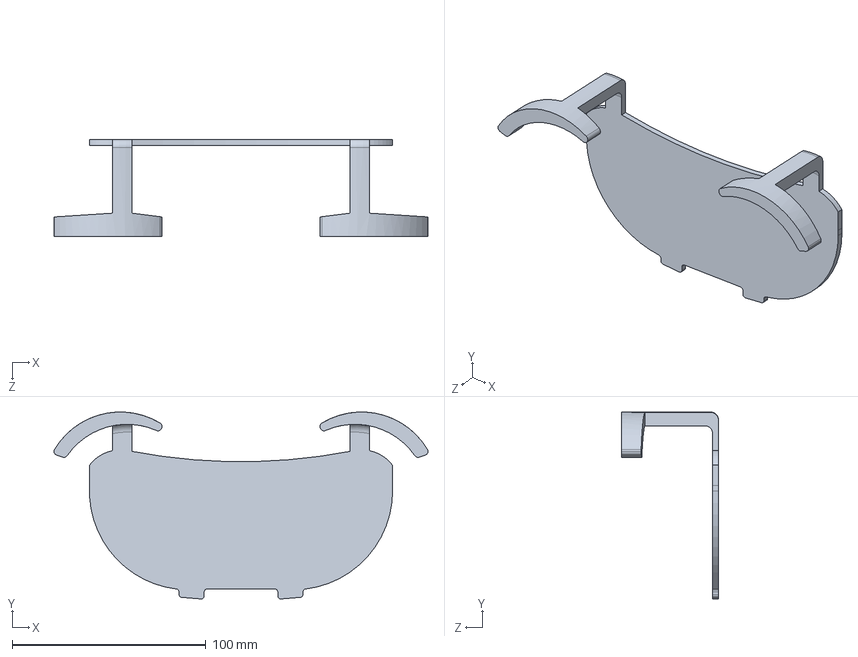
[picture p169: CAD file, 2021-07-20]
Original_ExoMy Release v1.0.2/Parts/STEP/P26_Hat_Eyebrows.step
193.1 x 96.5 x 50.0 mm
