rbakx/MyExoMy/Original_ExoMy Release v1.0.2/Parts/STEP/P17_Bogie_Cable_Cover_Rear Cover.step

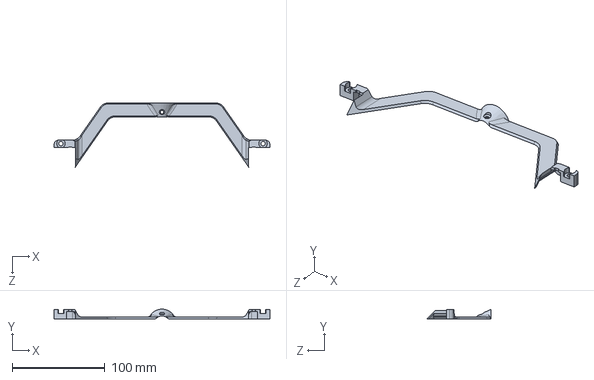
[picture p170: CAD file, 2021-07-20]
Original_ExoMy Release v1.0.2/Parts/STEP/P17_Bogie_Cable_Cover_Rear Cover.step
232.6 x 10.5 x 69.0 mm
