rbakx/MyExoMy/Original_ExoMy Release v1.0.2/Parts/STEP/P20_Head_Default.step

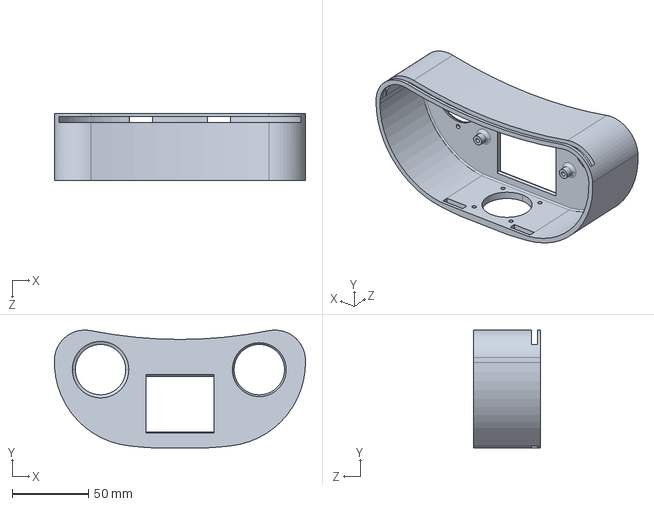
[picture p171: CAD file, 2021-07-20]
Original_ExoMy Release v1.0.2/Parts/STEP/P20_Head_Default.step
164.5 x 77.2 x 44.0 mm
