rbakx/MyExoMy/Original_ExoMy Release v1.0.2/Parts/STEP/P26_Hat_3D-Paxi.step

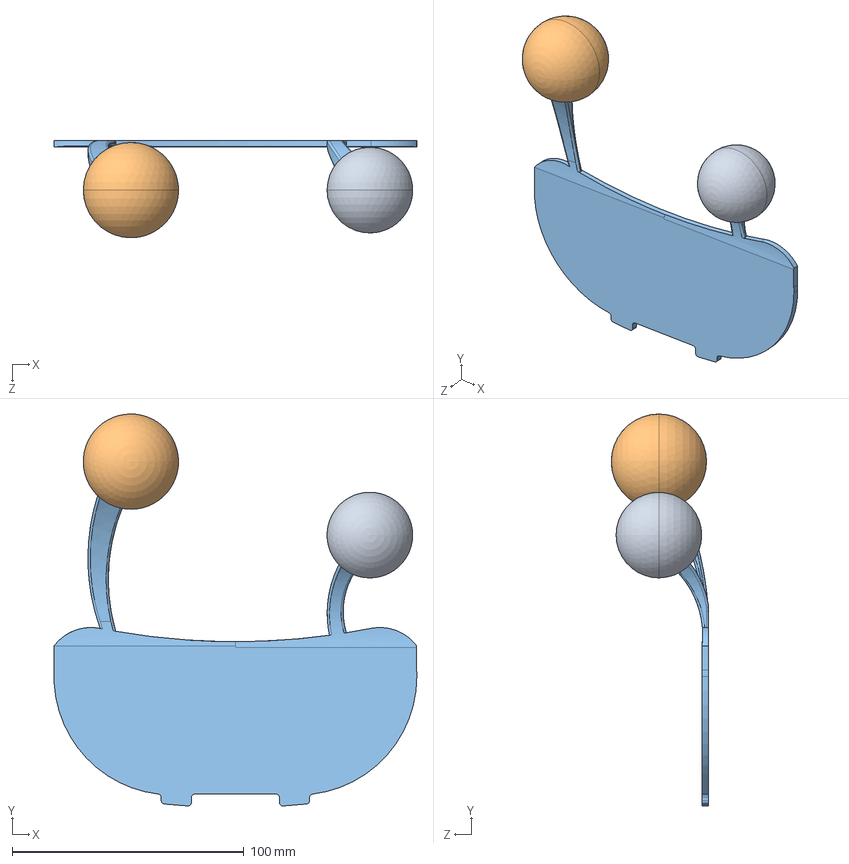
[picture p172: CAD file, 2021-07-20]
Original_ExoMy Release v1.0.2/Parts/STEP/P26_Hat_3D-Paxi.step
156.5 x 169.1 x 42.1 mm
