rbakx/MyExoMy/Original_ExoMy Release v1.0.2/Parts/STEP/P33_Cam_Holder_Flat_Default.step

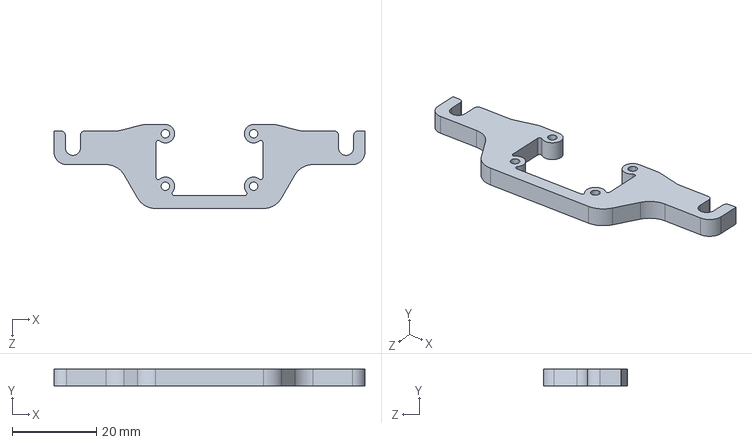
[picture p173: CAD file, 2021-07-20]
Original_ExoMy Release v1.0.2/Parts/STEP/P33_Cam_Holder_Flat_Default.step
74.0 x 4.00 x 20.0 mm
