rbakx/MyExoMy/Original_ExoMy Release v1.0.2/Parts/STEP/P14_Raspi_Holder_Default.step

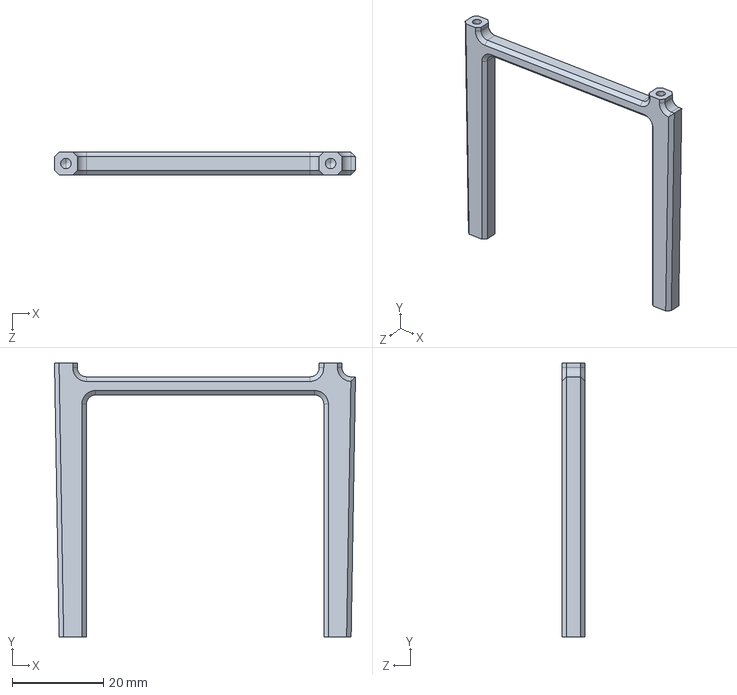
[picture p174: CAD file, 2021-07-20]
Original_ExoMy Release v1.0.2/Parts/STEP/P14_Raspi_Holder_Default.step
65.9 x 60.0 x 5.00 mm
