rbakx/MyExoMy/(list of files, cad)

Other CAD files:
Original_ExoMy Release v1.0.2/Optional_Parts/STEP/P37_Wheel_Sleeve_Full Sleeve Left.STEP
Exomy_3D/FreeCAD/P37_Wheel_Sleeve_Full Sleeve Right.FCStd
Original_ExoMy Release v1.0.2/Parts/STEP/P25_Mouth_Grin.step
Original_ExoMy Release v1.0.2/Parts/STL/P12_Solar_Panel_Right_1.STL
Original_ExoMy Release v1.0.2/Parts/STL/P36_Bow_Tie_Default_2.STL
Exomy_3D/FreeCAD/P12_Solar_Panel_Left_Flat_ReneB.FCStd
Original_ExoMy Release v1.0.2/Parts/STL/P36_Bow_Tie_Default_1.STL
Original_ExoMy Release v1.0.2/Parts/STL/P25_Mouth_Moustache_1.STL
Exomy_3D/FreeCAD/P30_Wheel_Left_Reneb.FCStd
Original_ExoMy Release v1.0.2/Parts/STEP/P19_Bogie_Rear Bogie.step
Original_ExoMy Release v1.0.2/Parts/STL/P12_Solar_Panel_Right_2.STL
Original_ExoMy Release v1.0.2/Parts/STL/P12_Solar_Panel_Right.STL
Exomy_3D/FreeCAD/P12_Solar_Panel_Right_Slope_ReneB.FCStd
Original_ExoMy Release v1.0.2/Parts/STL/P36_Bow_Tie_Default.STL
Original_ExoMy Release v1.0.2/Parts/STEP/P01_Chassis_Two Color Print.step
Original_ExoMy Release v1.0.2/Parts/STEP/P17_Bogie_Cable_Cover_Side.step
Original_ExoMy Release v1.0.2/Parts/STEP/P01_Chassis_Default.step
Original_ExoMy Release v1.0.2/Parts/STEP/P03_Bogie_Bearing_Default.step
Original_ExoMy Release v1.0.2/Parts/STEP/P28_Wheel_Bracket_Split_Right Wiring.step
Original_ExoMy Release v1.0.2/Optional_Parts/STL/P34_Hat_Rack_Default.STL
Original_ExoMy Release v1.0.2/Optional_Parts/STL/P37_Wheel_Sleeve_Full Sleeve Left.STL
Original_ExoMy Release v1.0.2/Optional_Parts/STL/P37_Wheel_Sleeve_Full Sleeve Right.STL
Original_ExoMy Release v1.0.2/Parts/STL/P01_Chassis_Default.STL
Original_ExoMy Release v1.0.2/Parts/STL/P03_Bogie_Bearing_Default.STL
Original_ExoMy Release v1.0.2/Parts/STL/P04_Battery_Holddown_Default.STL
Original_ExoMy Release v1.0.2/Parts/STL/P11_Top_Default.STL
Original_ExoMy Release v1.0.2/Parts/STL/P13_Port_Cover_Default.STL
Original_ExoMy Release v1.0.2/Parts/STL/P14_Raspi_Holder_Default.STL
Original_ExoMy Release v1.0.2/Parts/STL/P15_DCDC_Holddown_Default.STL
Original_ExoMy Release v1.0.2/Parts/STL/P17_Bogie_Cable_Cover_Rear Cover.STL
Original_ExoMy Release v1.0.2/Parts/STL/P17_Bogie_Cable_Cover_Side.STL
Original_ExoMy Release v1.0.2/Parts/STL/P19_Bogie_Rear Bogie.STL
Original_ExoMy Release v1.0.2/Parts/STL/P19_Bogie_Side.STL
Original_ExoMy Release v1.0.2/Parts/STL/P20_Head_Default.STL
Original_ExoMy Release v1.0.2/Parts/STL/P21_Mast_Default.STL
Original_ExoMy Release v1.0.2/Parts/STL/P22_Eye_White_Default.STL
Original_ExoMy Release v1.0.2/Parts/STL/P23_Eye_Pupil_Default.STL
Original_ExoMy Release v1.0.2/Parts/STL/P23_Eye_Pupil_Googly.STL
Original_ExoMy Release v1.0.2/Parts/STL/P24_Mouth_Latch_Default.STL
Original_ExoMy Release v1.0.2/Parts/STL/P25_Mouth_Default.STL
Original_ExoMy Release v1.0.2/Parts/STL/P25_Mouth_Grin.STL
Original_ExoMy Release v1.0.2/Parts/STL/P25_Mouth_Monocle.STL
Original_ExoMy Release v1.0.2/Parts/STL/P25_Mouth_Moustache.STL
Original_ExoMy Release v1.0.2/Parts/STL/P25_Mouth_Shocked.STL
Original_ExoMy Release v1.0.2/Parts/STL/P26_Hat_3D-Paxi.STL
Original_ExoMy Release v1.0.2/Parts/STL/P26_Hat_Alien.STL
Original_ExoMy Release v1.0.2/Parts/STL/P26_Hat_Default.STL
Original_ExoMy Release v1.0.2/Parts/STL/P26_Hat_Eyebrows.STL
Original_ExoMy Release v1.0.2/Parts/STL/P26_Hat_Pumpkin.STL
Original_ExoMy Release v1.0.2/Parts/STL/P26_Hat_Tophat.STL
Original_ExoMy Release v1.0.2/Parts/STL/P26_Hat_Wizard.STL
Original_ExoMy Release v1.0.2/Parts/STL/P28_Wheel_Bracket_Split_Left Wiring.STL
Original_ExoMy Release v1.0.2/Parts/STL/P28_Wheel_Bracket_Split_Right Wiring.STL
Original_ExoMy Release v1.0.2/Parts/STL/P29_Wheel_Bracket_Fixing_Plate_Default.STL
Original_ExoMy Release v1.0.2/Parts/STL/P30_Wheel_Default.STL
Original_ExoMy Release v1.0.2/Parts/STL/P32_Wheel_Fixing_Plate_U_Shape_Default.STL
Original_ExoMy Release v1.0.2/Parts/STL/P33_Cam_Holder_Flat_Default.STL
