rbakx/MyExoMy/Original_ExoMy Release v1.0.2/Parts/PNG/A04_Wheel_Assembly_AI_Without_Wheel_L.png

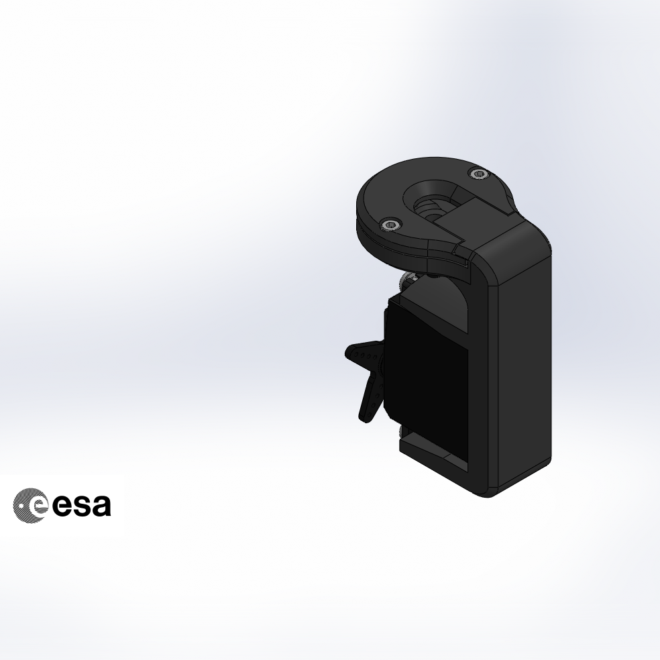
Original_ExoMy Release v1.0.2/Parts/PNG/A04_Wheel_Assembly_AI_Without_Wheel_L.png
