rbakx/MyExoMy/Original_ExoMy Release v1.0.2/Technical_Drawings/PDF/AI_Chassis_BoM.pdf

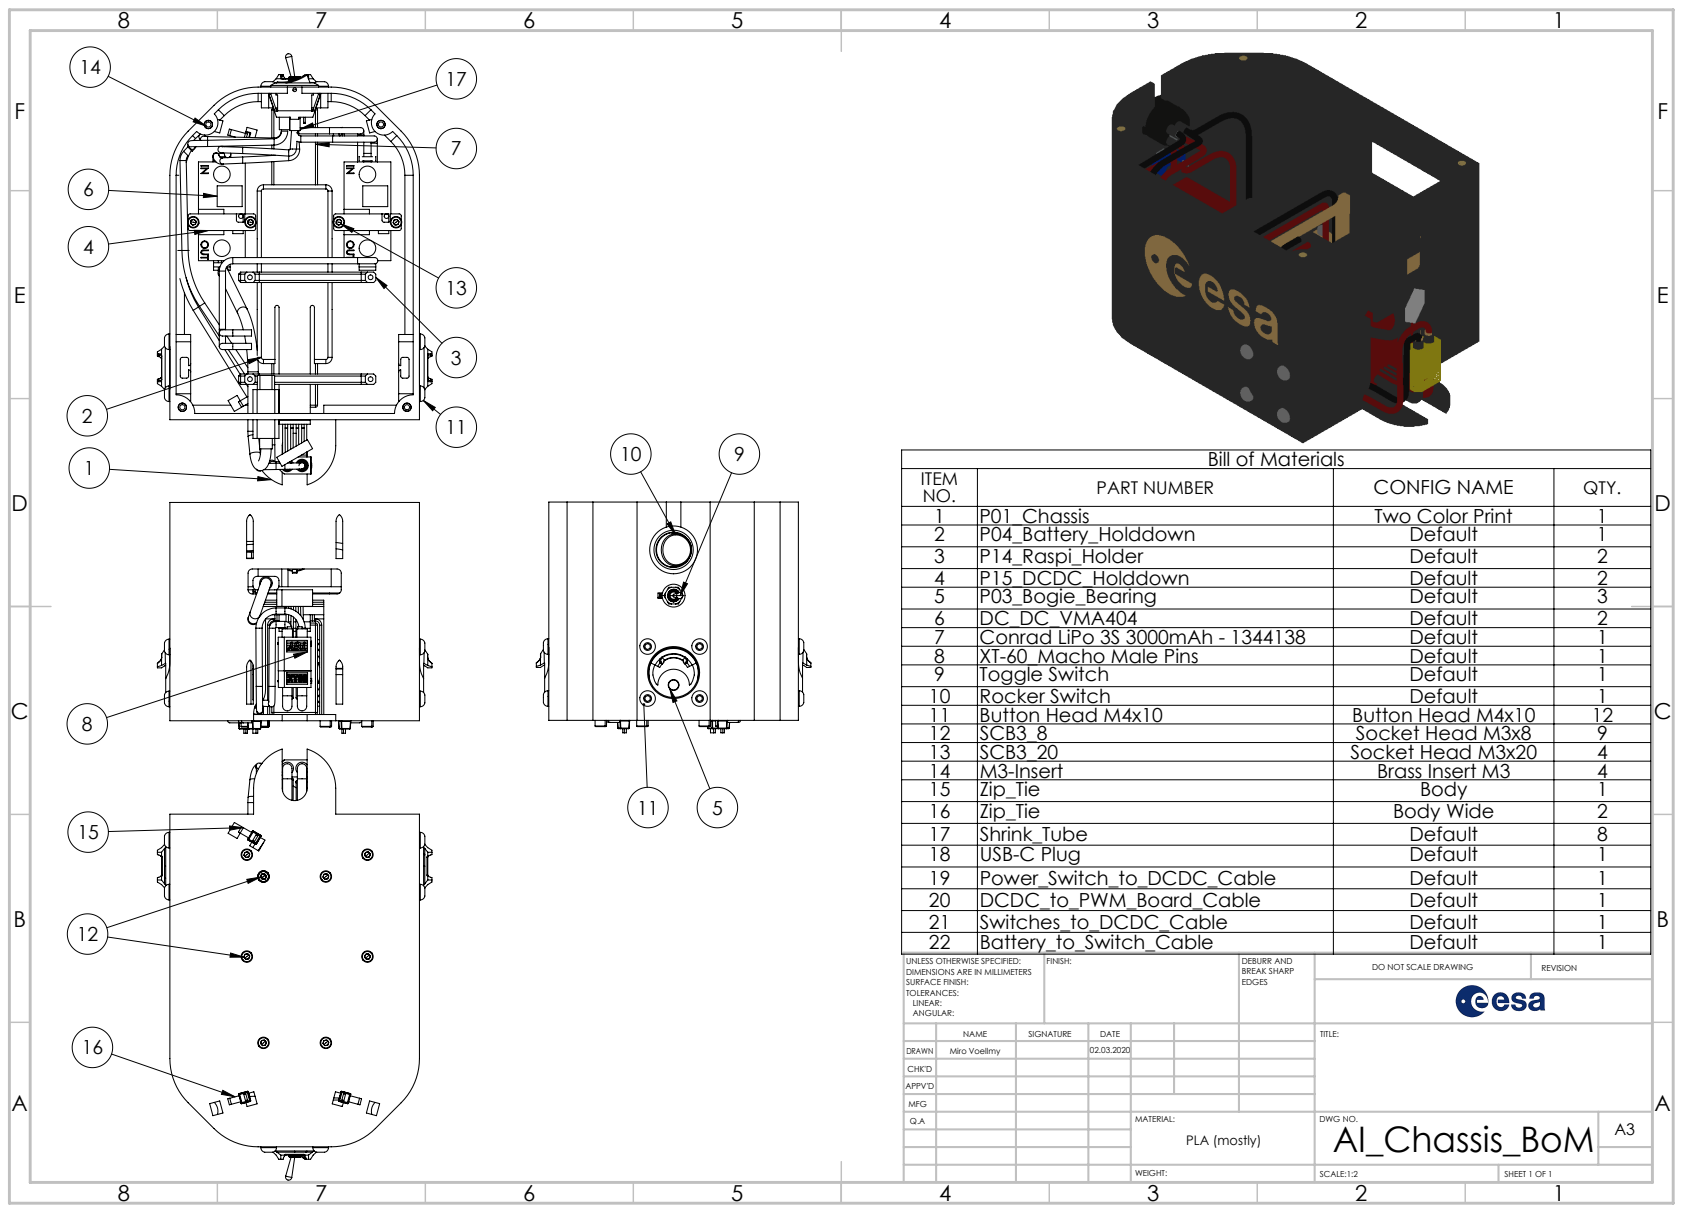
[picture p176: page 1]
PART NUMBER; CONFIG NAME; QTY. 1; P01_Chassis; Two Color Print; P04_Battery_Holddown; Default; P14_Raspi_Holder; P15_DCDC_Holddown; P03_Bogie_Bearing; DC_DC_VMA404; Conrad LiPo 3S 3000mAh - 1344138; XT-60_Macho Male Pins; Toggle Switch; SCALE:1:2; SHEET 1 OF 1

Bill of Materials

10 | Rocker Switch | Default | 1
11 | Button Head M4x10 | Button Head M4x10 | 12
12 | SCB3_8 | Socket Head M3x8 | 9
13 | SCB3_20 | Socket Head M3x20 | 4
14 | M3-Insert | Brass Insert M3 | 4
15 | Zip_Tie | Body | 1
16 | Zip_Tie | Body Wide | 2
17 | Shrink_Tube | Default | 8
18 | USB-C Plug | Default | 1
19 | Power_Switch_to_DCDC_Cable | Default | 1
20 | DCDC_to_PWM_Board_Cable | Default | 1
21 | Switches_to_DCDC_Cable | Default | 1
22 | Battery_to_Switch_Cable | Default | 1

UNLESS OTHERWISE SPECIFIED: DIMENSIONS ARE IN MILLIMETERS SURFACE FINISH: TOLERANCES: LINEAR: ANGULAR: | FINISH: | DEBURR AND BREAK SHARP EDGES | DO NOT SCALE DRAWING | REVISION

NAME | SIGNATURE | DATE | | | | TITLE:

DRAWN | Miro Voellmy | | 02.03.2020
CHK'D
APPV'D
MFG
Q.A | | | | MATERIAL: | DWG NO. AI_Chassis_BoM | A3 PLA (mostly)
