rbakx/MyExoMy/Original_ExoMy Release v1.0.2/Technical_Drawings/PDF/MI_Printed_Parts_BoM.pdf

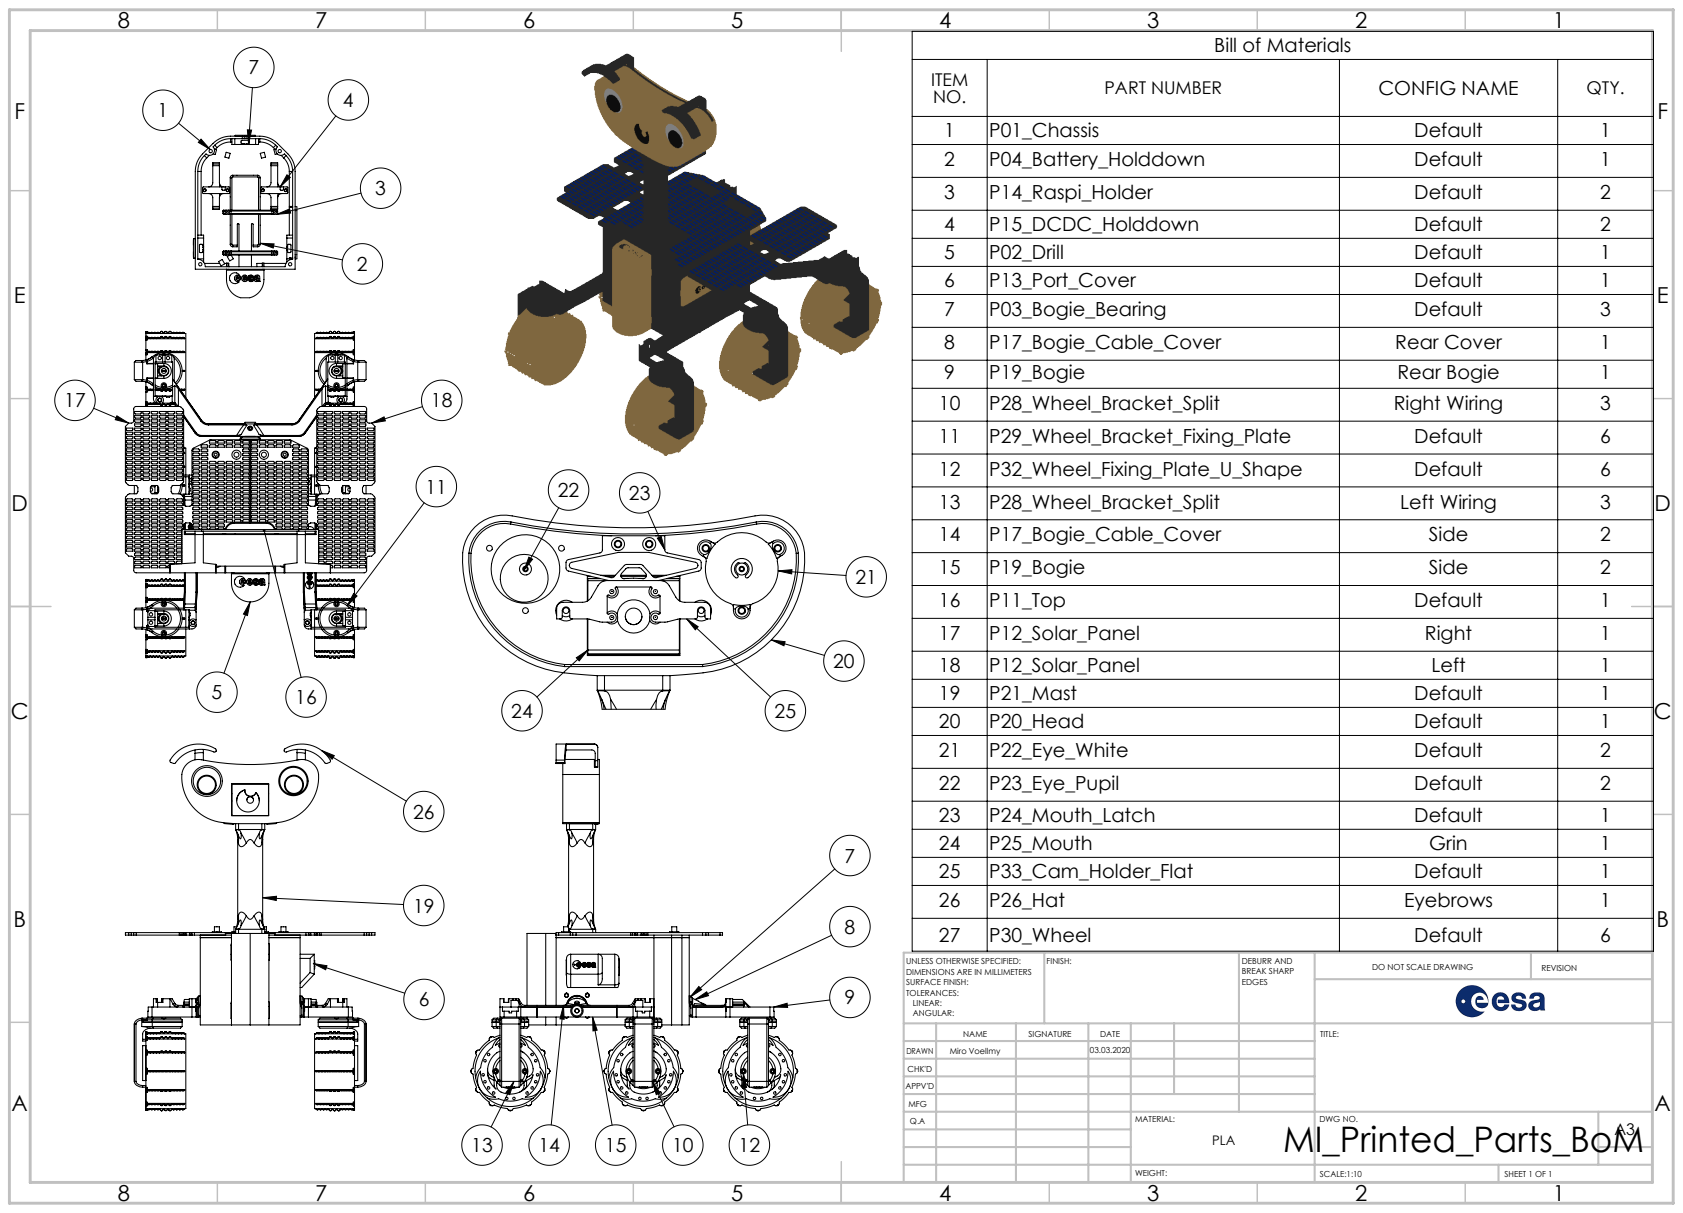
[picture p177: page 1]
PART NUMBER; CONFIG NAME; QTY. 1; P01_Chassis; Default; P04_Battery_Holddown; P14_Raspi_Holder; P15_DCDC_Holddown; P02_Drill; P13_Port_Cover; P03_Bogie_Bearing; P17_Bogie_Cable_Cover; Rear Cover; P19_Bogie; Rear Bogie; SCALE:1:10; SHEET 1 OF 1

Bill of Materials

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

NAME | SIGNATURE | DATE | | | | TITLE:

DRAWN | Miro Voellmy | | 03.03.2020
CHK'D
APPV'D
MFG
Q.A | | | | MATERIAL: MI_Printed_Parts_BoM PLA | DWG NO. | A3
