rbakx/MyExoMy/Original_ExoMy Release v1.0.2/Technical_Drawings/PDF/AI_Rear_Bogie_BoM.pdf

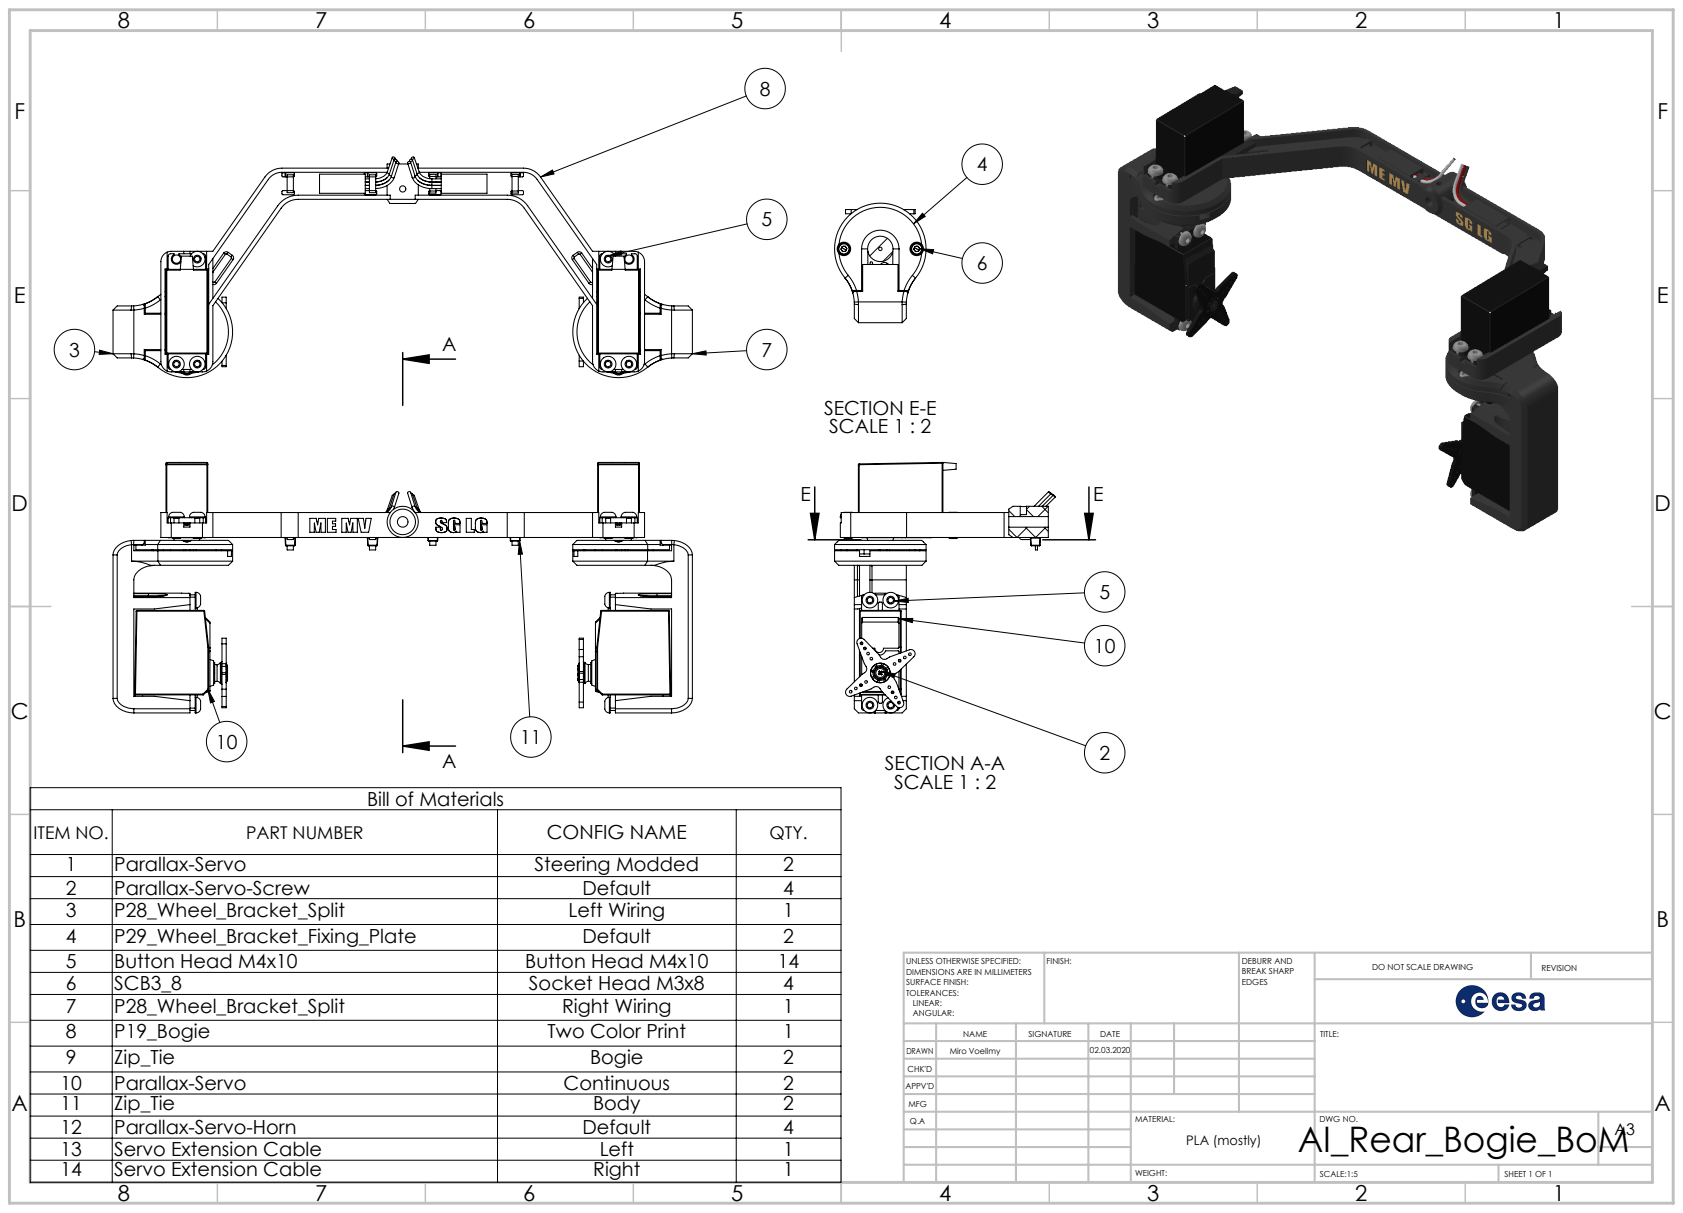
[picture p180: page 1]
SECTION A-A SCALE 1 : 2; SECTION E-E SCALE 1 : 2; Button Head M4x10; P19_Bogie; Two Color Print; FINISH:; DEBURR AND; BREAK SHARP; DO NOT SCALE DRAWING; REVISION

Bill of Materials

ITEM NO. | PART NUMBER | CONFIG NAME | QTY.
1 | Parallax-Servo | Steering Modded | 2
2 | Parallax-Servo-Screw | Default | 4
3 | P28_Wheel_Bracket_Split | Left Wiring | 1
4 | P29_Wheel_Bracket_Fixing_Plate | Default | 2
6 | SCB3_8 | Socket Head M3x8 | 4
7 | P28_Wheel_Bracket_Split | Right Wiring | 1

UNLESS OTHERWISE SPECIFIED:
DIMENSIONS ARE IN MILLIMETERS
SURFACE FINISH:
TOLERANCES:
LINEAR:
ANGULAR:

9 | Zip_Tie | Bogie | 2
10 | Parallax-Servo | Continuous | 2
12 | Parallax-Servo-Horn | Default | 4
13 | Servo Extension Cable | Left | 1
14 | Servo Extension Cable | Right | 1

DRAWN | Miro Voellmy | 02.03.2020
CHK'D
APPV'D

Q.A | MATERIAL: AI_Rear_Bogie_BoM | DWG NO. | A3 PLA (mostly)

WEIGHT: | SCALE:1:5 | SHEET 1 OF 1
