rbakx/MyExoMy/Original_ExoMy Release v1.0.2/Technical_Drawings/PDF/AI_Side_Bogie_BoM.pdf

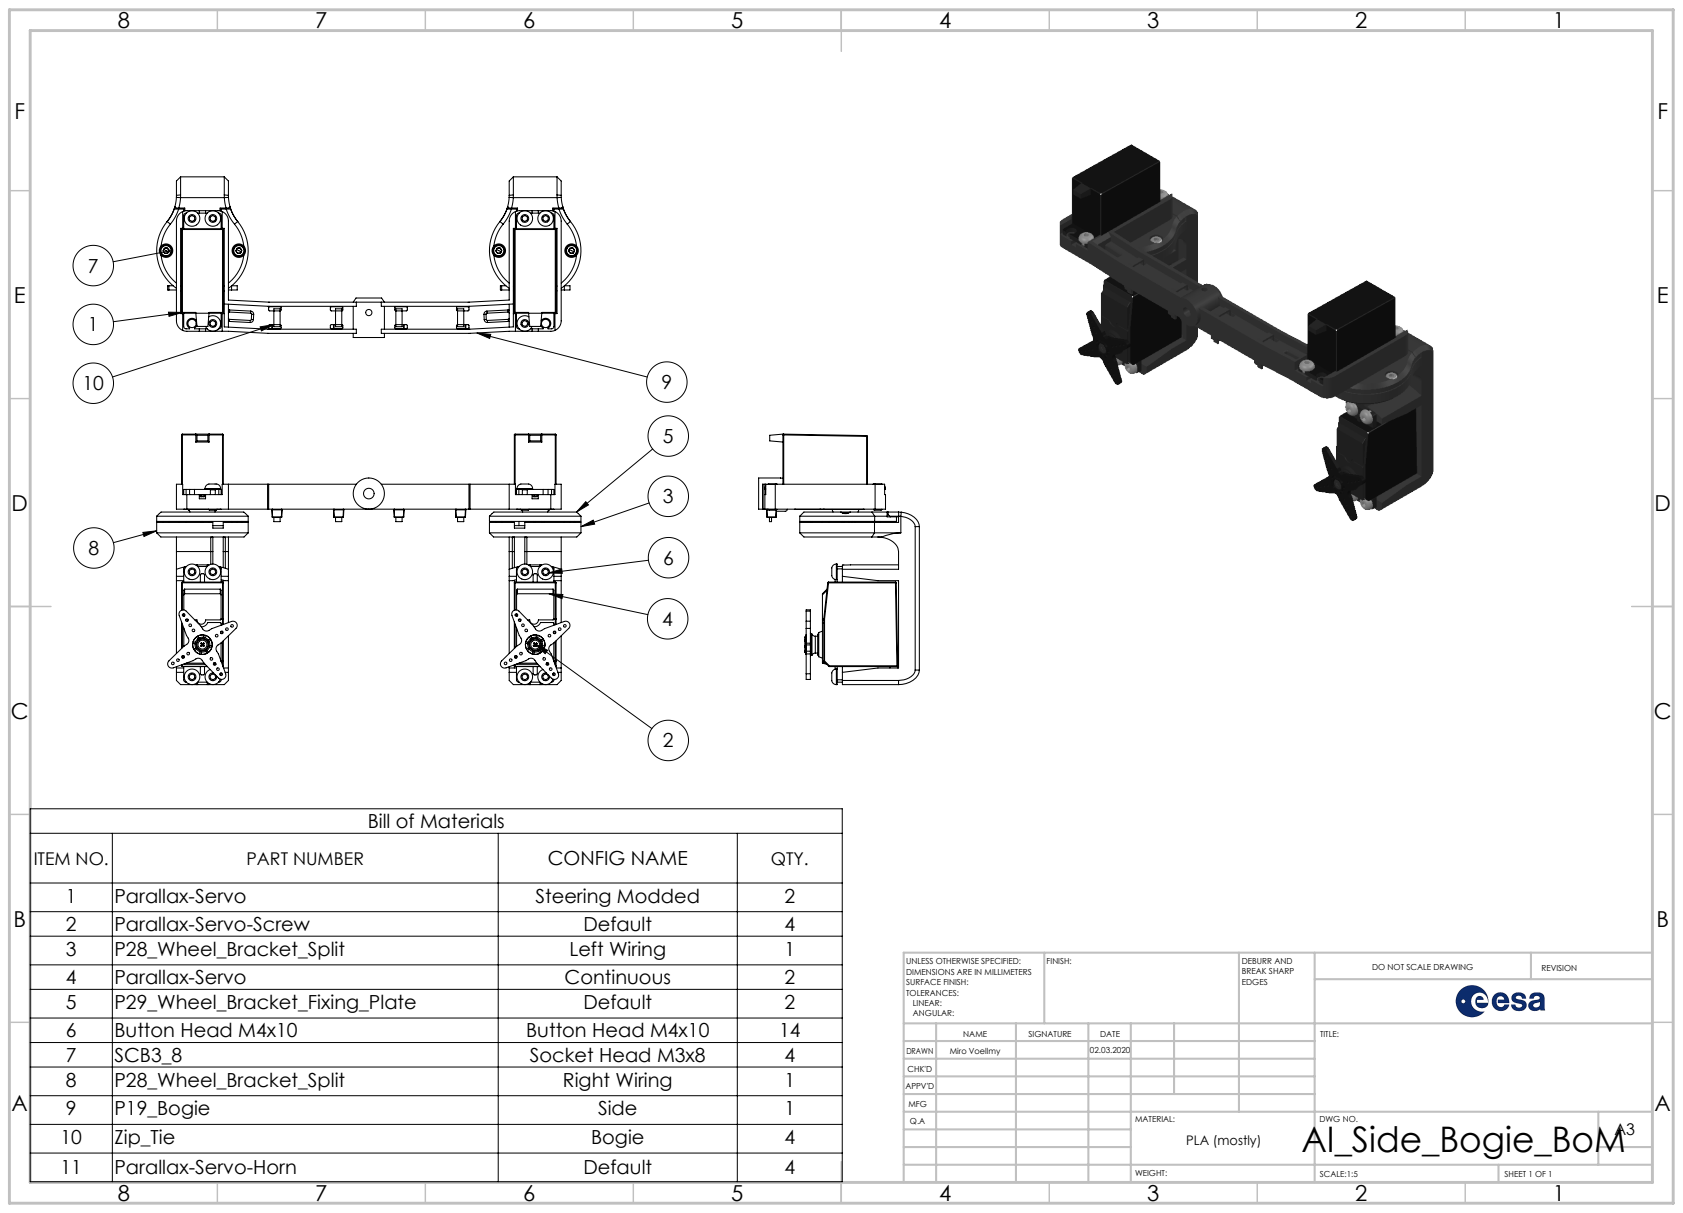
[picture p181: page 1]
SCB3_8; Socket Head M3x8; FINISH:; DEBURR AND; BREAK SHARP; DO NOT SCALE DRAWING; REVISION; SCALE:1:5; SHEET 1 OF 1; Miro Voellmy

Bill of Materials

ITEM NO. | PART NUMBER | CONFIG NAME | QTY.
1 | Parallax-Servo | Steering Modded | 2
2 | Parallax-Servo-Screw | Default | 4
3 | P28_Wheel_Bracket_Split | Left Wiring | 1
4 | Parallax-Servo | Continuous | 2
5 | P29_Wheel_Bracket_Fixing_Plate | Default | 2
6 | Button Head M4x10 | Button Head M4x10 | 14
8 | P28_Wheel_Bracket_Split | Right Wiring | 1

UNLESS OTHERWISE SPECIFIED:
DIMENSIONS ARE IN MILLIMETERS
SURFACE FINISH:
TOLERANCES:
LINEAR:
ANGULAR:

NAME | SIGNATURE | DATE | TITLE:

CHK'D
APPV'D

Q.A | MATERIAL: AI_Side_Bogie_BoM | DWG NO. | A3 PLA (mostly)

10 | Zip_Tie | Bogie | 4
