rbakx/MyExoMy/Original_ExoMy Release v1.0.2/Technical_Drawings/PDF/AI_Top_BoM.pdf

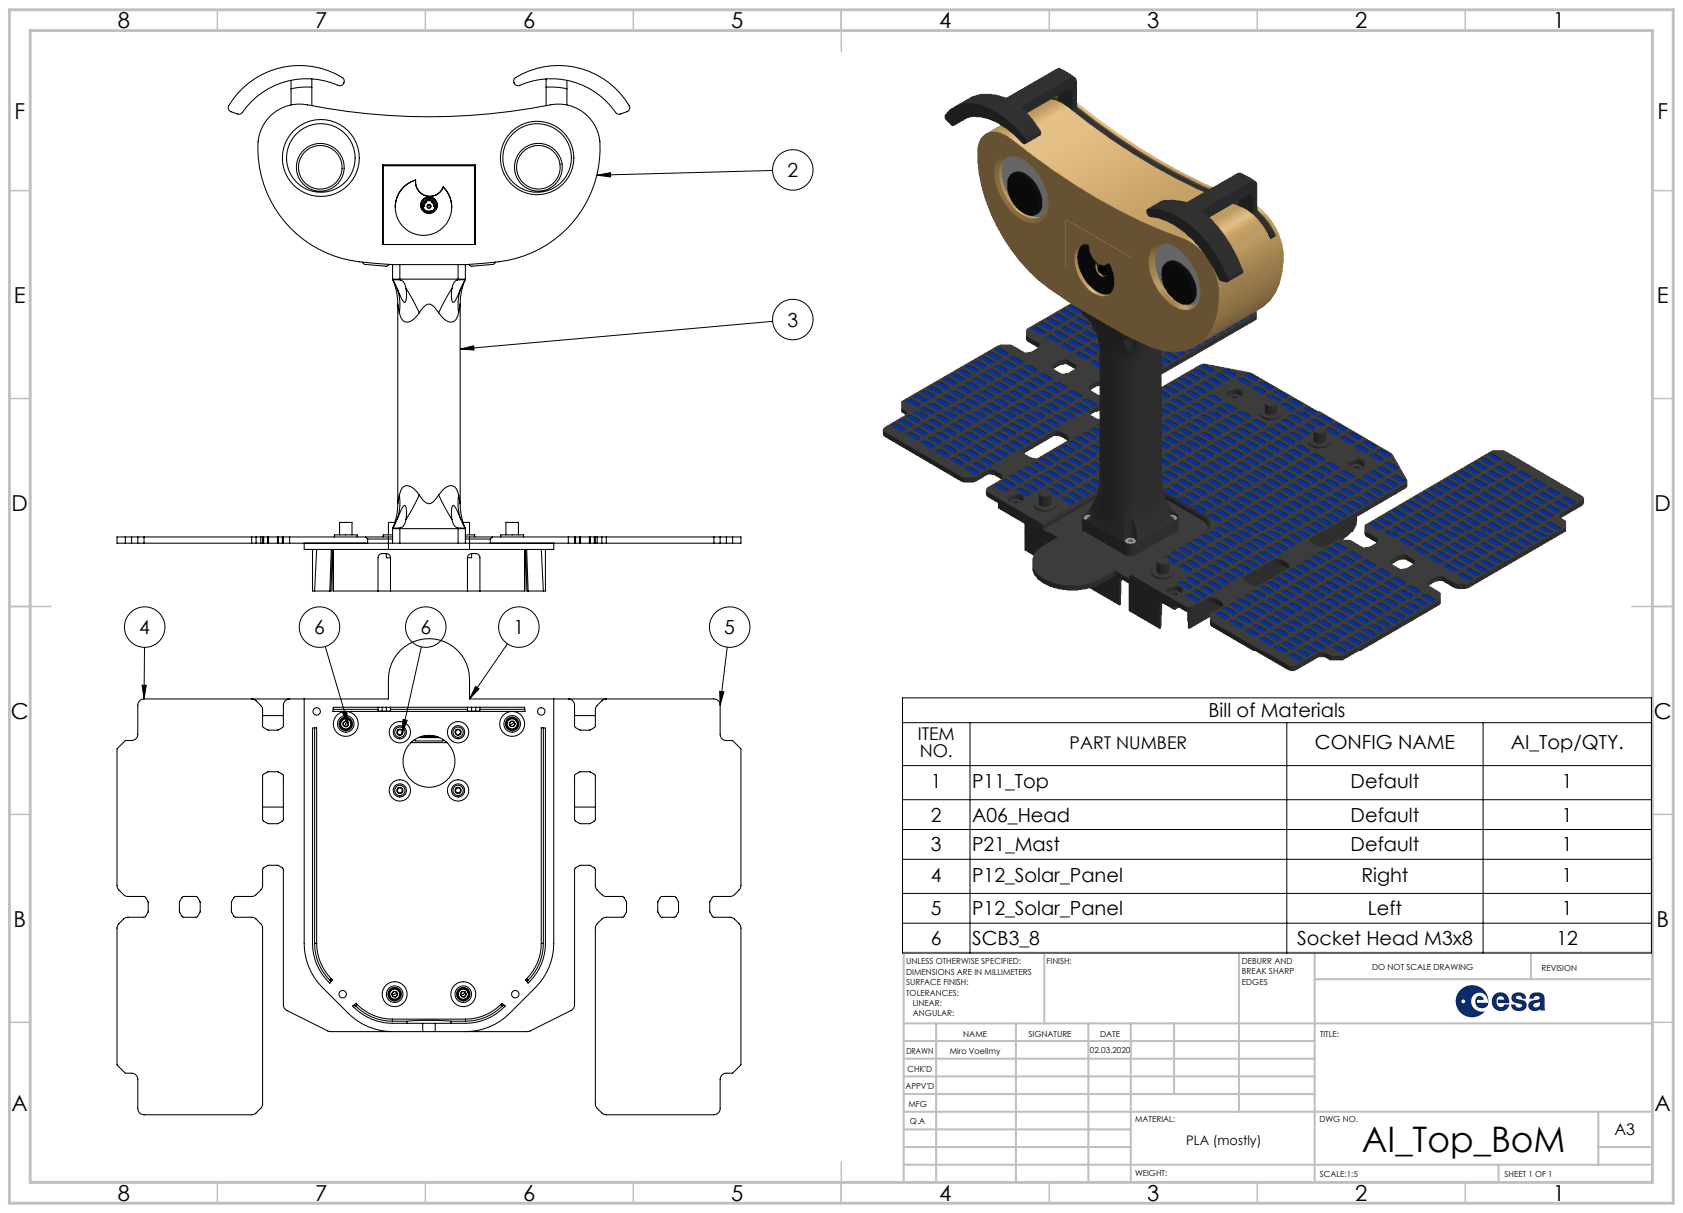
[picture p182: page 1]
SCALE:1:5; SHEET 1 OF 1

Bill of Materials

ITEM NO. | PART NUMBER | CONFIG NAME | AI_Top/QTY.
1 | P11_Top | Default | 1
2 | A06_Head | Default | 1
3 | P21_Mast | Default | 1
4 | P12_Solar_Panel | Right | 1
5 | P12_Solar_Panel | Left | 1
6 | SCB3_8 | Socket Head M3x8 | 12

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

NAME | SIGNATURE | DATE | | | | TITLE:

DRAWN | Miro Voellmy | | 02.03.2020
CHK'D
APPV'D
MFG
Q.A | | | | MATERIAL: | DWG NO. AI_Top_BoM | A3 PLA (mostly)
