rbakx/MyExoMy/Original_ExoMy Release v1.0.2/Technical_Drawings/PDF/MI_Wire_Harness_BoM.pdf

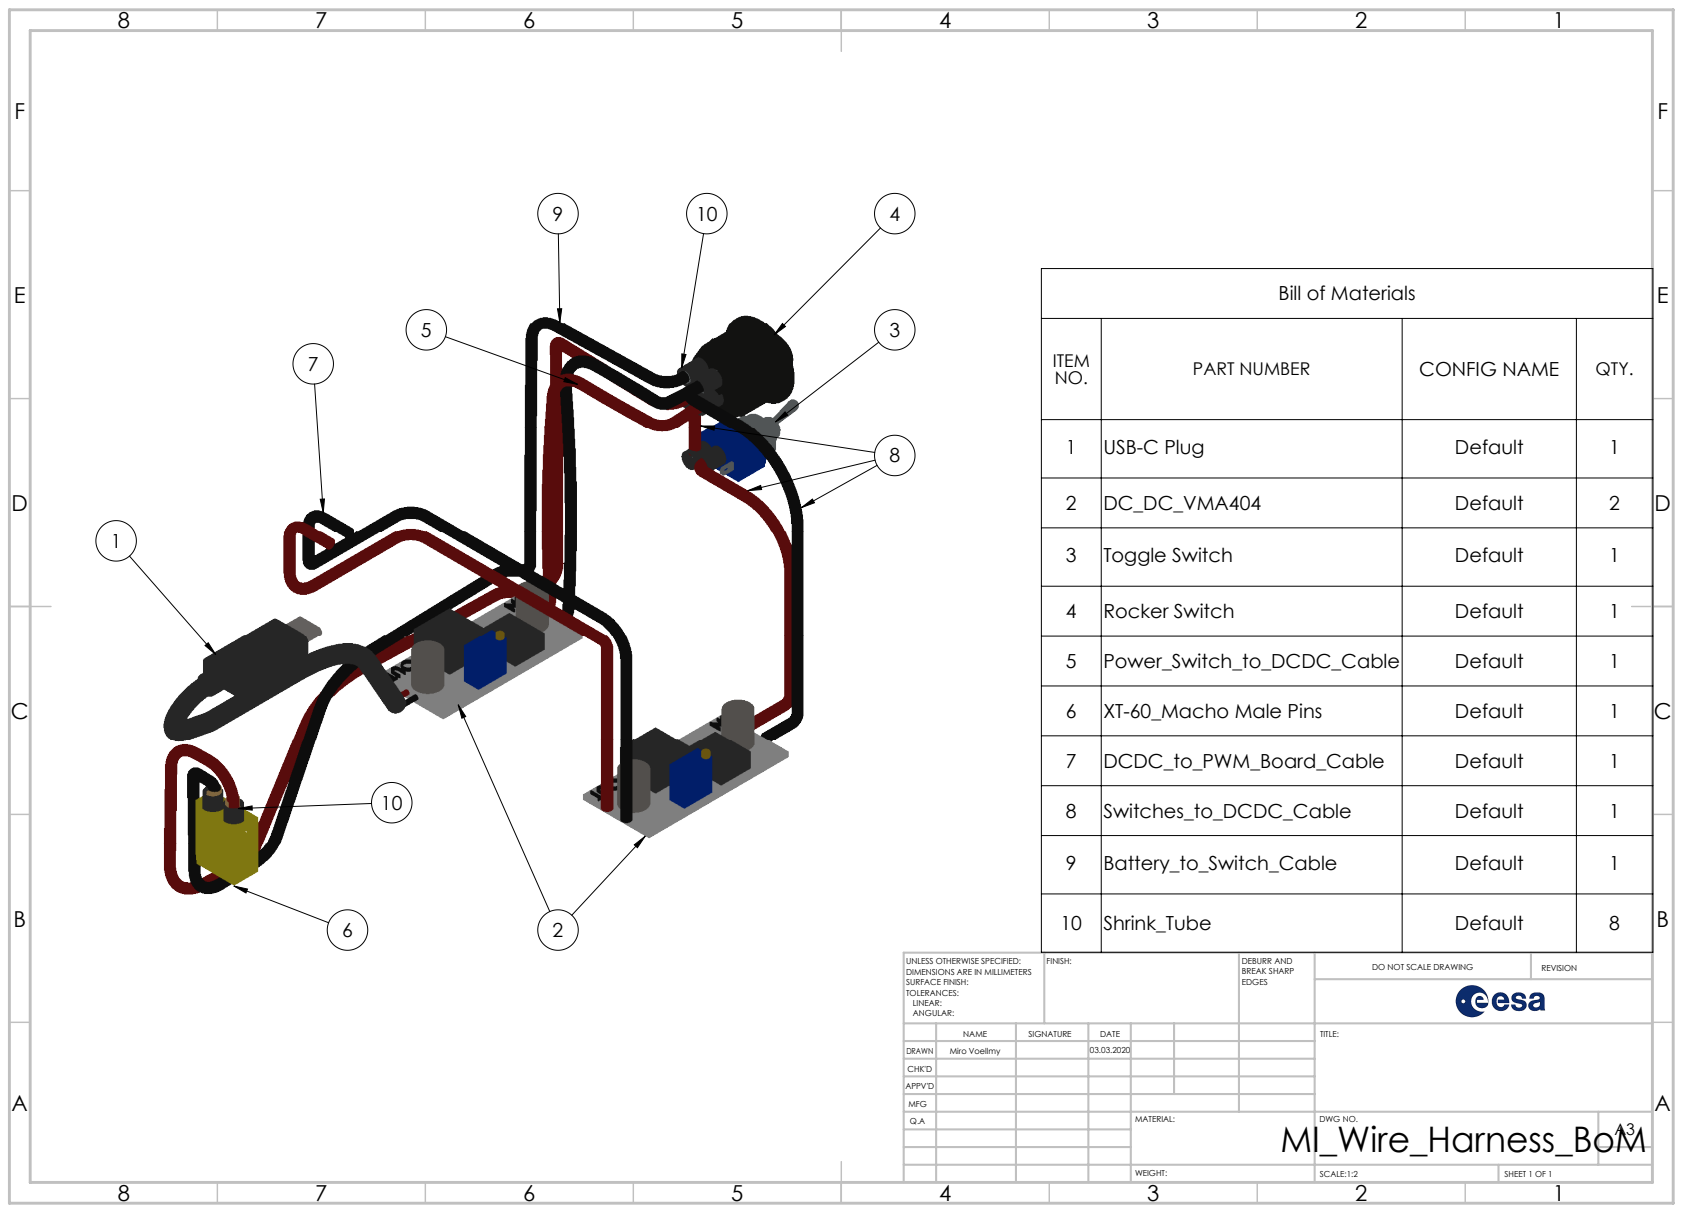
[picture p183: page 1]
SCALE:1:2; SHEET 1 OF 1

Bill of Materials

ITEM NO. | PART NUMBER | CONFIG NAME | QTY.

1 | USB-C Plug | Default | 1

2 | DC_DC_VMA404 | Default | 2

3 | Toggle Switch | Default | 1

4 | Rocker Switch | Default | 1
5 | Power_Switch_to_DCDC_Cable | Default | 1
6 | XT-60_Macho Male Pins | Default | 1
7 | DCDC_to_PWM_Board_Cable | Default | 1
8 | Switches_to_DCDC_Cable | Default | 1

9 | Battery_to_Switch_Cable | Default | 1

10 | Shrink_Tube | Default | 8

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

NAME | SIGNATURE | DATE | | | | TITLE:

DRAWN | Miro Voellmy | | 03.03.2020
CHK'D
APPV'D
MFG
Q.A | | | | MATERIAL: MI_Wire_Harness_BoM | DWG NO. | A3
