rbakx/MyExoMy/(list of files, drawings)

Other design files:
Exomy_Hardware/EasyEda/offline_projects_backup/MyExomy/20210913_211129/PCB_MyExomy.json
Exomy_Hardware/EasyEda/offline_projects_backup/MyExomy/20210913_211634/PCB_MyExomy.json
Exomy_Hardware/EasyEda/offline_projects_backup/MyExomy/20210913_230019/PCB_MyExomy.json
Exomy_Hardware/EasyEda/offline_projects_backup/MyExomy/20210913_230315/PCB_MyExomy.json
Exomy_Hardware/EasyEda/offline_projects_backup/MyExomy/20210913_230434/PCB_MyExomy.json
Exomy_Hardware/EasyEda/offline_projects_backup/MyExomy/20210913_230539/PCB_MyExomy.json
Exomy_Hardware/EasyEda/offline_projects_backup/MyExomy/20210913_230545/PCB_MyExomy.json
Exomy_Hardware/EasyEda/offline_projects_backup/MyExomy/20210913_230617/PCB_MyExomy.json
Exomy_Hardware/EasyEda/offline_projects_backup/MyExomy/20210913_230648/PCB_MyExomy.json
Exomy_Hardware/EasyEda/offline_projects_backup/MyExomy/20210913_230746/PCB_MyExomy.json
Exomy_Hardware/EasyEda/offline_projects_backup/MyExomy/20210925_135301/PCB_MyExomy.json
Exomy_Hardware/EasyEda/offline_projects_backup/MyExomy/20210925_140259/PCB_MyExomy.json
Exomy_Hardware/EasyEda/offline_projects_backup/MyExomy/20210925_140718/PCB_MyExomy.json
Exomy_Hardware/EasyEda/offline_projects_backup/MyExomy/20210925_140722/PCB_MyExomy.json
Exomy_Hardware/EasyEda/offline_projects_backup/MyExomy/20210925_140835/PCB_MyExomy.json
Exomy_Hardware/EasyEda/offline_projects_backup/MyExomy/20210925_140952/PCB_MyExomy.json
Exomy_Hardware/EasyEda/offline_projects_backup/MyExomy/20210925_141047/PCB_MyExomy.json
Exomy_Hardware/EasyEda/offline_projects_backup/MyExomy/20220130_102405/PCB_MyExomy.json
Exomy_Hardware/EasyEda/offline_projects_backup/MyExomy/20220130_110806/PCB_MyExomy.json
Exomy_Hardware/EasyEda/offline_projects_backup/MyExomy/20220130_110947/PCB_MyExomy.json
Exomy_Hardware/EasyEda/offline_projects_backup/MyExomy/20220130_112041/PCB_MyExomy.json
Exomy_Hardware/EasyEda/offline_projects_backup/MyExomy/20220130_112343/PCB_MyExomy.json
Exomy_Hardware/EasyEda/offline_projects_backup/MyExomy/20220130_112810/PCB_MyExomy.json
Exomy_Hardware/EasyEda/offline_projects_backup/MyExomy/20220130_113115/PCB_MyExomy.json
Exomy_Hardware/EasyEda/offline_projects_backup/MyExomy/20220130_113247/PCB_MyExomy.json
Exomy_Hardware/EasyEda/offline_projects_backup/MyExomy/20220130_113929/PCB_MyExomy.json
Exomy_Hardware/EasyEda/offline_projects_backup/MyExomy/20220130_114541/PCB_MyExomy.json
Exomy_Hardware/EasyEda/offline_projects_backup/MyExomy/20220130_115327/PCB_MyExomy.json
Exomy_Hardware/EasyEda/offline_projects_backup/MyExomy/20220130_120928/PCB_MyExomy.json
Exomy_Hardware/EasyEda/offline_projects_backup/MyExomy/20220130_121248/PCB_MyExomy.json
Exomy_Hardware/EasyEda/offline_projects_backup/MyExomy/20220130_123419/PCB_MyExomy.json
Exomy_Hardware/EasyEda/offline_projects_backup/MyExomy/20220130_125611/PCB_MyExomy.json
Exomy_Hardware/EasyEda/offline_projects_backup/MyExomy/20220130_125622/PCB_MyExomy.json
Exomy_Hardware/EasyEda/offline_projects_backup/MyExomy/20220130_163953/PCB_MyExomy.json
Exomy_Hardware/EasyEda/offline_projects_backup/MyExomy/20220130_163954/PCB_MyExomy.json
