rbakx/MyExoMy/ExoMy_Software_ROS2/exomy/exomy/exomy/motor_node.py

#!/usr/bin/env python
import rclpy
from rclpy.node import Node
from rclpy.timer import Timer
from exomy_msgs.msg import MotorCommands
from .motors import Motors
from . import i2c


class MotorNode(Node):
    """Convert Motor Commands"""

    def __init__(self):
        """Init Node."""
        self.node_name = 'motor_node'
        super().__init__(self.node_name)

        # Initialize parameters
        self.parameters = {}
        self.init_params()

        # Create Subscription
        # ReneB: Set history depth to 1, otherwise the motors will not stop immediately.
        self.subscription = self.create_subscription(
            MotorCommands,
            '/exomy_pkg/motor_commands',
            self.callback, 1)
        self.subscription  # prevent unused variable warning

        # Create motor instances
        self.motors = Motors(self.parameters)

        # Create watchdog timer
        self.watchdog_timer = self.create_timer(1.0, self.watchdog)

        self.get_logger().info('\t{} STARTED.'.format(self.node_name.upper()))

    def __del__(self):
        self.motors.stopMotors()

    def init_params(self):
        """Initialize Parameters."""
        # At the moment we have to define the parameters here, as reading and using them from the yaml file as suggested at
        # https://roboticsbackend.com/rclpy-params-tutorial-get-set-ros2-params-with-python/ does not seem to work.

        # Pin numbers for motors on PWM board
        self.declare_parameter('pin_drive_fl', 11)
        self.parameters['pin_drive_fl'] = self.get_parameter(
            'pin_drive_fl').value
        self.declare_parameter('pin_steer_fl', 14)
        self.parameters['pin_steer_fl'] = self.get_parameter(
            'pin_steer_fl').value

        self.declare_parameter('pin_drive_fr', 4)
        self.parameters['pin_drive_fr'] = self.get_parameter(
            'pin_drive_fr').value
        self.declare_parameter('pin_steer_fr', 1)
        self.parameters['pin_steer_fr'] = self.get_parameter(
            'pin_steer_fr').value

        self.declare_parameter('pin_drive_cl', 10)
        self.parameters['pin_drive_cl'] = self.get_parameter(
            'pin_drive_cl').value
        self.declare_parameter('pin_steer_cl', 15)
        self.parameters['pin_steer_cl'] = self.get_parameter(
            'pin_steer_cl').value

        self.declare_parameter('pin_drive_cr', 5)
        self.parameters['pin_drive_cr'] = self.get_parameter(
            'pin_drive_cr').value
        self.declare_parameter('pin_steer_cr', 0)
        self.parameters['pin_steer_cr'] = self.get_parameter(
            'pin_steer_cr').value

        self.declare_parameter('pin_drive_rl', 13)
        self.parameters['pin_drive_rl'] = self.get_parameter(
            'pin_drive_rl').value
        self.declare_parameter('pin_steer_rl', 12)
        self.parameters['pin_steer_rl'] = self.get_parameter(
            'pin_steer_rl').value

        self.declare_parameter('pin_drive_rr', 2)
        self.parameters['pin_drive_rr'] = self.get_parameter(
            'pin_drive_rr').value
        self.declare_parameter('pin_steer_rr', 3)
        self.parameters['pin_steer_rr'] = self.get_parameter(
            'pin_steer_rr').value

        # PWM values
        # Those values highly depend on the motors and pwm board used
        # Check out the wiki for further explanation
        self.declare_parameter('steer_pwm_neutral_fl', 280)
        self.parameters['steer_pwm_neutral_fl'] = self.get_parameter(
            'steer_pwm_neutral_fl').value
        self.declare_parameter('steer_pwm_neutral_fr', 275)
        self.parameters['steer_pwm_neutral_fr'] = self.get_parameter(
            'steer_pwm_neutral_fr').value
        self.declare_parameter('steer_pwm_neutral_cl', 275)
        self.parameters['steer_pwm_neutral_cl'] = self.get_parameter(
            'steer_pwm_neutral_cl').value
        self.declare_parameter('steer_pwm_neutral_cr', 265)
        self.parameters['steer_pwm_neutral_cr'] = self.get_parameter(
            'steer_pwm_neutral_cr').value
        self.declare_parameter('steer_pwm_neutral_rl', 275)
        self.parameters['steer_pwm_neutral_rl'] = self.get_parameter(
            'steer_pwm_neutral_rl').value
        self.declare_parameter('steer_pwm_neutral_rr', 270)
        self.parameters['steer_pwm_neutral_rr'] = self.get_parameter(
            'steer_pwm_neutral_rr').value

        # PWW range around steering neutral position
        self.declare_parameter('steer_pwm_range', 250)
        self.parameters['steer_pwm_range'] = self.get_parameter(
            'steer_pwm_range').value

        # PWM value for the stop position of driving motors
        self.declare_parameter('drive_pwm_neutral', 307)
        self.parameters['drive_pwm_neutral'] = self.get_parameter(
            'drive_pwm_neutral').value

        # PWW range around driving neutral position
        self.declare_parameter('drive_pwm_range', 100)
        self.parameters['drive_pwm_range'] = self.get_parameter(
            'drive_pwm_range').value

    def callback(self, cmds):
        self.motors.setSteering(cmds.motor_angles)
        self.motors.setDriving(cmds.motor_speeds)

        self.watchdog_timer.cancel()
        # If this timer runs longer than the duration specified,
        # then watchdog() is called stopping the driving motors.
        # Preventing the robot to go on driving if connection is lost.
        # ReneB: Decreased watchdog timeout from 2 seconds to 1.0 second.
        # This to make sure that if the Wifi connection drops the ExoMy stops in 0.5 second.
        # It still is possible that after the ExoMy stops it starts moving again due to delayed Wifi packet delivery.
        self.watchdog_timer = self.create_timer(1.0, self.watchdog)

    def watchdog(self):
        self.get_logger().info('Watchdog fired. Stopping driving motors.')
        self.motors.stopMotors()
        with i2c.i2c_lock:
            i2c.write_byte(i2c.slaveAddressAtmega328P, 0, 10)  # Send motion command to Arduino to prevent putting MyExoMy to sleep.


def main(args=None):
    rclpy.init(args=args)

    try:
        motor_node = MotorNode()
        try:
            rclpy.spin(motor_node)
        finally:
            motor_node.destroy_node()
    except KeyboardInterrupt:
        pass
    finally:
        rclpy.shutdown()


if __name__ == "__main__":
    main()
