rbakx/MyExoMy/(commit log)

2021-04-10 Created Exomy power board
    [PCB_MyExomy.json]
2021-04-11 generated PCB
    [PCB_MyExomy.json]
2021-04-11 Finished power board design
    [PCB_MyExomy.json]
2021-04-11 BD240 -> TIP32C
    [PCB_MyExomy.json]
2021-04-17 added printer files
    [P01_Chassis_ReneB.FCStd, P12_Solar_Panel_Left_ReneB.FCStd, P12_Solar_Panel_Right_ReneB.FCStd, P21_Mast_Default_ReneB.FCStd]
2021-04-18 added prints
    [P01_Chassis_ReneB.FCStd, P11_Top_Default_ReneB.FCStd, P12_Solar_Panel_Left_ReneB.FCStd, P12_Solar_Panel_Right_ReneB.FCStd]
2021-04-18 updated prints
    [P01_Chassis_ReneB.FCStd, P11_Top_Default_ReneB.FCStd, P13_Port_Cover_Default_ReneB.FCStd]
2021-04-20 updated solar panels
    [P12_Solar_Panel_Left_ReneB.FCStd, P12_Solar_Panel_Right_ReneB.FCStd]
2021-04-25 updated schematic and chassis
    [P01_Chassis_ReneB.FCStd, PCB_MyExomy.json]
2021-05-02 Added new prints and solar panel voltage measurement
    [PCB_MyExomy.json]
2021-05-04 Added RGB mounting hole
    [P11_Top_ReneB.FCStd, P30_Wheel_Left_Reneb.FCStd, P30_Wheel_Right_Reneb.FCStd, RPI_Spacer.FCStd]
2021-05-04 Added battery and solarpanel voltage reporting
2021-05-05 Changed to flat solar panel
    [P12_Solar_Panel_Left_Flat_ReneB.FCStd, P12_Solar_Panel_Left_ReneB.FCStd, P12_Solar_Panel_Left_Slope_ReneB.FCStd, P12_Solar_Panel_Right_Flat_ReneB.FCStd, P12_Solar_Panel_Right_ReneB.FCStd, P12_Solar_Panel_Right_Slope_ReneB.FCStd, P21_Mast_Flat_ReneB.FCStd, P21_Mast_ReneB.FCStd]
2021-05-06 Added measuring and displaying solarpanel current
2021-05-07 changed mast printer settings
2021-05-07 changed printer settings
2021-05-16 Added WifiHolder design
    [WifiHolder.FCStd]
2021-05-23 Added Pi H264 To Browser
    [WifiHolder.FCStd, Wifi_Holder_USB.FCStd]
2021-05-26 switch on and off uv4l in robot_node.py
2021-05-28 Switched from UV4L to Rpi-WebRTC-Streamer
2021-06-07 switch to Chrome-WebRTC
2021-06-07 fixed WebRTC reconnect when refreshing webpage
    [own_util.py]
2021-06-08 added info on camera resolution
2021-07-17 Added hole in chassis for 3V wire
2021-07-17 Added LCD display box 3D design
    [LCD_Display_Box_ReneB.FCStd, LCD_Display_Support_ReneB.FCStd]
2021-07-20 Reorganized repository
    [A07_Neck_Decoration_Default.STEP, AI_Chassis_BoM.csv, AI_Head_BoM.csv, AI_Integration_BoM.csv, AI_Rear_Bogie_BoM.csv, AI_Side_Bogie_BoM.csv, AI_Top_BoM.csv, Battery_Cover_ReneB.FCStd]
2021-09-13 Added RC-WuTRx-433 module
    [PCB_MyExomy.json]
2021-09-13 correction OMRON relais label
    [PCB_MyExomy.json]
2021-09-13 Added audio jack hole
2021-09-25 Added sleep disable
    [PCB_MyExomy.json]
2021-09-26 updated text on sleep mode
    [PCB_MyExomy.json]
2021-09-26 Fixed low power by disabling TwoWire
    [MyExomy.cpp]
2021-09-27 Added explicit disabling of SDA and SCL pull-up resistors on Atmega328P
    [PCB_MyExomy.json]
2021-09-27 Simpler disabling I2C pull-up resistors
2021-10-03 Added Exomy Wakeup Transmitter box
    [Wakeup_Transmitter_Box.FCStd, Wakeup_Transmitter_Lid.FCStd]
2021-10-05 Added Wakeup Transmitter box print files
    [Wakeup_Transmitter_Box.FCStd, Wakeup_Transmitter_Lid.FCStd]
2021-10-06 updated print files
    [Wakeup_Transmitter_Lid.FCStd]
2021-10-09 Updated Wakeup Transmitter box
    [Wakeup_Transmitter_Lid.FCStd]
2021-10-09 update on antenna length
    [Wakeup_Transmitter_Lid.FCStd]
2021-10-10 Added Wakeup Transmitter circuit
    [PCB_MyExomy.json, Wakeup_Transmitter_Lid.FCStd]
2022-01-07 correction of ROS2 version
    [config_drive_motor_neutral.py, config_motor_pins.py, config_steer_motor_neutral.py, gamepad_parser_node.py, motor_node.py]
2022-01-09 fixed motor control and parameter settings
    [motor_node.py]
2022-01-30 Increase RPi voltage with Shottky diode
    [PCB_MyExomy.json]
2023-07-01 Correction of ROS2 scripts
    [config_drive_motor_neutral.py, config_motor_pins.py, config_steer_motor_neutral.py, exomy.yaml, gamepad_parser_node.py, i2c.py]
2023-07-02 fix of wakeup transmitter, correction of start.sh
    [main.cpp]
2023-07-21 fixed motors stopping ecery 5 seconds
    [motor_node.py]
2023-07-22 Fixed I2C I/O error and updated document
    [i2c.py, motor_node.py, motors.py, robot_node.py]
